Azmi0205/Bachelorarbeit/06Documentation/KickOff_Bachelorarbeit.pptx

## Kick-Off Bachelorarbeit

- 08.07.2026

- Azmi Beyrouti

Development and Implementation of a Permanent Magnet Synchronous Motor Control Platform

## Slide 2

Presentation title | Confidentiality rating © Diehl Aerospace – a Joint Diehl Thales Company

- Kick-Off Bachelorarbeit

- 01

- Vorstellung des Themas

05

Fragen zum Vorgehen

- 02

- Arbeitspunkte

- 03

- Projektabsicherung & Zielsetzung

- 04

- Ist-Stand

## Thema

- Kick-Off Bachelorarbeit

Development and Implementation of a Permanent Magnet Synchronous Motor Control Platform
Design einer Kontroll-Test-Plattform
- Soll erlauben PMSM-Motoren anzuschließen und Regelungsstrategien zu testen
  - Hierfür Integration verschiedener Sensoren
  - Anbindung an verschiedene Schnittstellen (weitere Sensoren, Kommunikation)
- Kompatibilität mit Wittenstein TPM Flight-Actuator
- Kompatibilität mit MatLab / Simulink Programmen
- Kommunikation mit Diehl Aerospace Flight Control Computer (FCC)
- Vorbild (Kommunikation & Performance): Volz DA 30-HT Aktuator

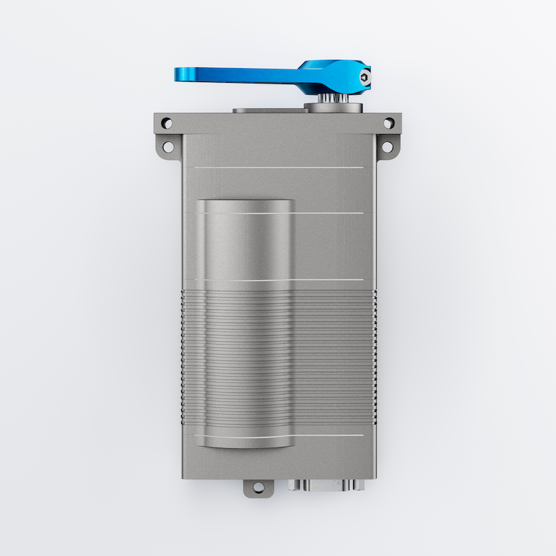
[picture p28: figure]

Volz DA 30-HT

## Arbeitspunkte

- Kick-Off Bachelorarbeit

Arbeitspunkte
  - (Definition von Requirements)
  - Design eines elektrischen Schaltplans
  - Layout & Bestellen einer Platine
  - Design und Implementierung des Codes
  - Testen und Analyse von Regelungen [Wenn die Zeit Reicht]
Aus T3000
  - Bauteilauswahl der elektrischen Schaltung
Bereits geschehen
  - Design des Schaltplans
  - Überprüfung der Kompatibilität durch Pinzuweisung
  - Erstes Layout

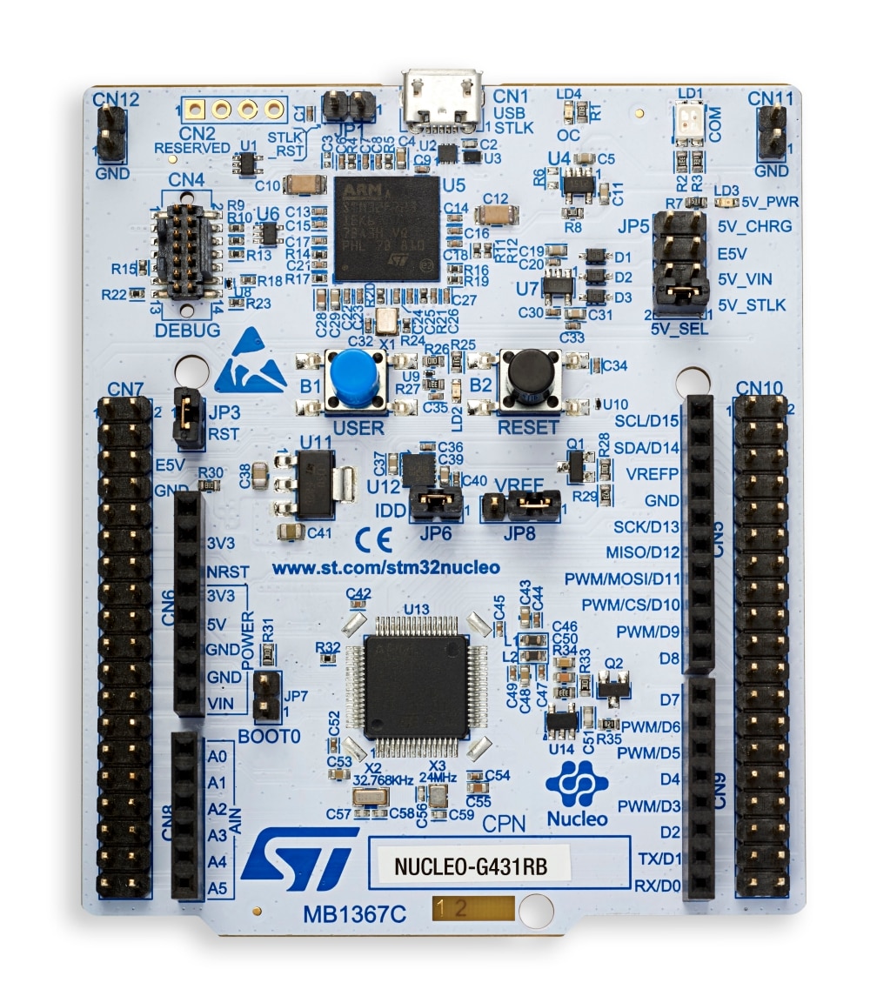
[picture p29: figure]
NUCLEO-G431RB | Product - STMicroelectronics

STM32 Nucleo G431RB

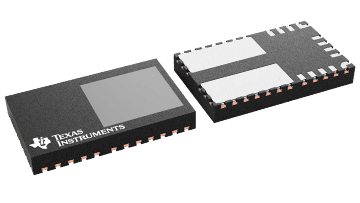
[picture p30: figure]
LMG2100R044 data sheet, product information and support | TI.com

TI LMG2100

## Absicherung & Zielsetzung

- Kick-Off Bachelorarbeit

Erstes elektronisches Design
  - Wenig Erfahrung
  - Erhöhtes Fehlerpotential
  - Nächste Iteration dauert Lange (Design & Bestellvorgang)
    - Risiko
Lösung -> Fallback
  - Inverter-Shield zur Regelung
  - Deckt Hauptfunktionen bereits ab
  - Möglich schon ohne Platine Code zu schreiben & zu Testen

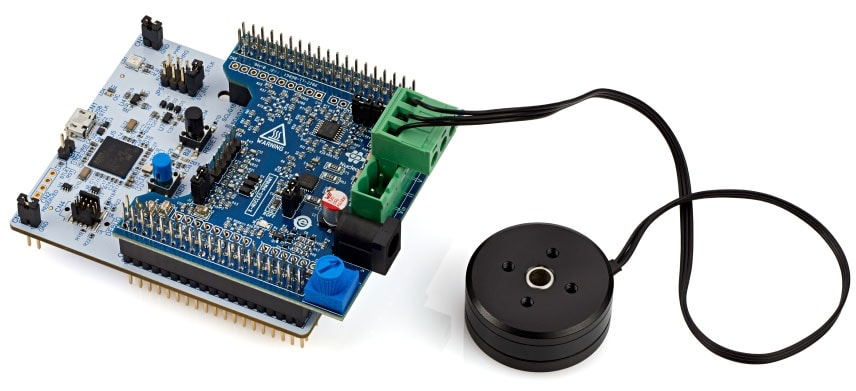
[picture p31: figure]

X-NUCLEO-IHM16M1

Zielsetzung
Ziel der Bachelorarbeit ist die Konzeption, Entwicklung und Inbetriebnahme einer modularen Kontroll-Test-Plattform für Permanentmagnet-Synchronmotoren. Dabei sollen die elektrische Hardware, die notwendigen Schnittstellen sowie die grundlegende Software umgesetzt werden, um PMSM-Motoren anzusteuern und verschiedene Regelungskonzepte testen und analysieren zu können.

## Ist-Stand

- Kick-Off Bachelorarbeit

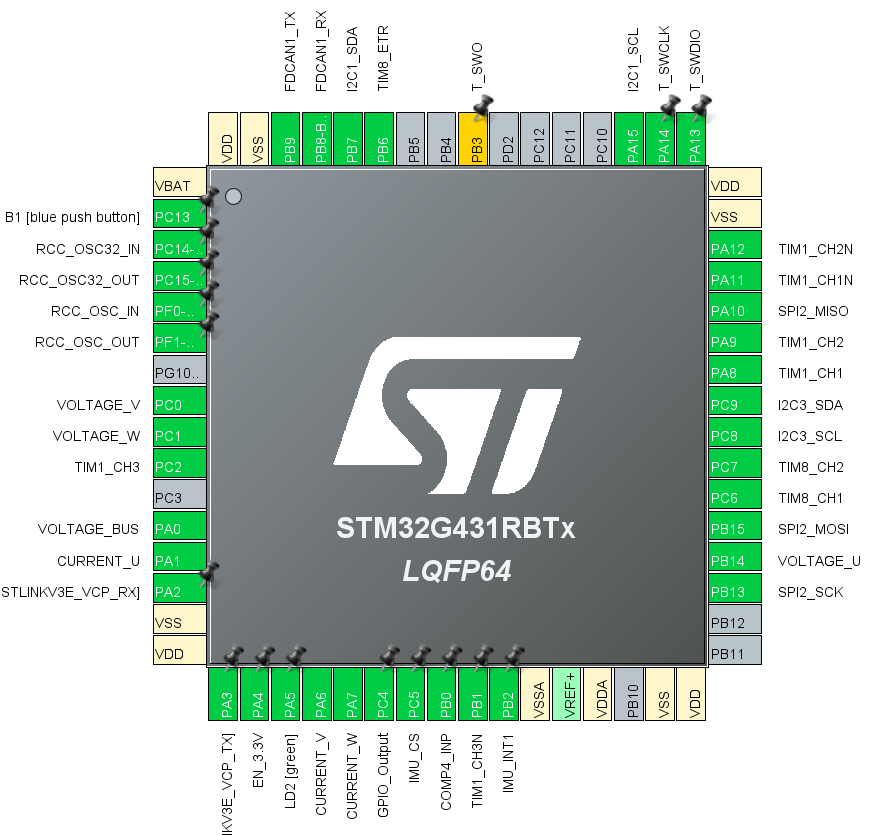
[picture p32: figure]

STM32 Pinzuweisung

Schaltplan einer Halbbrücke

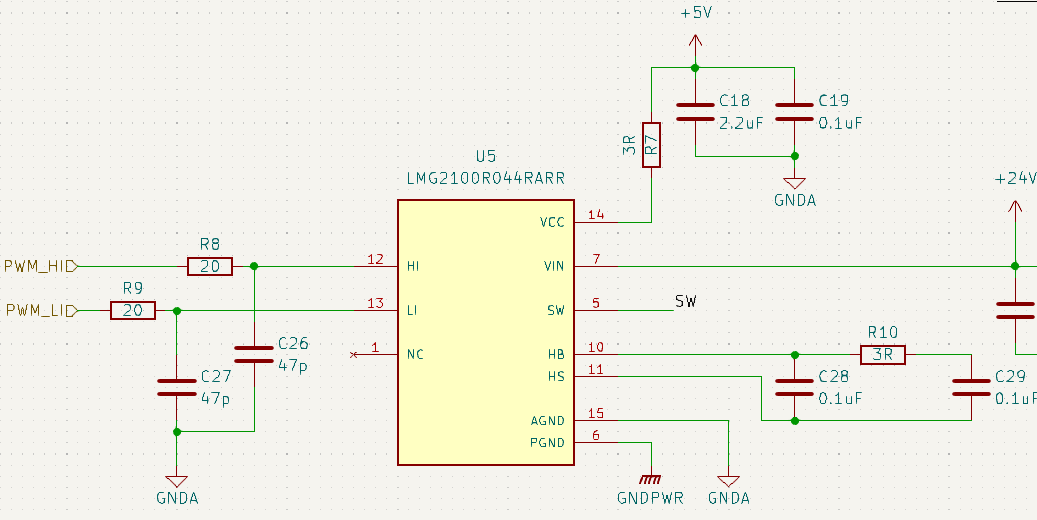
[picture p33: figure]
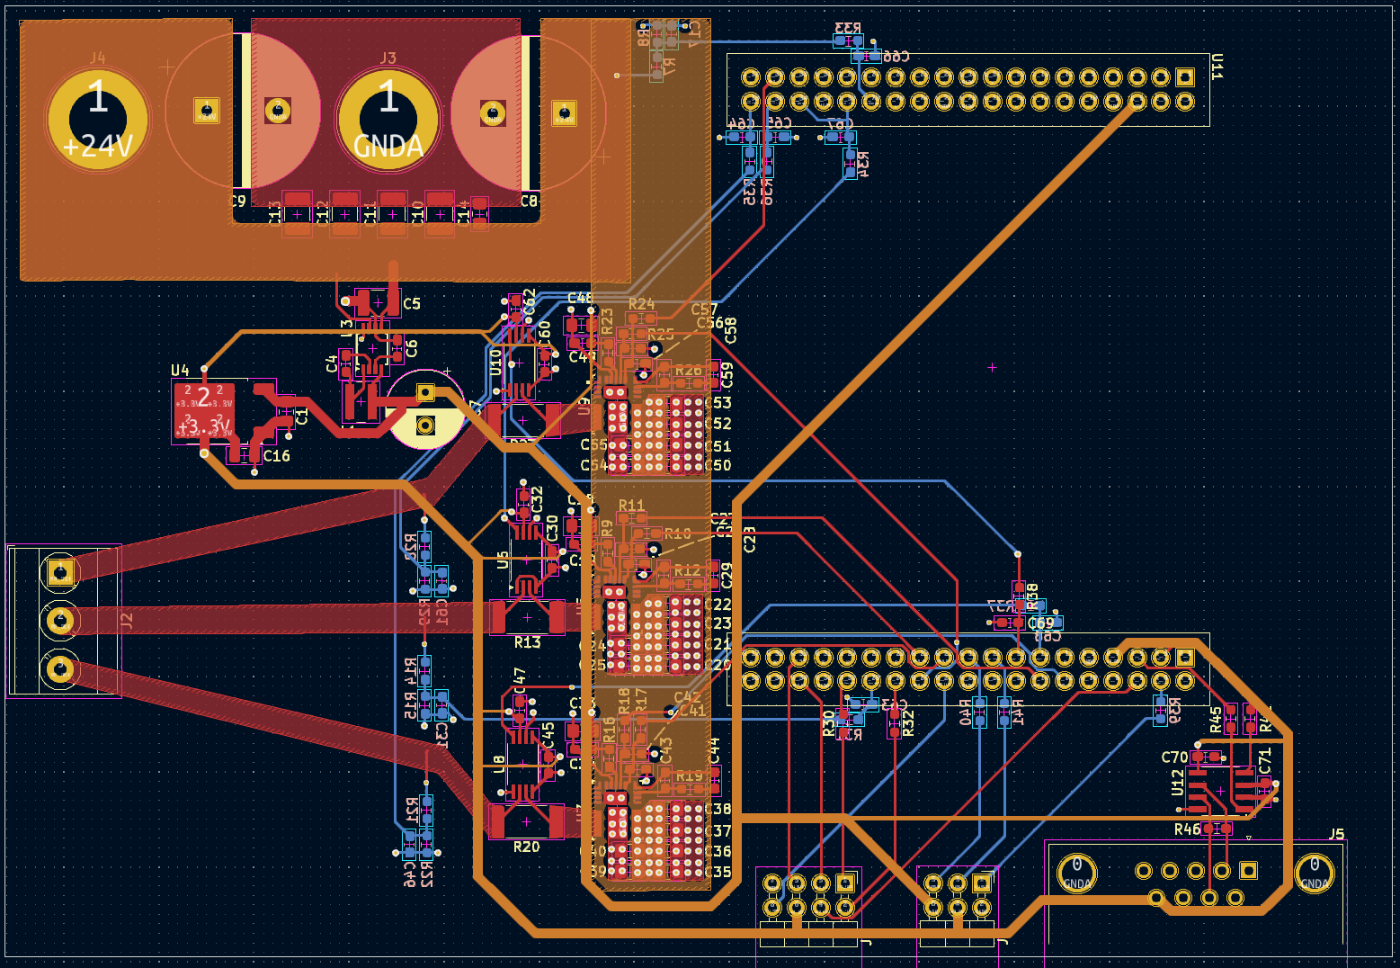
[picture p34: figure]

Layout der Testplattform

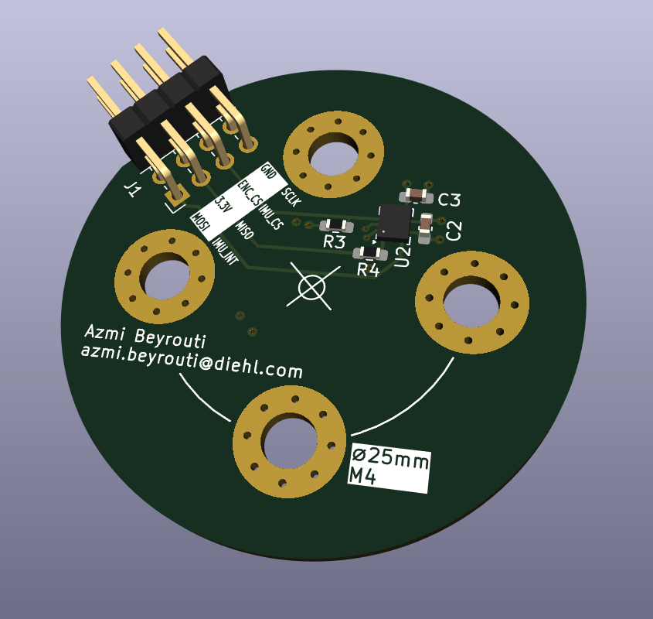
[picture p35: figure]

3D-Modell des Sensor-Moduls
