Azmi0205/Bachelorarbeit/09Bilder/SimulinkModels/Mechanical Dynamics.pdf

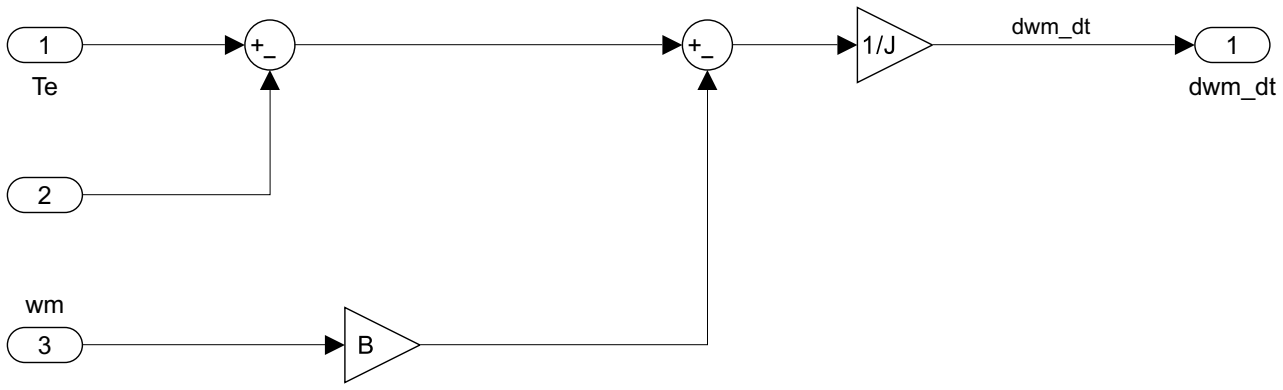
[picture p100: figure]
