Azmi0205/Bachelorarbeit/02PCB_Design/03BoMs/Bestückungsplan.jpg

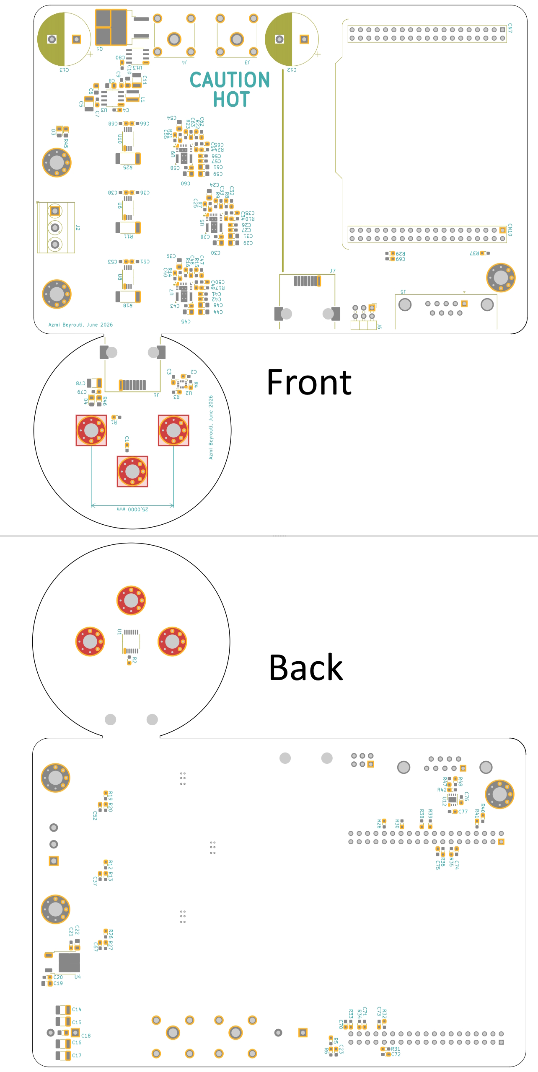
02PCB_Design/03BoMs/Bestückungsplan.jpg
