Azmi0205/Bachelorarbeit/04Experiments/6SC_High_Spectrum.png

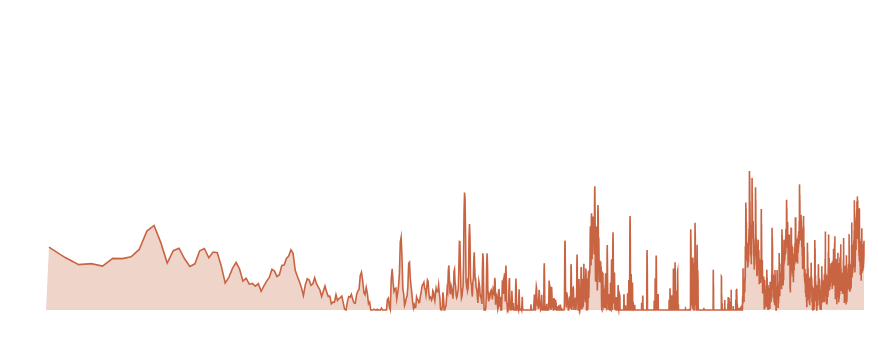
04Experiments/6SC_High_Spectrum.png
