Azmi0205/Bachelorarbeit/04Experiments/AudibleNoiseSpectrum/FOC_High_Spectrum.png

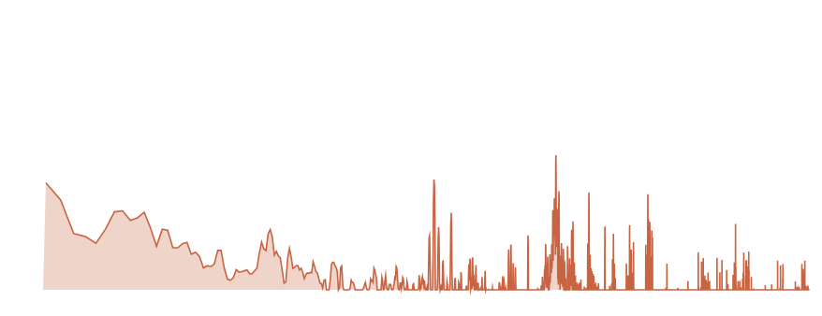
04Experiments/AudibleNoiseSpectrum/FOC_High_Spectrum.png
