Azmi0205/Bachelorarbeit/09Bilder/FOC_Block.png

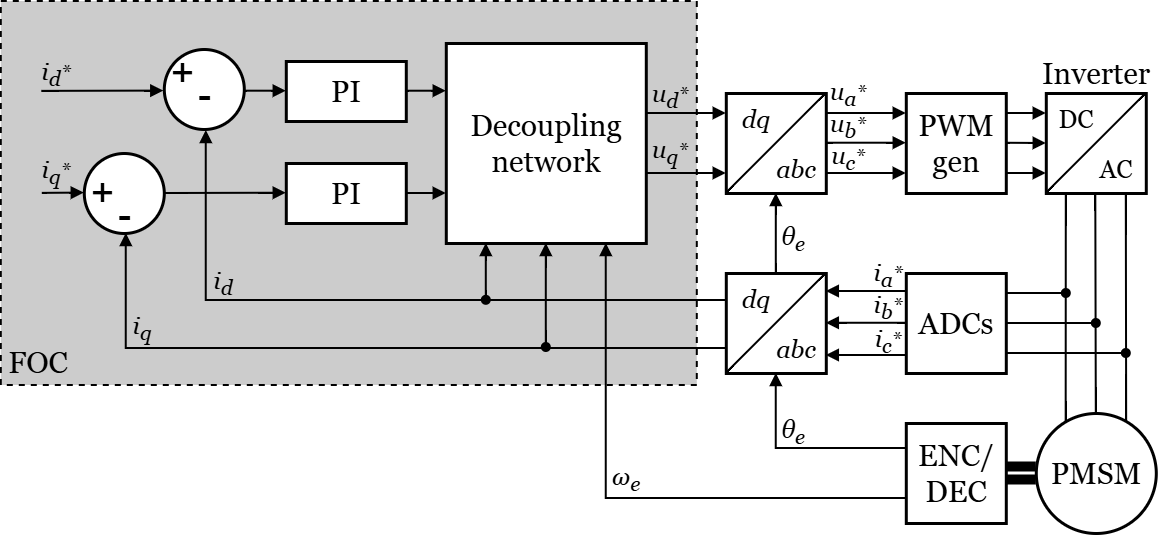
09Bilder/FOC_Block.png
