Azmi0205/Bachelorarbeit/09Bilder/HardwareOverview.png

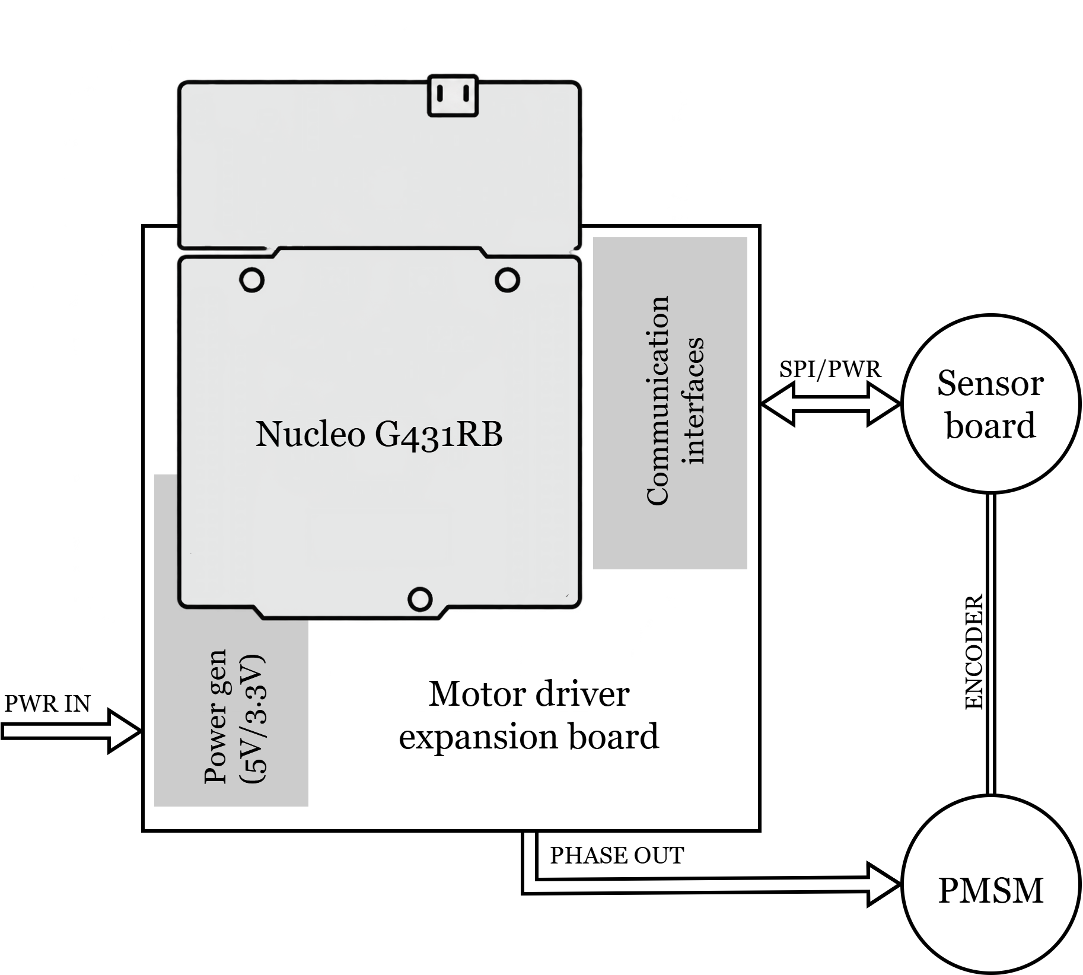
09Bilder/HardwareOverview.png
