Azmi0205/Bachelorarbeit/09Bilder/InputOutputConfiguration.png

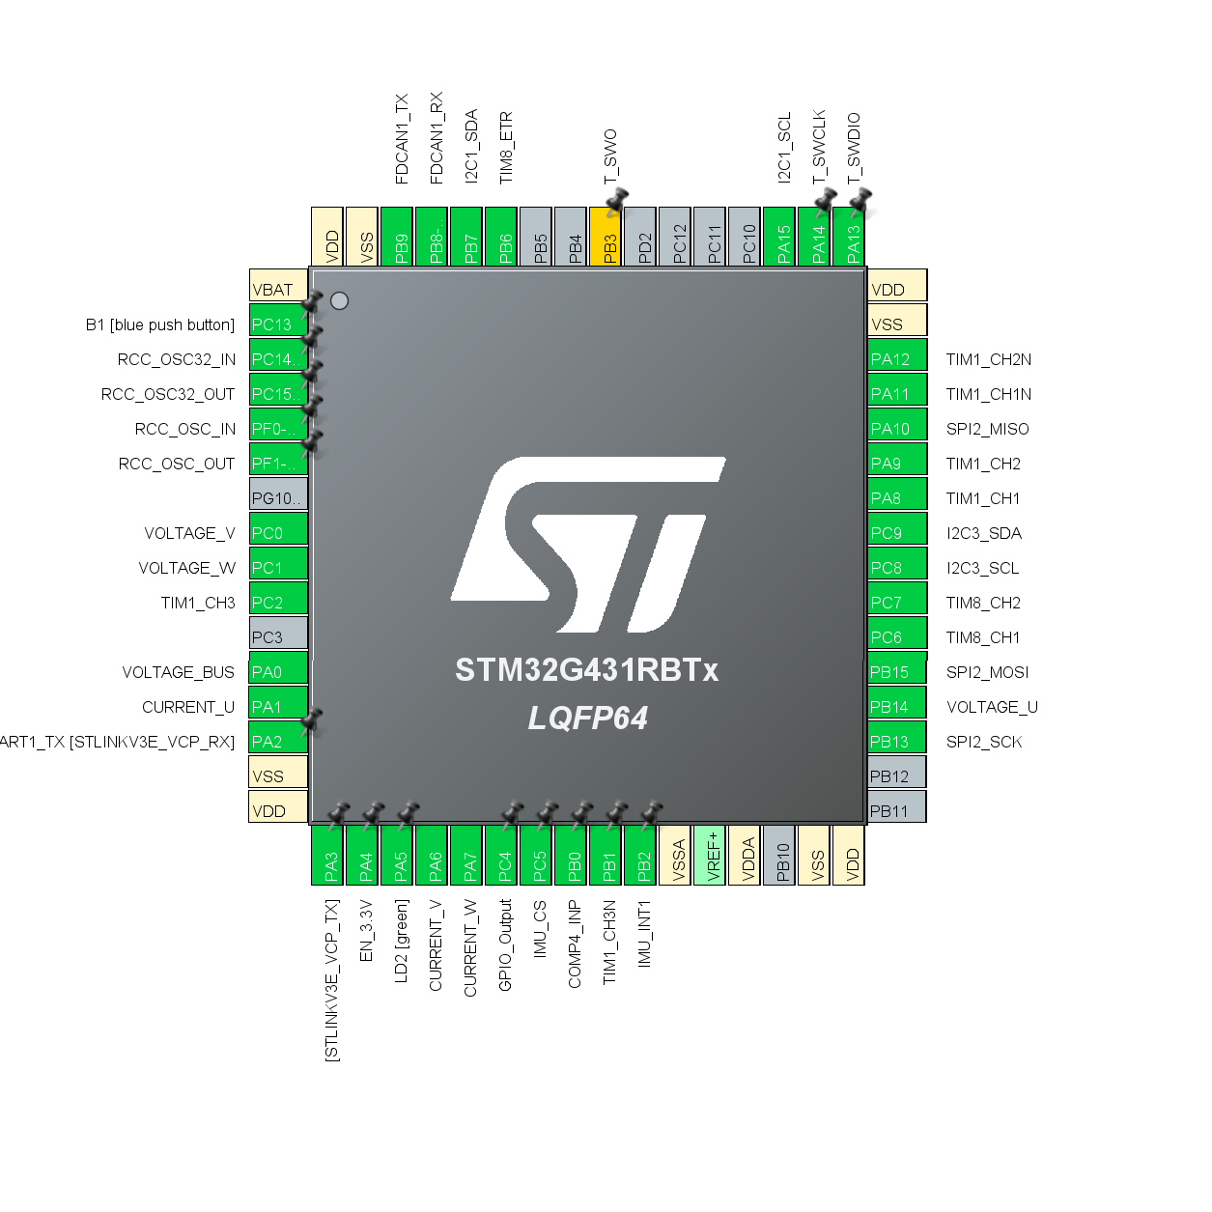
09Bilder/InputOutputConfiguration.png
