Azmi0205/Bachelorarbeit/09Bilder/Nucleo_Symbole.png

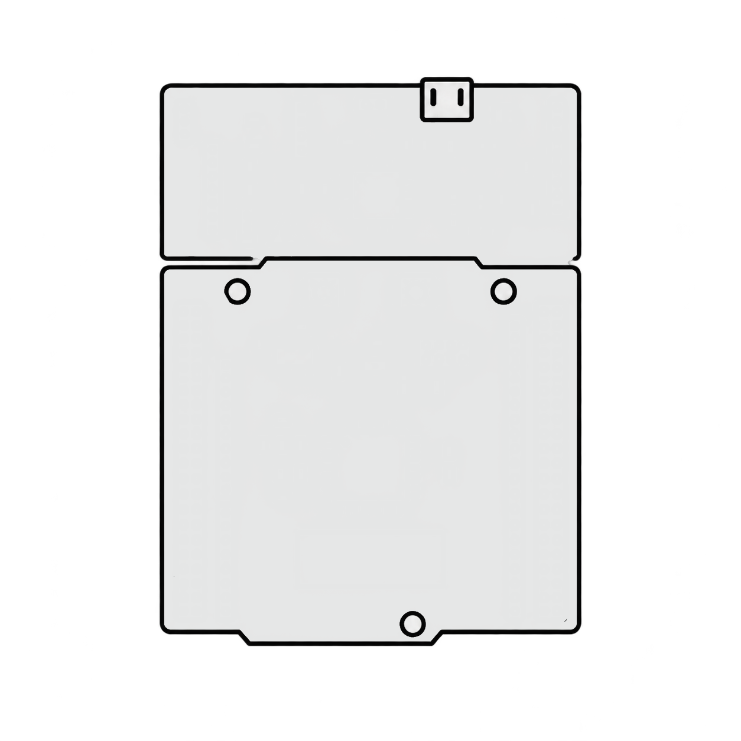
09Bilder/Nucleo_Symbole.png
