Azmi0205/Bachelorarbeit/09Bilder/polePairs.png

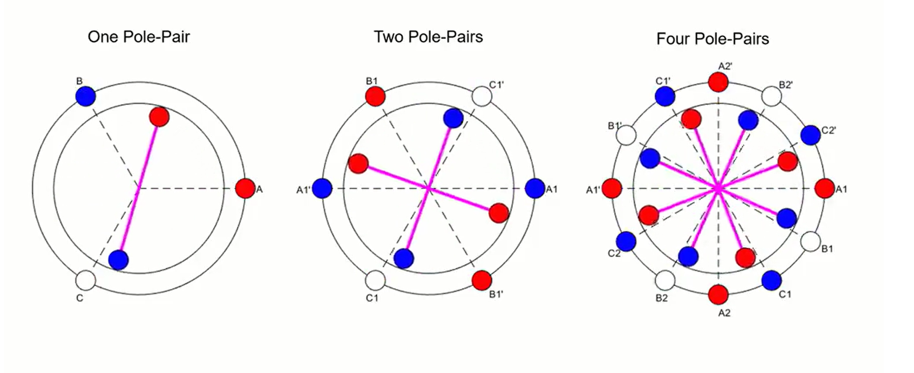
09Bilder/polePairs.png
