Azmi0205/Bachelorarbeit/09Bilder/PWM_Sinusoidal_Averaging.png

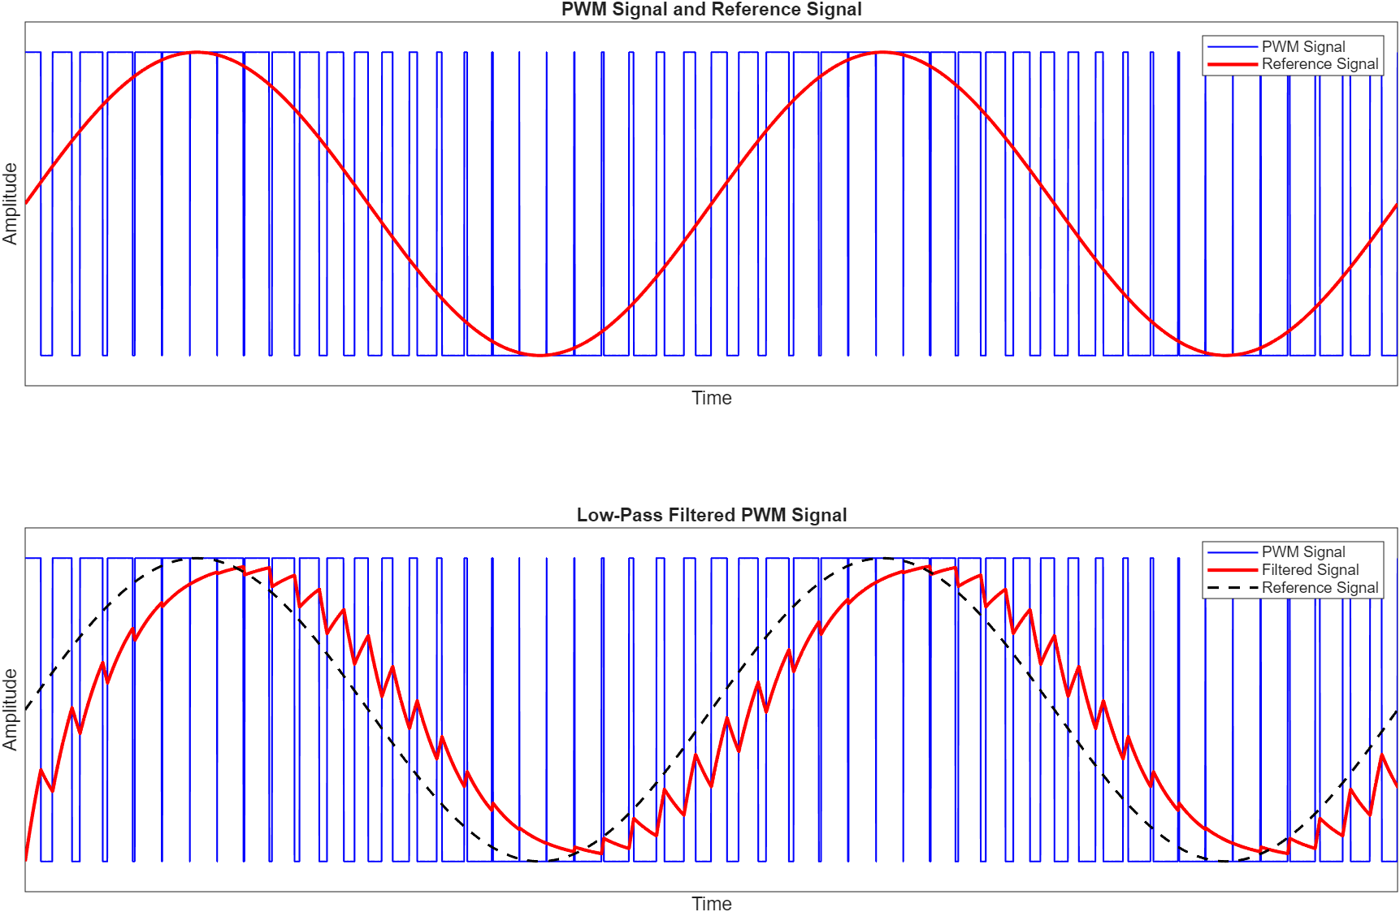
09Bilder/PWM_Sinusoidal_Averaging.png
