Azmi0205/Bachelorarbeit/09Bilder/Simulink_Scopes.png

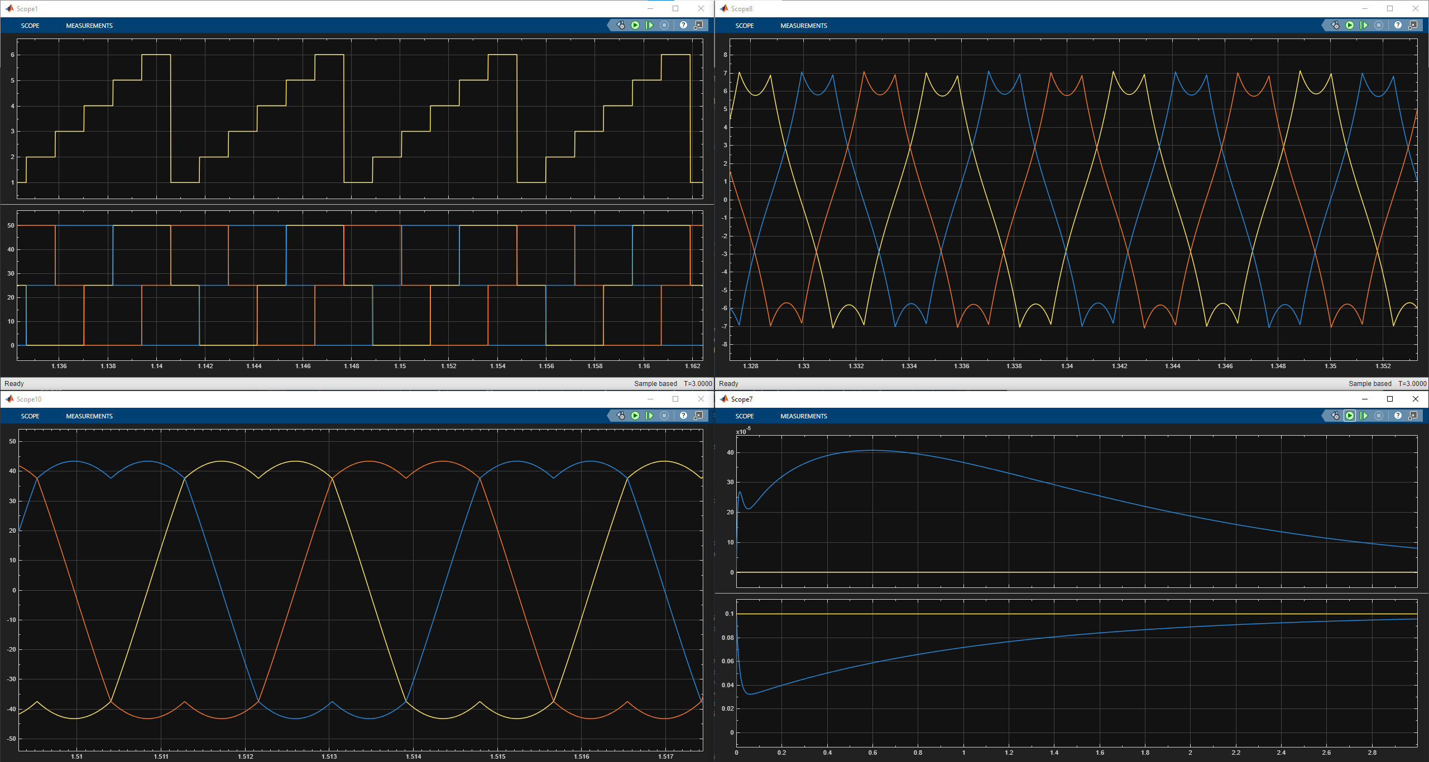
09Bilder/Simulink_Scopes.png
