Azmi0205/Bachelorarbeit/09Bilder/SinusoidalCommutation_Block.png

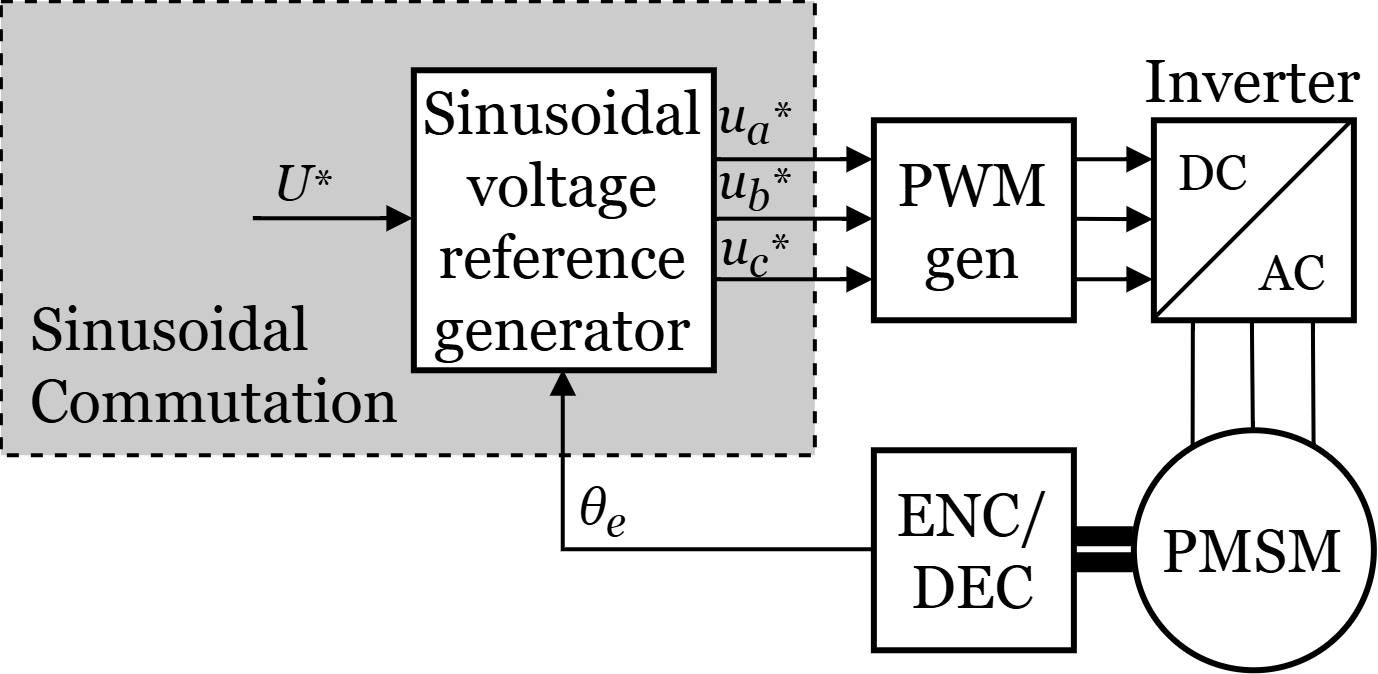
09Bilder/SinusoidalCommutation_Block.png
