Azmi0205/Bachelorarbeit/09Bilder/svpwm_pwm_switching_pattern.png

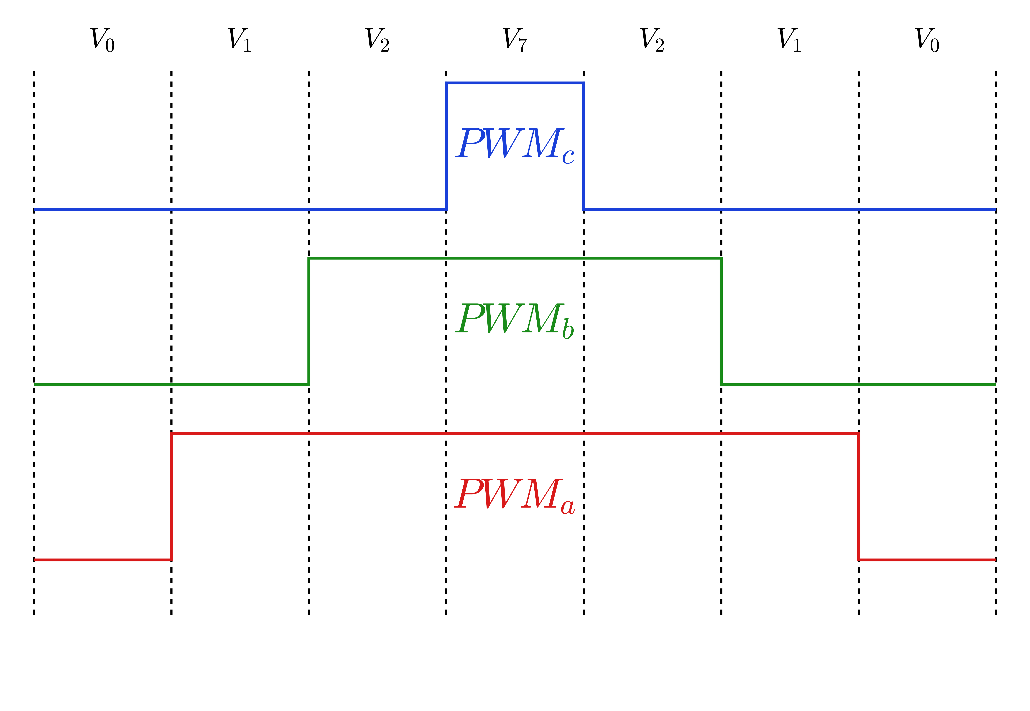
09Bilder/svpwm_pwm_switching_pattern.png
