Azmi0205/Bachelorarbeit/02PCB_Design/03BoMs/BetaLayout_BOM_Rückfrage.pdf

Part | Value | Device | Package | Description | Description2 | Qty | Place_YES
| /NO | Provided_b y_customer _YES/NO | Distributor | Ordernumber | Remarks_Customer
R1,R3,R19,R12,R5,R26 | 100k | RT0603BRD07100KL | R_0603 | Yageo RT Dünnschicht SMD-Widerstand 100 kΩ ±0.1 % / 0.1 W 25 ppm/°C | | 6 | YES | NO | Mouser | 603-RT0603BRD07 100KL | Changed Distributor
C12,C13 | 470uF | UPM2A471MHD | CP_Radial_D16.0mm | Aluminium Electrolytic Capacitors - Radial Leaded 100volts 470uF AEC-Q200 | | 2 | YES | NO | Mouser | 647-UPM2A471MH D | Changed Device + Distributor
U1 | AS5047P-ATSM | AS5047D-ATSM | TSSOP-14_4.4x5mm_P0.65mm | ams OSRAM 14-Bit-Magnetischer Drehpositionssensor auf der Achse 1-Achsen Oberfläche 3 V 7V SPI | Alternative: ams OSRAM Hall-Effekt-Sensor 1-Achsen Oberfläche 3 V 5.5V Pulsbreitenmodulation , UVW, SPI Achse CMOS TSSOP 14-Pin | 1 | YES | NO | Mouser | 985-AS5047D-ATSM | Changed Device (Use the older D-Variant of the Chip) + Distributor
R41,R48,R40,R47 | 0R | CRCW06030000Z0TAH P | R_0603 | Thick Film Resistors - SMD CRCW0603-HP 0R0 RT1 | | 4 | YES | NO | Mouser | 71-CRCW0603000 0Z0TAH | Changed Device + Distributor
