Azmi0205/Bachelorarbeit/02PCB_Design/03BoMs/BoM_Großteile.xlsx

BILL OF MATERIALS
Item to be created: |  | Motorcontrol Testing Rig
COMPONENT | DESCRIPTION | QTY | COST PER UNIT | SELLER | Note | Link
STM NUCLEO-G431RB | STM G431RB Mikrocontroller Development Board | 2 | 13.92 € | RS Components | - | https://de.rs-online.com/web/p/entwicklungstools-microcontroller/1962536
P-Nucleo-IHM03 | Entwicklungsbausatz inklusive NUCLEO G431RB | 1 | 72.56 € | RS Components | Nicht unbedingt nötig (bereits selbst bestellt) Wenn nicht: lieber noch einen STM NUCLEO-G431RB mehr | https://de.rs-online.com/web/p/entwicklungstools-fur-energie-motor-und-robotik/1962538
Texas Instruments LMG2100R044 | GaN-Halbbrücken Integrated-Power-Module inklusive Gate-Driver | 8 | 7.38 € | Mouser | - | https://www.mouser.de/ProductDetail/Texas-Instruments/LMG2100R044RARR?qs=ZcfC38r4PovtUeqDI2WsKQ%3D%3D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
Pilotix 6210 210KV | BLDC Motor mit offen gelegter Welle und hoher Polpaarzahl und übersetzung 1:1 | 2 | 128.30 € | Hobbydrone | Eigenschaften wichtig für die Testplatform | https://www.hobbydrone.cz/de/motor-pilotix-6210-210kv/
D8x4mm - N48 Diametral | Neodym Scheiben Magnet diametral | 5 | 0.87 € | neomagnete | - | https://www.neomagnete.de/de/detail/index/sArticle/212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
 |  | TOTAL COST: | 420.39 €
Bei RS Components erhältlich | Nicht bei RS Components erhältlich
Nicht bei Farnell/Mouser/Reichelt/Conrad erhältlich
