Azmi0205/Bachelorarbeit/02PCB_Design/03BoMs/T300_BoM_Erweitert.xlsx

BILL OF MATERIALS
Item to be created: |  | Motorcontrol Testing Rig
Qty to create: |  | 1
COMPONENT | DESCRIPTION | BASE QTY | COST PER UNIT | SELLER | Link
Pilotix 6210 210KV | BLDC Motor | 1 | 128.30 € | Hobbydrone | https://www.hobbydrone.cz/de/motor-pilotix-6210-210kv/
AMS AS5047P | Magnetencoder | 1 | 6.47 € | Mouser | https://www.mouser.de/ProductDetail/ams-OSRAM/AS5047P-ATSM?qs=cGEy3R83DS8fzNOVLHtOgg%3D%3D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
Texas Instruments LMG2100R044 | Halbbrücken + Gate-Driver IPM | 3 | 7.38 € | Mouser | https://www.mouser.de/ProductDetail/Texas-Instruments/LMG2100R044RARR?qs=ZcfC38r4PovtUeqDI2WsKQ%3D%3D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
STM P-NUCLEO-IHM03 | Mikrocontroller, Motorcontroller Set | 1 | 62.61 € | Mouser | https://www.mouser.de/ProductDetail/STMicroelectronics/P-NUCLEO-IHM03?qs=T3oQrply3y8PZpuhOvj%2FjQ%3D%3D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
Mean Well GST280A24-C6P | Desktopnetzteil | 1 | 87.76 € | Reichelt | https://www.reichelt.com/ch/de/shop/produkt/tischnetzteil_280_w_24_v_11_67_a-171084
Analog Devices ADAD2S1210CSTZ | Resolver-Digital Converter | 1 | 29.87 € | Mouser | https://www.mouser.de/ProductDetail/Analog-Devices/AD2S1210CSTZ?qs=NmRFExCfTkHtgjtWgbRPyA%3D%3D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
TDK ICM-45605 | Inertial Measurement Unit | 1 | 4.35 € | Mouser | https://www.mouser.de/ProductDetail/TDK-InvenSense/ICM-45605?qs=HoCaDK9Nz5cq5D4Jf8QQQg%3D%3D
STM NUCLEO-G431RB | Development Board (MCU) Ersatz | 1 | 13.66 € | Mouser | https://www.mouser.de/ProductDetail/STMicroelectronics/NUCLEO-G431RB?qs=T3oQrply3y%252BHSoH%2FYfQbYw%3D%3D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
D8x4mm - N48 | Neodym Scheiben Magnet diametral | 5 | 0.87 € | neomagnete | https://www.neomagnete.de/de/detail/index/sArticle/212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
Component 11
Component 12
Component 13
Component 14
Component 15
Component 16
Component 17
Component 18
Component 19
Component 20
 |  | TOTAL COST: | 359.51 €
