Azmi0205/Bachelorarbeit/02PCB_Design/02KiCad_Lib/AS5047P-ATSM/AS5047P-ATSM.step

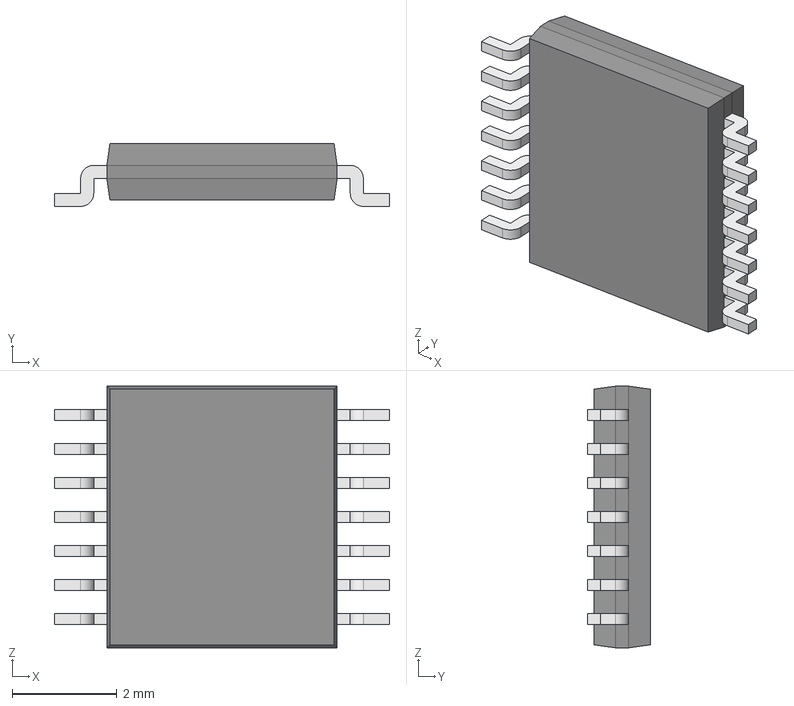
[picture p113: CAD file, 2026-01-22]
02PCB_Design/02KiCad_Lib/AS5047P-ATSM/AS5047P-ATSM.step
6.40 x 1.20 x 5.00 mm
Body001 (Mirror #1) x 7
XY-plane x 12
X-axis x 12
