Azmi0205/Bachelorarbeit/02PCB_Design/02KiCad_Lib/BM06B-GHS-TBT/BM06B-GHS-TBT.step

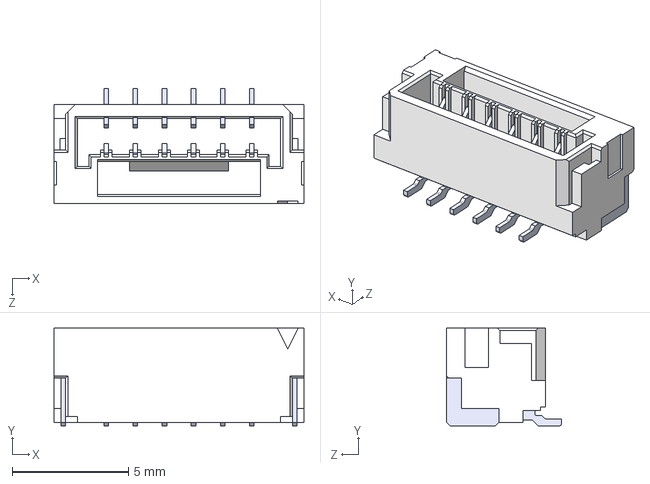
[picture p114: CAD file, 2026-01-22]
02PCB_Design/02KiCad_Lib/BM06B-GHS-TBT/BM06B-GHS-TBT.step
10.8 x 4.20 x 4.95 mm
