Azmi0205/Bachelorarbeit/02PCB_Design/02KiCad_Lib/ICM-40609-D/ICM-40609-D--3DModel-STEP-269445.STEP

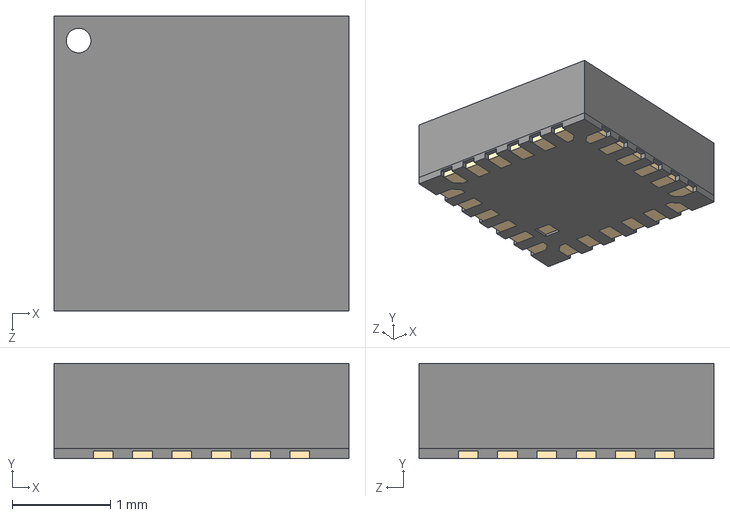
[picture p115: CAD file, 2026-01-22]
02PCB_Design/02KiCad_Lib/ICM-40609-D/ICM-40609-D--3DModel-STEP-269445.STEP
3.00 x 0.97 x 3.00 mm
