Azmi0205/Bachelorarbeit/02PCB_Design/02KiCad_Lib/ISM330BXTR/ISM330BXTR.step

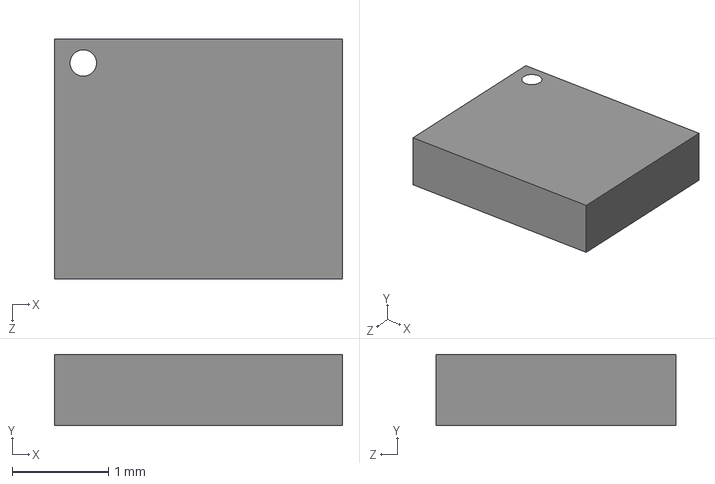
[picture p116: CAD file, 2026-01-22]
02PCB_Design/02KiCad_Lib/ISM330BXTR/ISM330BXTR.step
3.00 x 0.74 x 2.50 mm
