Azmi0205/Bachelorarbeit/02PCB_Design/02KiCad_Lib/MTSW-104-22-L-D-265-RA/MTSW-104-22-L-D-265-RA.stp

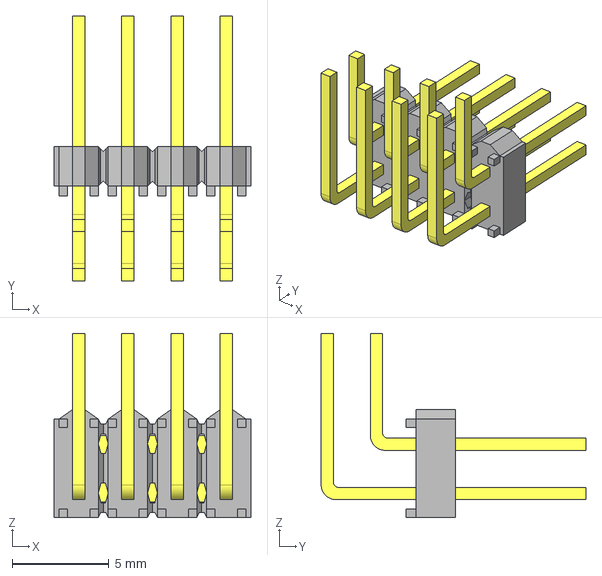
[picture p117: CAD file, 2026-01-22]
02PCB_Design/02KiCad_Lib/MTSW-104-22-L-D-265-RA/MTSW-104-22-L-D-265-RA.stp
10.2 x 13.7 x 9.50 mm
MTSW-104-22-L-D-265-RA_body
MTSW-104-22-D-265-RA
