Azmi0205/Bachelorarbeit/02PCB_Design/02KiCad_Lib/RJ45-8N-B/RJ45-8N-B.step

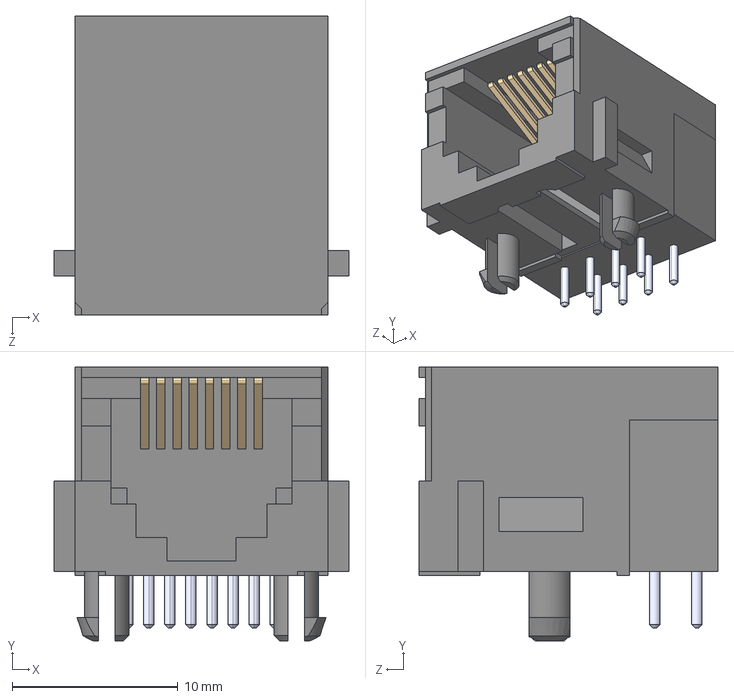
[picture p118: CAD file, 2026-07-15]
02PCB_Design/02KiCad_Lib/RJ45-8N-B/RJ45-8N-B.step
17.8 x 16.5 x 18.0 mm
