Azmi0205/Bachelorarbeit/02PCB_Design/02KiCad_Lib/Ti_LMG2100R044RARR/LMG2100R044RARR.stp

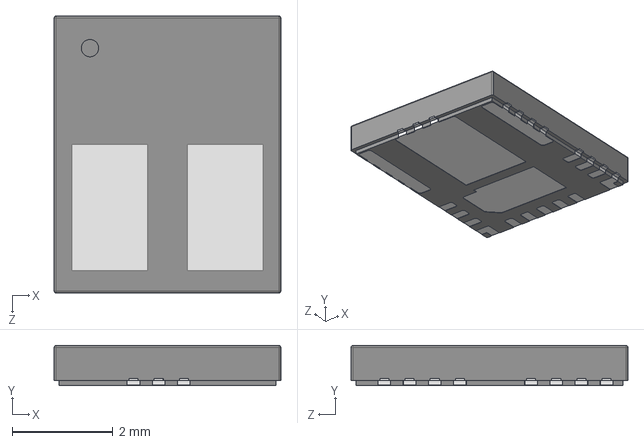
[picture p119: CAD file, 2026-07-20]
02PCB_Design/02KiCad_Lib/Ti_LMG2100R044RARR/LMG2100R044RARR.stp
4.50 x 0.8 x 5.50 mm
