Azmi0205/Bachelorarbeit/02PCB_Design/02KiCad_Lib/FCR7350R/FCR7350R.step

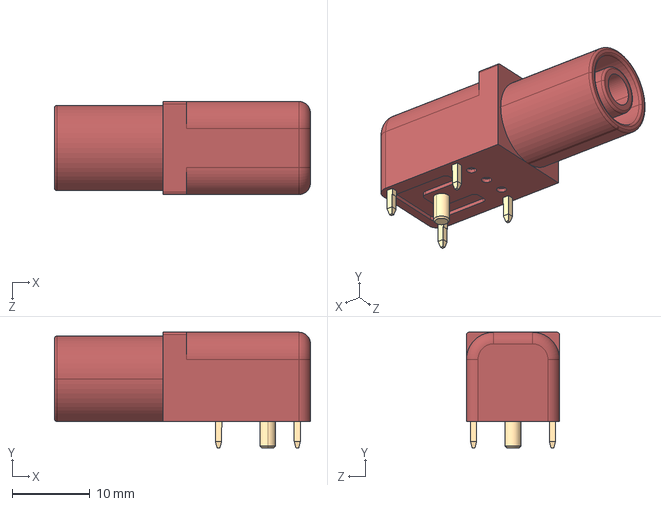
[picture p120: CAD file, 2026-01-22]
02PCB_Design/02KiCad_Lib/FCR7350R/FCR7350R.step
33.0 x 14.9 x 12.0 mm
