Azmi0205/Bachelorarbeit/02PCB_Design/02KiCad_Lib/1622309.stp

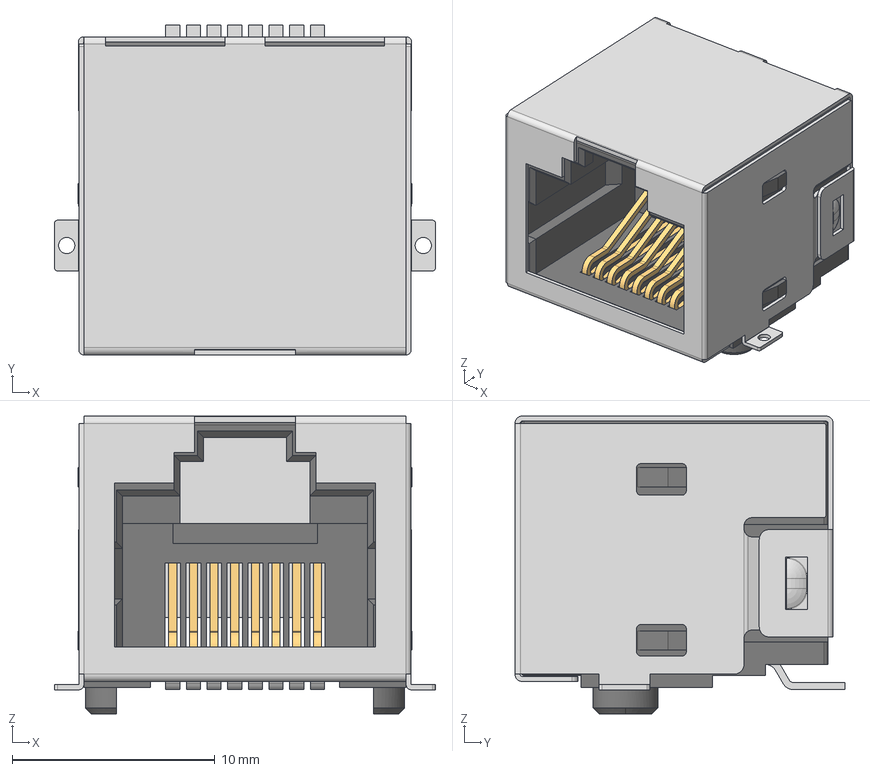
[picture p121: CAD file, 2026-07-20]
02PCB_Design/02KiCad_Lib/1622309.stp
18.8 x 16.3 x 14.7 mm
