Azmi0205/Bachelorarbeit/02PCB_Design/02KiCad_Lib/FCR7350R/1873802.stp

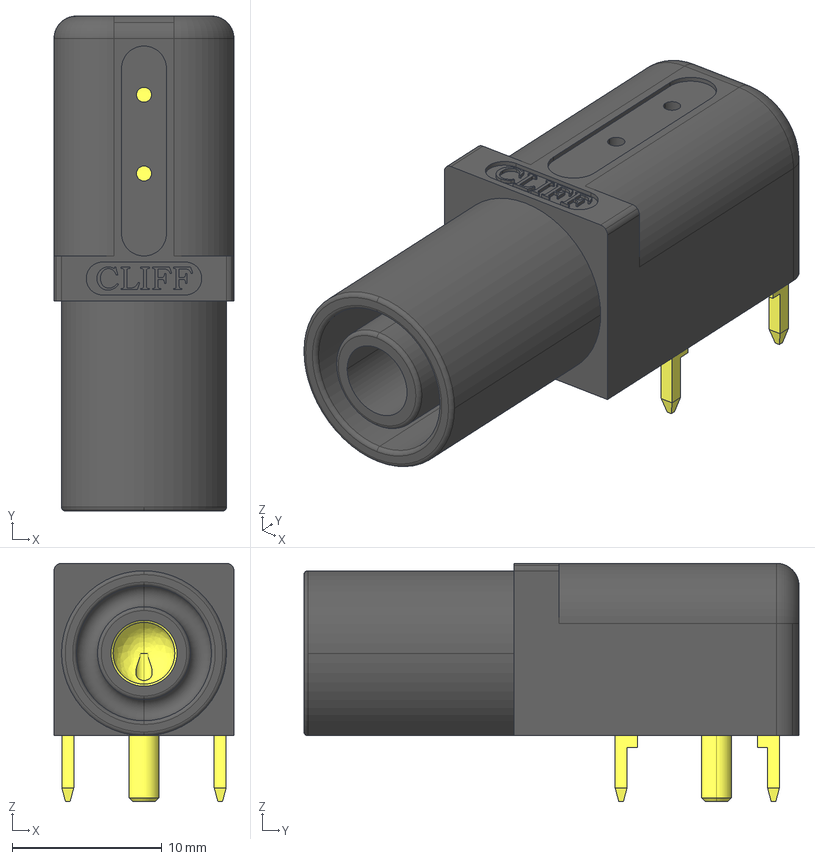
[picture p122: CAD file, 2026-07-21]
02PCB_Design/02KiCad_Lib/FCR7350R/1873802.stp
12.0 x 33.0 x 15.9 mm
