Azmi0205/Bachelorarbeit/09Bilder/ExperimentalSetup.png

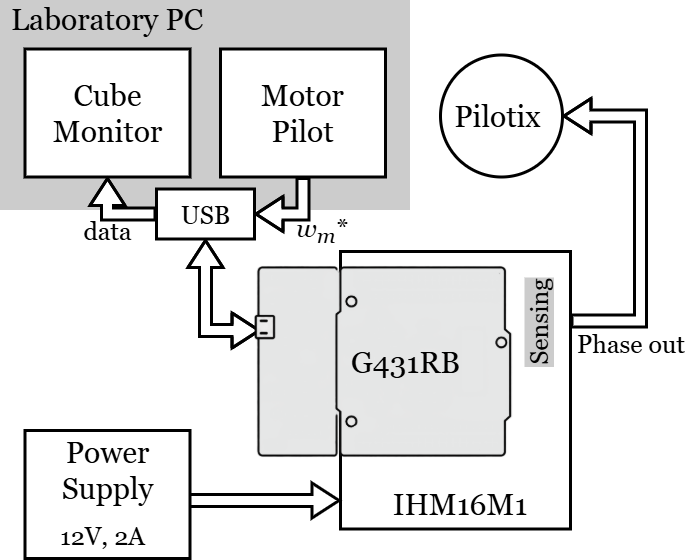
09Bilder/ExperimentalSetup.png
