Azmi0205/Bachelorarbeit/09Bilder/MCB_SixStep.png

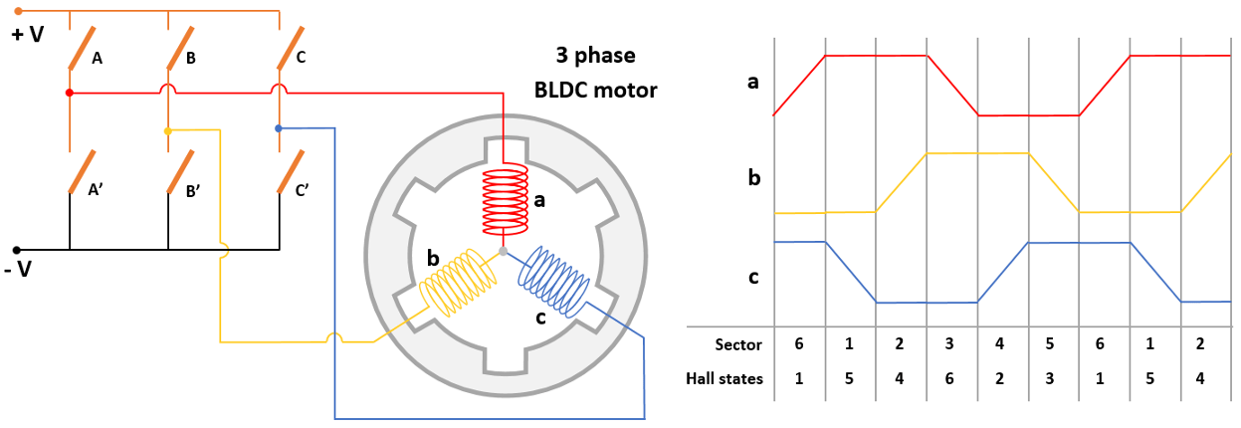
09Bilder/MCB_SixStep.png
