Azmi0205/Bachelorarbeit/04Experiments/ParameterIndentification/ParameterIdentification.docx

PMSM Parameter Identification Experiment Plan

# Base Parameters

Motor speed constant | K_V | 210(rpm)/V
Pole pairs | p | 14
Line-to-line resistance | R_(LL) | 42.5 mΩ
Stator radius | r_1 | 31mm
Motor radius | r_2 | 34,4mm
Motor mass | m_(motor) | 331g

# A: Identification Phase Resistance

R_s =(R_(LL))/2=42.5/2 mΩ=21.25 mΩ

# B: Identification Flux Linkage

1. Calculate torque constant.

K_t =60/(2∙π∙K_V)=60/(2⋅π⋅210(rpm)/V)= 0,04547(Nm)/A

2. Calculate flux linkage.

ψ_(PM) =(K_t)/(1.5⋅p)=(0,04547(Nm)/A)/(1.5⋅14)=2.165 mWb

# C: Identification Stator Inductance

1. Measure line to line inductance.

L_(LL,ab) = 40,27uH

L_(LL,ac) =31,78uH

L_(LL,ac) =32,80uH

L_(LL) =34,95uH

2. Calculate stator inductance.

L_s =(L_(LL))/2=17,475uH

# D: Identification Rotor Inertia

1. Obtain rotor geometry.

r_1 =31mm, r_2 =34,4mm,

m=120g (≈36%⋅m_(motor) , assumption)

2. Calculate rotor inertia.

J=1/2m(r_1^2 +r_2^2 )=1,29×10^(-4) kg⋅m^2

# E: Identification Viscous Friction Coefficient

1. Leave all phases open and connect oscilloscope.
2. Externally spin motor.
3. Measure back-EMF line-to-line voltage during deceleration.
4. Convert back-EMF to rotor speed.

ω(t)=(2π)/60⋅K_v ⋅V_(LL) (t)

5. Find maxima and minima.
6. Decide which are better suited for fit.

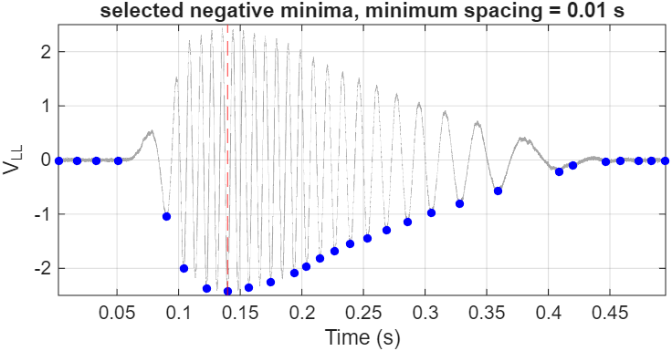
[picture p125: figure]

7. Take log and fit straight line.

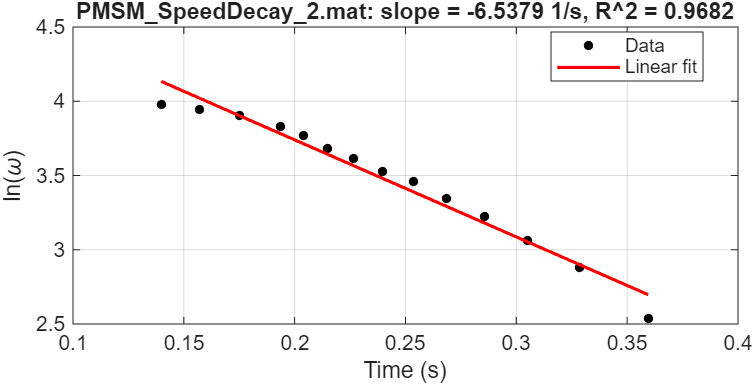
[picture p126: figure]

8. Determine slope.

B/J= -slope= 6.677861/s

9. Calculate viscous friction coefficient.

B=J⋅(B/J)= 0.000861444(Nms)/(rad)

# Final Parameter Set

Parameter | Value
Rs | 21.25 mOhm
Ls | 17.475 uH
psi_pm | 2.165 mWb
J | 1.29*10^-4 kg*m^2
B | 0.000861444 Nms/rad
