Azmi0205/Bachelorarbeit/04Experiments/6SC_High_Measurement.csv

time | USER_CPU_Load | USER_SPEED_AVR | USER_SPEED_MEAS | USER_SPEED_REF
116,423 | 2,114819288253784 | 1723,673095703125 | 1752,568603515625 | 1716
116,424 | 2,124504327774048 | 1702,31787109375 | 1567,486328125 | 1716
116,425 | 2,1092207431793213 | 1737,6866455078125 | 1838,3212890625 | 1716
116,426 | 2,835139036178589 | 1722,746826171875 | 1752,568603515625 | 1716
116,427 | 2,1929004192352295 | 1722,1300048828125 | 1618,1185302734375 | 1716
116,428 | 2,1176555156707764 | 1731,7421875 | 1646,934326171875 | 1716
116,429 | 2,185724973678589 | 1719,052001953125 | 1658,29248046875 | 1716
116,43 | 2,1103973388671875 | 1720,281982421875 | 1770,63623046875 | 1716
116,431 | 2,1638357639312744 | 1714,150146484375 | 1722,4384765625 | 1716
116,432 | 2,198023796081543 | 1706,2437744140625 | 1624,678466796875 | 1716
116,433 | 2,7970035076141357 | 1741,777587890625 | 1789,08056640625 | 1716
116,434 | 2,1233279705047607 | 1706,849365234375 | 1598,7528076171875 | 1716
116,435 | 2,178422451019287 | 1728,9404296875 | 1887,381591796875 | 1716
116,436 | 2,1650123596191406 | 1718,437744140625 | 1775,8671875 | 1716
116,437 | 2,1483747959136963 | 1722,746826171875 | 1667,4925537109375 | 1716
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
