Azmi0205/Bachelorarbeit/04Experiments/Measurements/6SC_Low_Measurement.csv

time | USER_CPU_Load | USER_SPEED_AVR | USER_SPEED_MEAS | USER_SPEED_REF
0 | 0,615220308303833 | 188,08119201660156 | 165,373046875 | 186
0,001 | 0,6155266165733337 | 190,25013732910156 | 226,11660766601562 | 186
0,002 | 0,6143501400947571 | 190,25013732910156 | 226,11660766601562 | 186
0,004 | 0,6918084621429443 | 190,25013732910156 | 226,11660766601562 | 186
0,005 | 0,6103675365447998 | 190,25013732910156 | 226,11660766601562 | 186
0,006 | 0,6100611686706543 | 190,2313232421875 | 167,58602905273438 | 186
0,007 | 0,6924211978912354 | 190,2313232421875 | 167,58602905273438 | 186
0,008 | 0,6140437722206116 | 190,2313232421875 | 167,58602905273438 | 186
0,009 | 0,6143501400947571 | 187,97091674804688 | 205,16416931152344 | 186
0,01 | 0,6155266165733337 | 187,97091674804688 | 205,16416931152344 | 186
0,011 | 0,6143501400947571 | 187,97091674804688 | 205,16416931152344 | 186
0,012 | 0,6103675365447998 | 187,97091674804688 | 205,16416931152344 | 186
0,013 | 0,611237645149231 | 189,00148010253906 | 174,24087524414062 | 186
0,014 | 0,6100611686706543 | 189,00148010253906 | 174,24087524414062 | 186
0,015 | 0,6903256773948669 | 189,00148010253906 | 174,24087524414062 | 186
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
