Azmi0205/Bachelorarbeit/04Experiments/Measurements/6SC_Ramp_Measurement.csv

time | USER_CPU_Load | USER_SPEED_AVR | USER_SPEED_MEAS | USER_SPEED_REF
356,357 | 0,6150670647621155 | 188,87899780273438 | 172,9873504638672 | 186
356,358 | 0,6141969561576843 | 189,9608154296875 | 210,77525329589844 | 186
356,36 | 0,615373432636261 | 189,9608154296875 | 210,77525329589844 | 186
356,361 | 0,610214352607727 | 189,9608154296875 | 210,77525329589844 | 186
356,363 | 0,6110844612121582 | 189,150146484375 | 172,7884521484375 | 186
356,364 | 0,6910915374755859 | 189,150146484375 | 172,7884521484375 | 186
356,365 | 0,6138906478881836 | 189,150146484375 | 172,7884521484375 | 186
356,366 | 0,615373432636261 | 190,1185302734375 | 223,5103302001953 | 186
356,367 | 0,6141969561576843 | 190,1185302734375 | 223,5103302001953 | 186
356,368 | 0,6904788017272949 | 190,1185302734375 | 223,5103302001953 | 186
356,369 | 0,6113908290863037 | 190,1185302734375 | 223,5103302001953 | 186
356,37 | 0,6099080443382263 | 189,50045776367188 | 162,22669982910156 | 186
356,372 | 0,6946209669113159 | 189,50045776367188 | 162,22669982910156 | 186
356,373 | 0,6138906478881836 | 189,50045776367188 | 162,22669982910156 | 186
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
