Azmi0205/Bachelorarbeit/04Experiments/Measurements/FOC_High_Measurement.csv

time | USER_CPU_Load | USER_SPEED_MEAS | USER_SPEED_REF
1117,978 | 37,971763610839844 | 1722,499267578125 | 1716
1117,979 | 38,148231506347656 | 1724,461181640625 | 1716
1117,98 | 38,07823181152344 | 1728,3848876953125 | 1716
1117,981 | 37,97235107421875 | 1724,461181640625 | 1716
1117,982 | 38,16646957397461 | 1710,728271484375 | 1716
1117,983 | 37,53058624267578 | 1710,728271484375 | 1716
1117,984 | 38,148231506347656 | 1724,461181640625 | 1716
1117,985 | 38,07823181152344 | 1730,3466796875 | 1716
1117,986 | 37,97235107421875 | 1728,3848876953125 | 1716
1117,987 | 38,16646957397461 | 1710,728271484375 | 1716
1117,988 | 37,53117752075195 | 1710,728271484375 | 1716
1117,989 | 38,14882278442383 | 1722,499267578125 | 1716
1117,99 | 38,07823181152344 | 1730,3466796875 | 1716
1117,991 | 38,41353225708008 | 1724,461181640625 | 1716
1117,992 | 38,16587829589844 | 1706,8046875 | 1716
1117,993 | 37,53058624267578 | 1710,728271484375 | 1716
1117,994 | 38,148231506347656 | 1724,461181640625 | 1716
1117,995 | 38,07823181152344 | 1730,3466796875 | 1716
1117,996 | 38,412353515625 | 1722,499267578125 | 1716
1117,997 | 38,16823196411133 | 1710,728271484375 | 1716
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
