Azmi0205/Bachelorarbeit/04Experiments/Measurements/FOC_Low_Measurement.csv

time | USER_CPU_Load | USER_SPEED_MEAS | USER_SPEED_REF
1184,705 | 37,92529296875 | 190,29888916015625 | 186
1184,706 | 38,36705780029297 | 190,29888916015625 | 186
1184,707 | 38,36882019042969 | 190,29888916015625 | 186
1184,708 | 38,369407653808594 | 190,29888916015625 | 186
1184,709 | 38,369998931884766 | 190,29888916015625 | 186
1184,71 | 38,10529327392578 | 192,2607421875 | 186
1184,711 | 38,10647201538086 | 192,2607421875 | 186
1184,712 | 38,10588073730469 | 190,29888916015625 | 186
1184,713 | 38,10293960571289 | 188,33705139160156 | 186
1184,714 | 38,12058639526367 | 188,33705139160156 | 186
1184,715 | 38,12234878540039 | 188,33705139160156 | 186
1184,717 | 38,034706115722656 | 190,29888916015625 | 186
1184,719 | 38,03823471069336 | 190,29888916015625 | 186
1184,72 | 38,03764724731445 | 190,29888916015625 | 186
1184,721 | 37,48646926879883 | 192,2607421875 | 186
1184,722 | 37,48588180541992 | 192,2607421875 | 186
1184,723 | 37,487648010253906 | 190,29888916015625 | 186
1184,724 | 37,48823547363281 | 190,29888916015625 | 186
1184,725 | 37,93058776855469 | 190,29888916015625 | 186
1184,726 | 37,932350158691406 | 188,33705139160156 | 186
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
