Azmi0205/Bachelorarbeit/04Experiments/Measurements/FOC_Ramp_Measurement.csv

time | USER_CPU_Load | USER_SPEED_MEAS | USER_SPEED_REF
1246,346 | 37,72117614746094 | 186,37521362304688 | 186
1246,347 | 37,77411651611328 | 186,37521362304688 | 186
1246,35 | 38,21529006958008 | 188,33705139160156 | 186
1246,351 | 38,21529006958008 | 190,29888916015625 | 186
1246,352 | 38,21529006958008 | 188,33705139160156 | 186
1246,354 | 37,95058822631836 | 188,33705139160156 | 186
1246,356 | 37,95058822631836 | 186,37521362304688 | 186
1246,357 | 37,95058822631836 | 188,33705139160156 | 186
1246,358 | 37,96823501586914 | 188,33705139160156 | 186
1246,359 | 38,07411575317383 | 188,33705139160156 | 186
1246,36 | 37,96823501586914 | 188,33705139160156 | 186
1246,361 | 37,87999725341797 | 190,29888916015625 | 186
1246,362 | 37,87999725341797 | 192,2607421875 | 186
1246,364 | 37,87999725341797 | 190,29888916015625 | 186
1246,365 | 37,33293914794922 | 190,29888916015625 | 186
1246,367 | 37,438819885253906 | 188,33705139160156 | 186
1246,369 | 37,77411651611328 | 188,33705139160156 | 186
1246,371 | 37,77411651611328 | 186,37521362304688 | 186
1246,372 | 37,77411651611328 | 188,33705139160156 | 186
1246,373 | 38,21529006958008 | 188,33705139160156 | 186
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
