Azmi0205/Bachelorarbeit/02PCB_Design/Testplatine.pdf

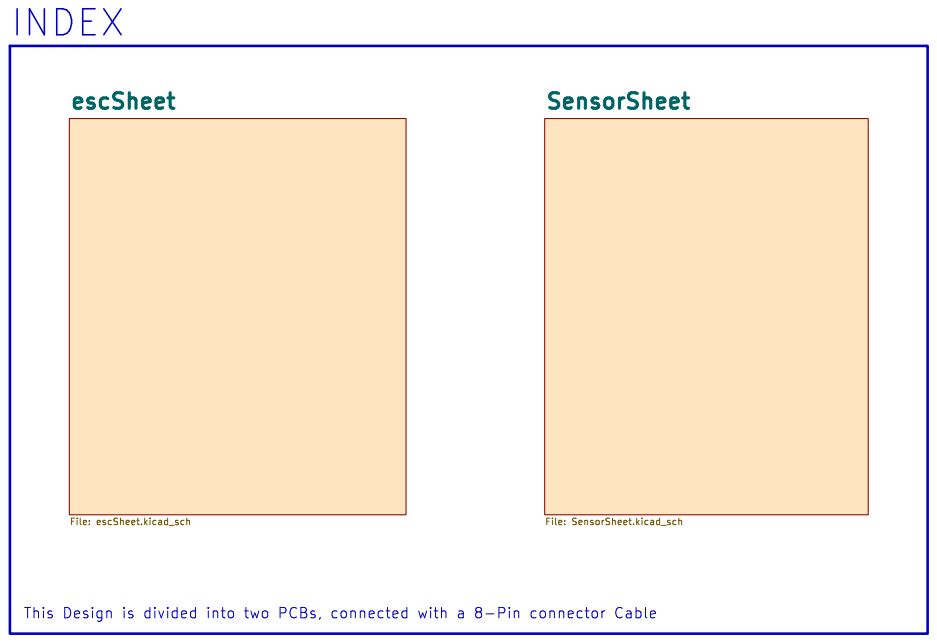
[picture p127: page 1]

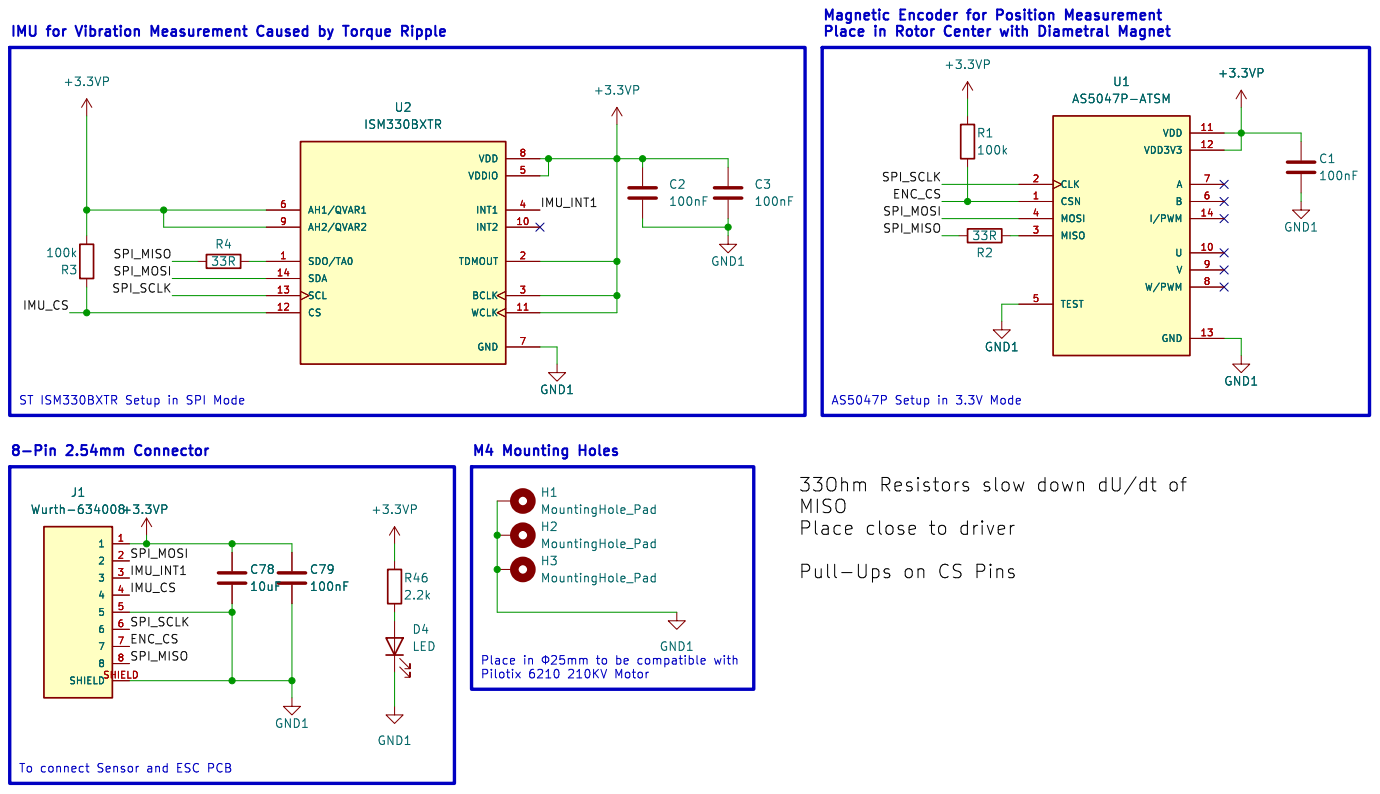
[picture p128: page 2]

IMU for Vibration Measurement Caused by Torque Ripple

MISO
Place close to driver

To connect Sensor and ESC PCB

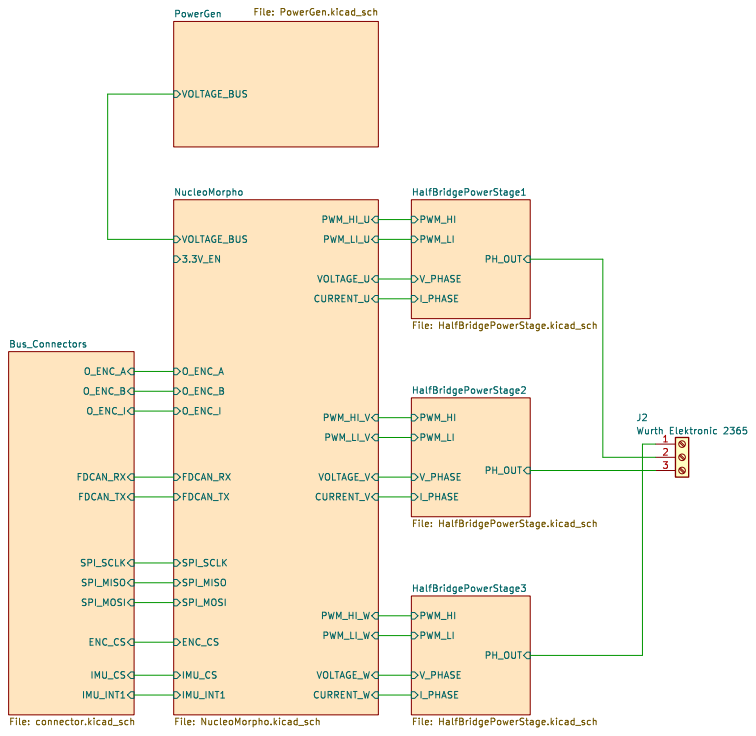
[picture p129: page 3]

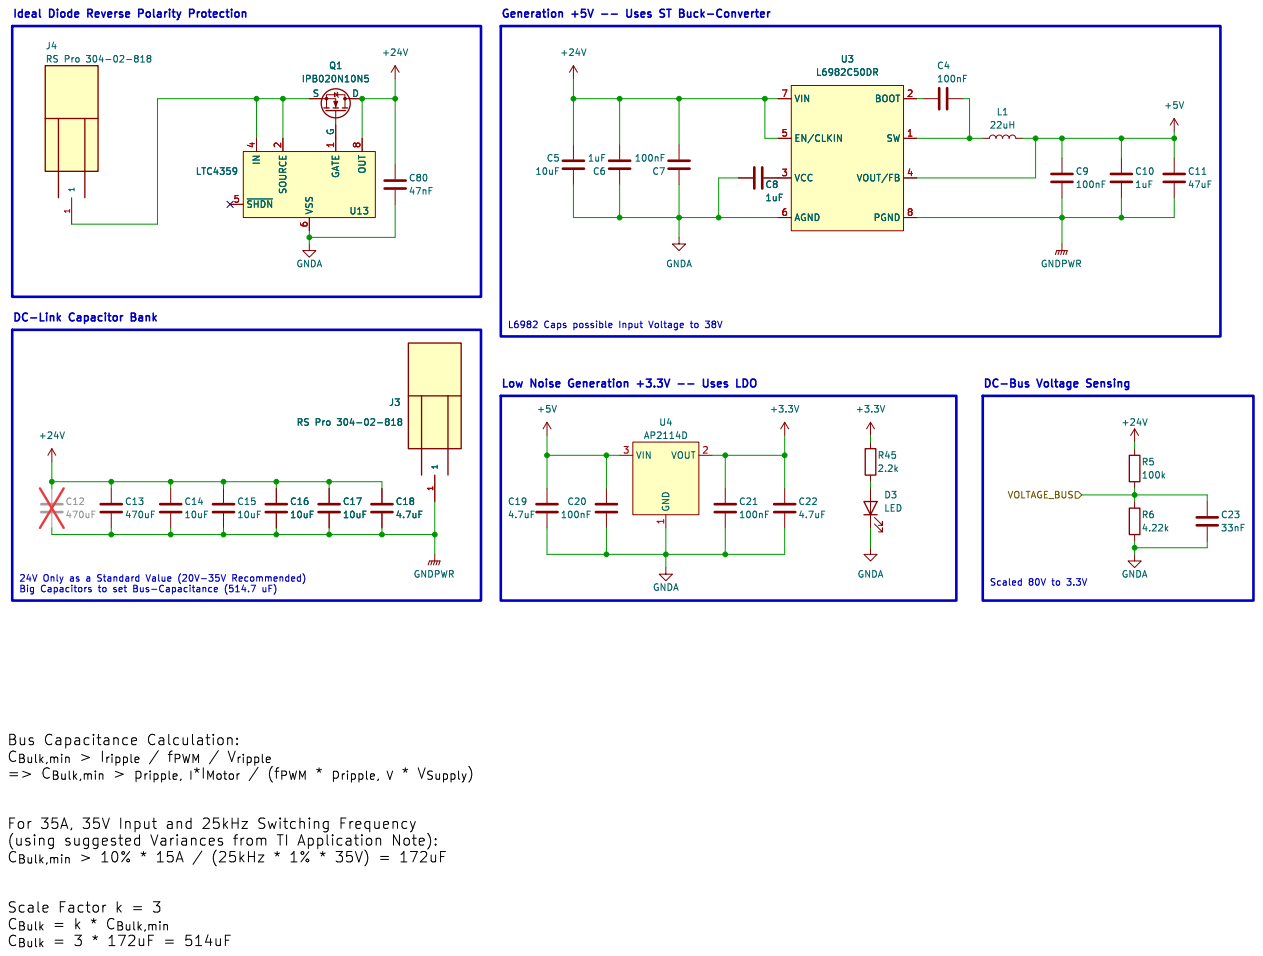
[picture p130: page 4]

For 35A, 35V Input and 25kHz Switching Frequency
C_{Bulk,min}> 10% * 15A / (25kHz * 1% * 35V) = 172uF

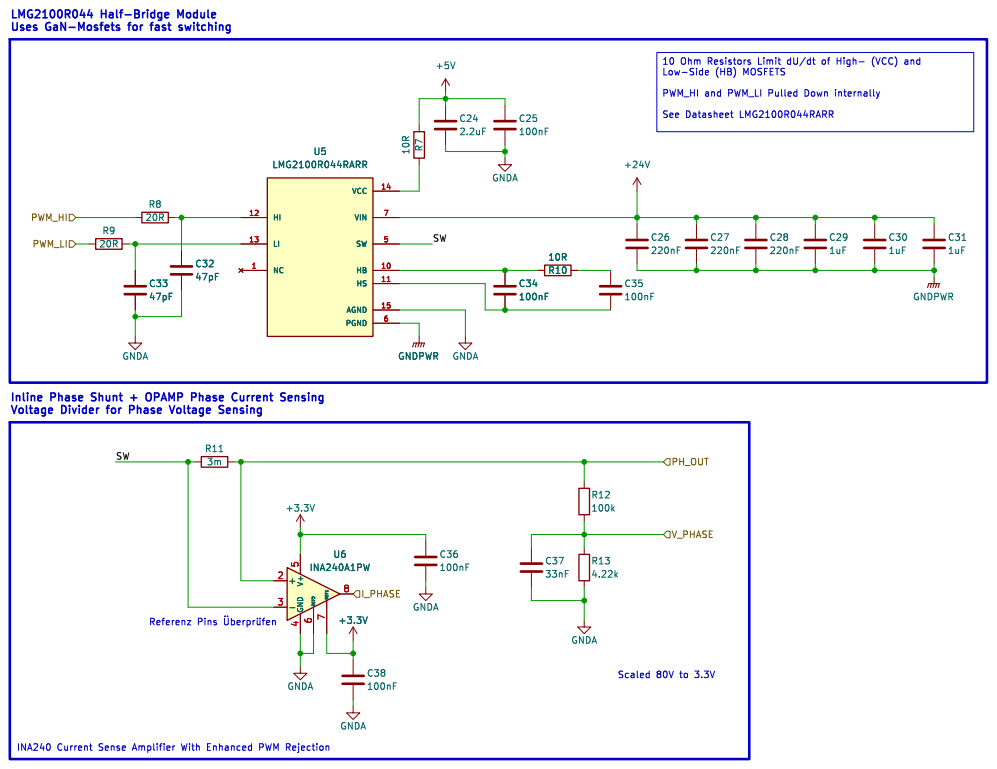
[picture p131: page 5]

Scaled 80V to 3.3V Referenz Pins þÿÜberprüfen

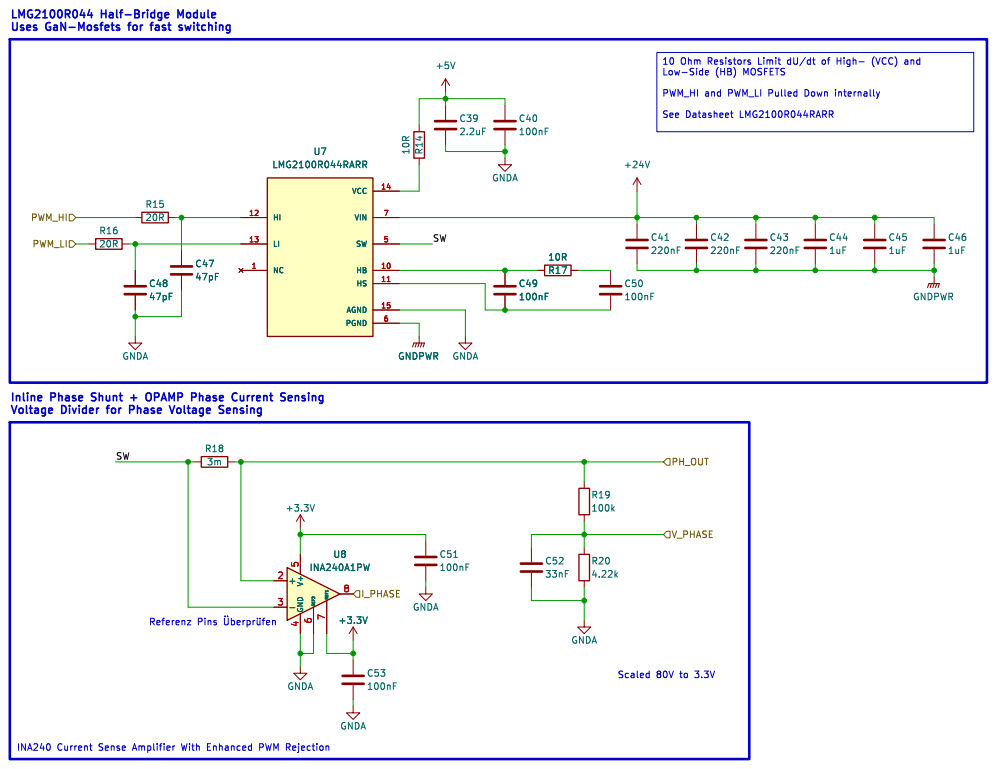
[picture p132: page 6]

Scaled 80V to 3.3V Referenz Pins þÿÜberprüfen

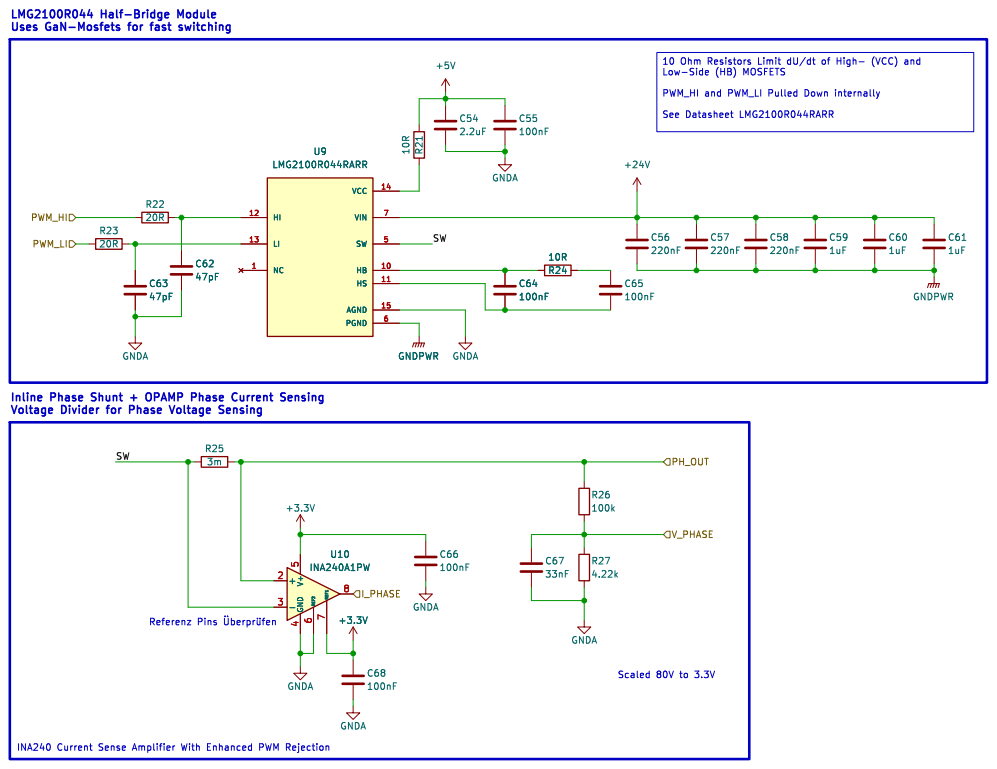
[picture p133: page 7]

Scaled 80V to 3.3V Referenz Pins þÿÜberprüfen

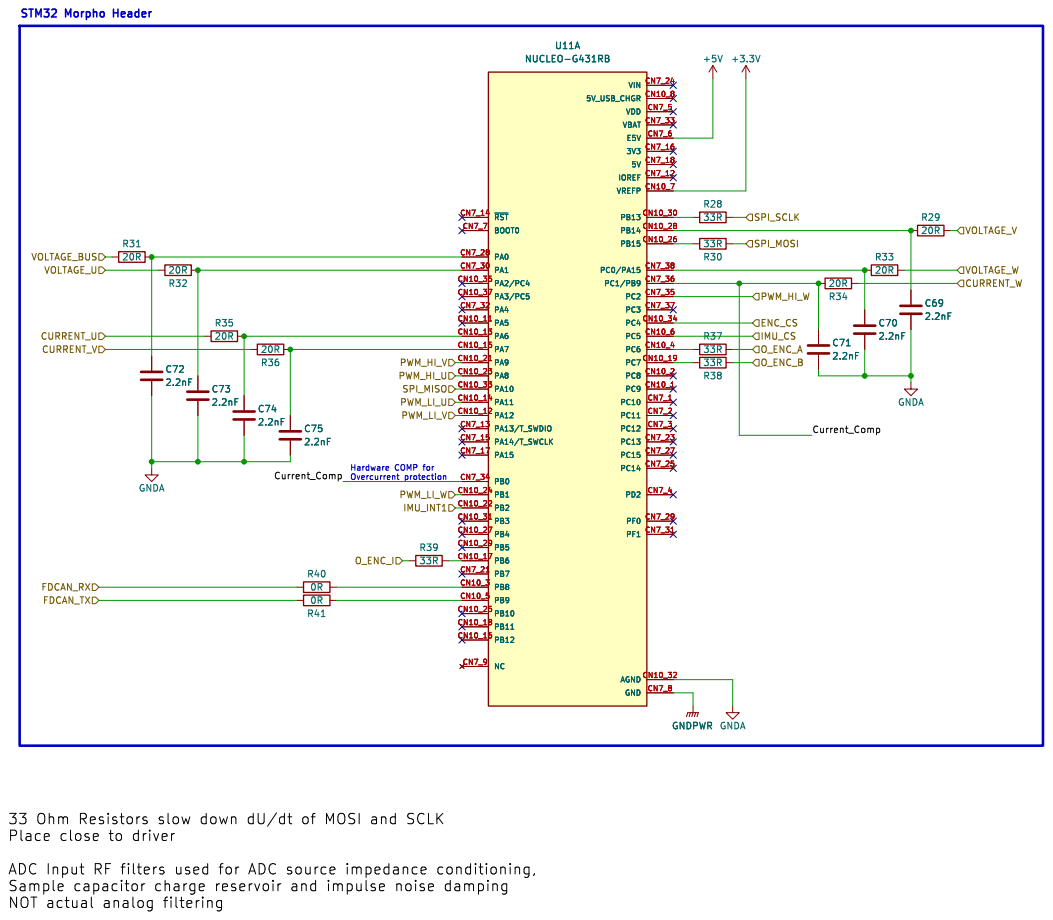
[picture p134: page 8]

Place close to driver

NOT actual analog filtering

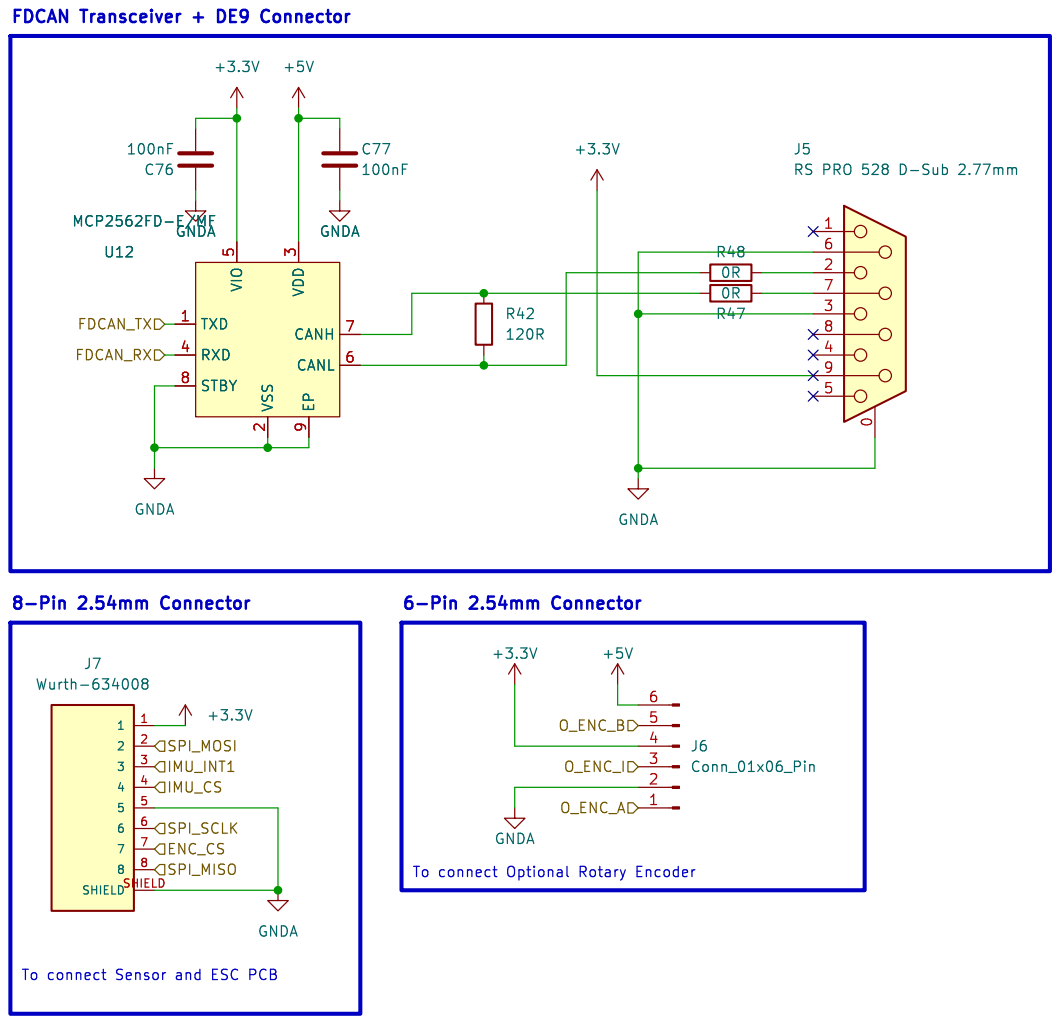
[picture p135: page 9]

5 CANL 6 CANH 7 STBY 8 EP
