Azmi0205/Bachelorarbeit/02PCB_Design/BetaLayout_CheckUrPCB.pdf

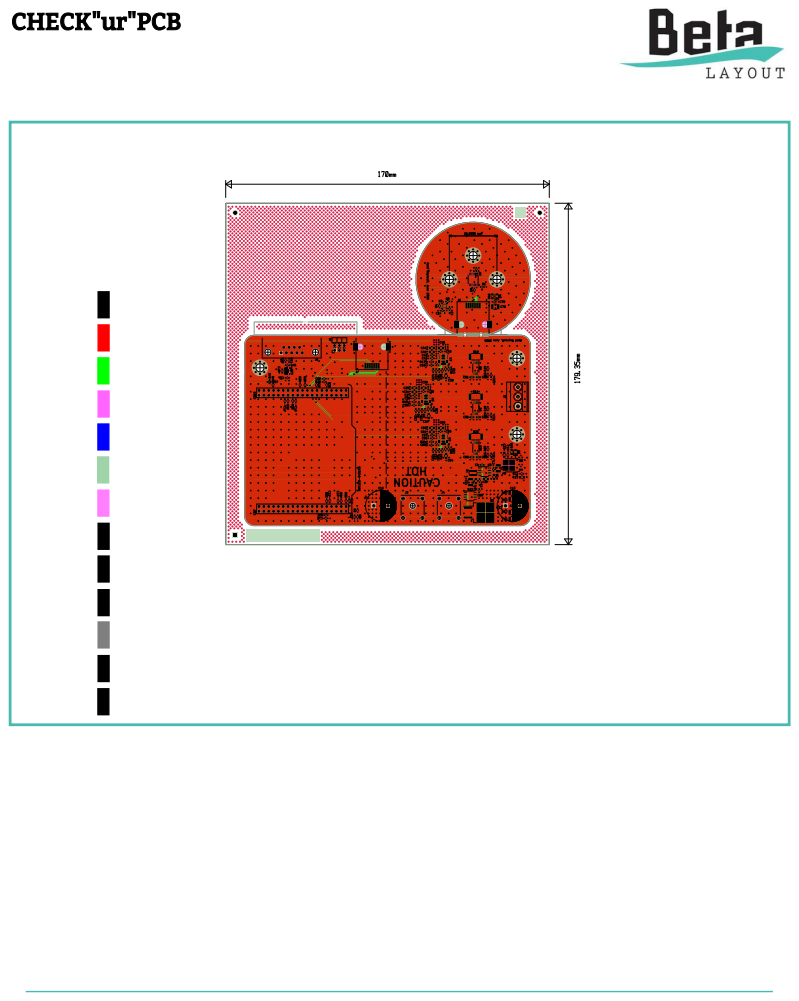
[picture p136: page 1]

CHECK"ur"PCB Die interaktive Vorschau fÃ¼r Ihre Fertigungsdaten
