Azmi0205/Bachelorarbeit/03Simulationen/LowToHighRampSim_1x1.pdf

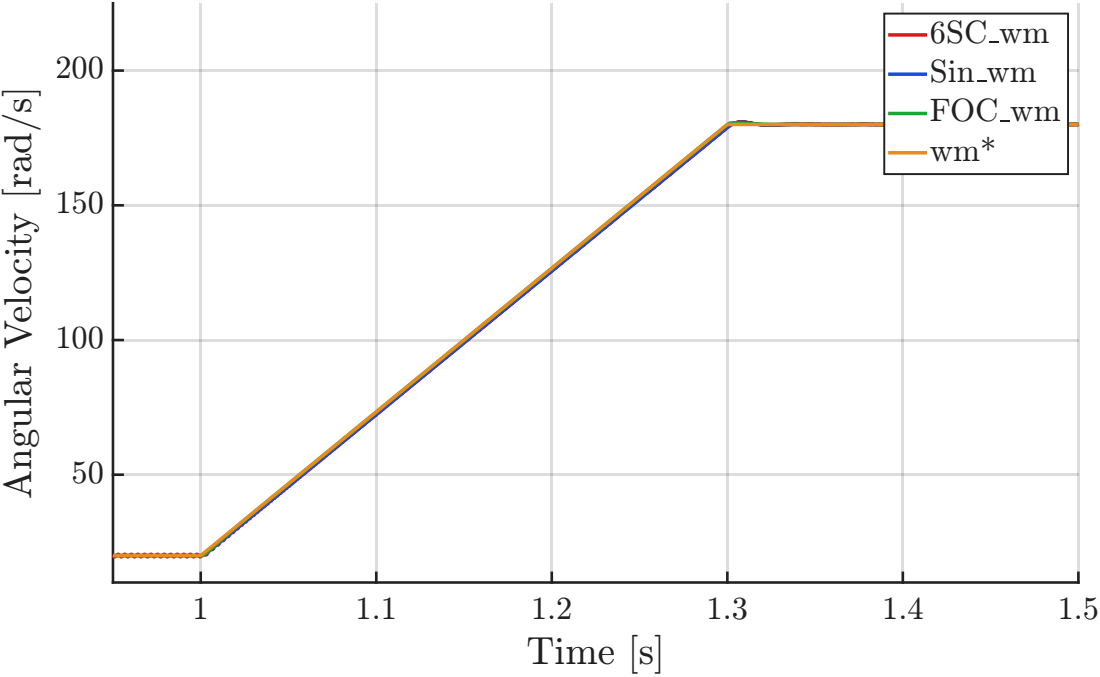
[picture p137: page 1]

Angular Velocity [rad/s]
