Azmi0205/Bachelorarbeit/03Simulationen/CL2_Speed_1x1.pdf

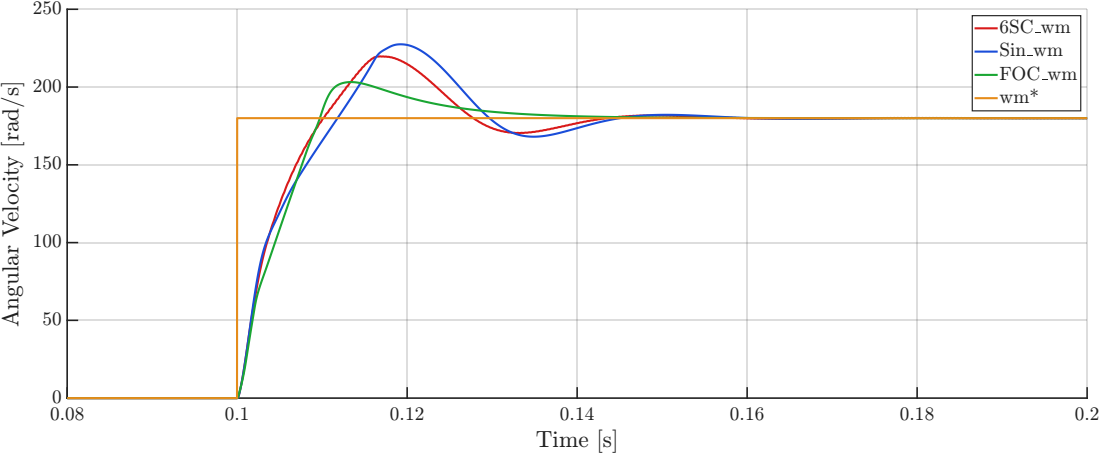
[picture p138: page 1]

Angular Velocity [rad/s]
