Azmi0205/Bachelorarbeit/03Simulationen/CL2_VelocityCurrent_FOCLimit_1x2.pdf

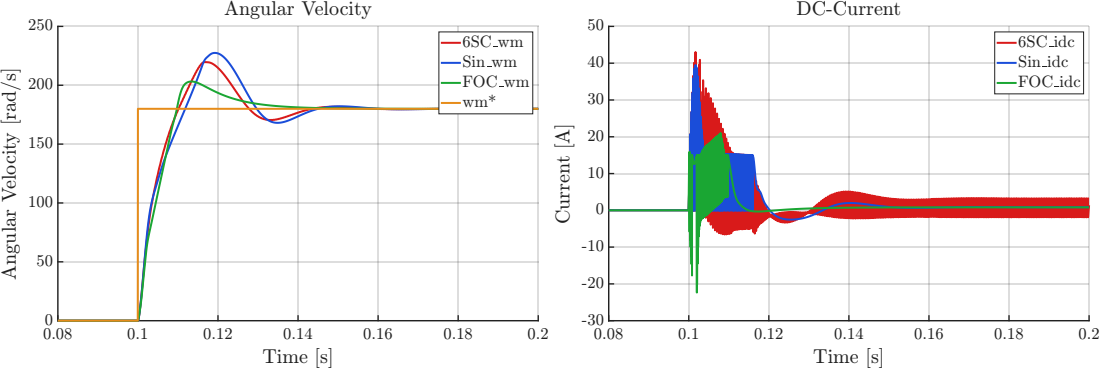
[picture p139: page 1]
Current [A]

Angular Velocity [rad/s]
