Azmi0205/Bachelorarbeit/03Simulationen/OL4_FOC_idiq_1x1.pdf

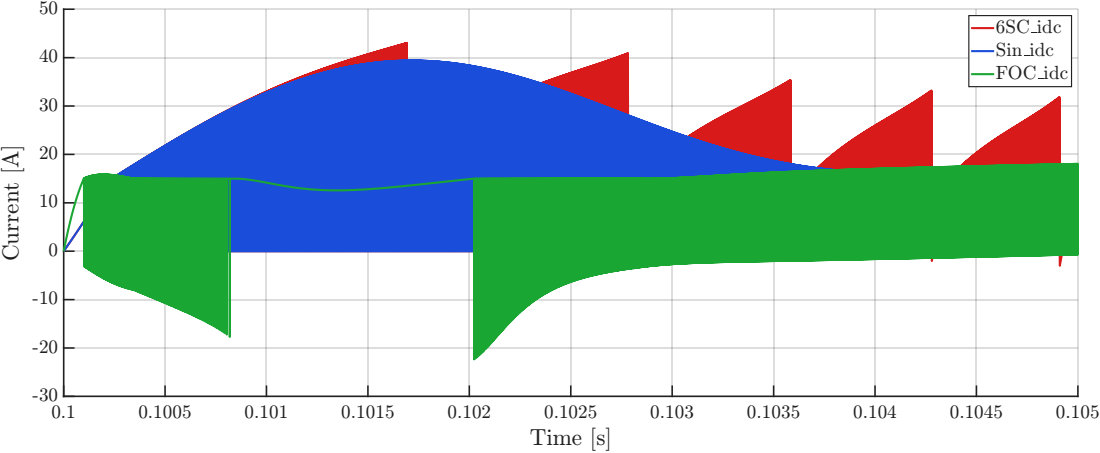
[picture p140: page 1]
Current [A]
