Azmi0205/Bachelorarbeit/03Simulationen/CL1_SpeedPower_1x2.pdf

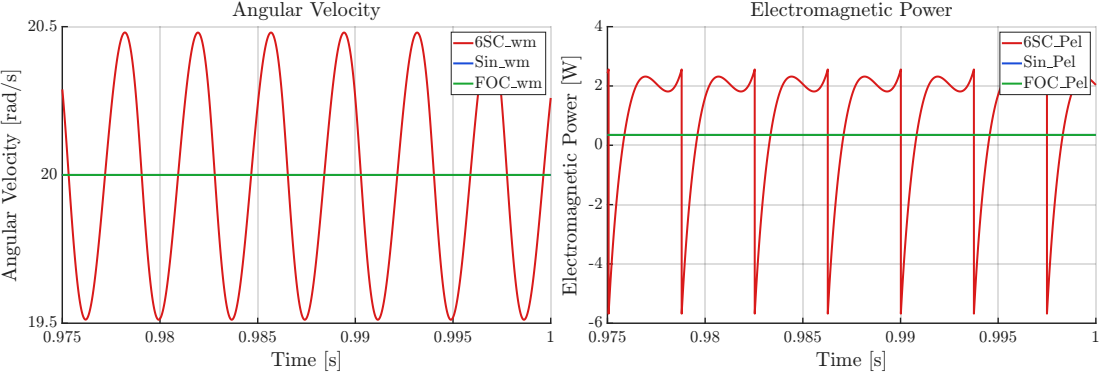
[picture p141: page 1]
Electromagnetic Power [W]

Angular Velocity [rad/s]
