Azmi0205/Bachelorarbeit/03Simulationen/CL1_VelocityCurrent_1x2.pdf

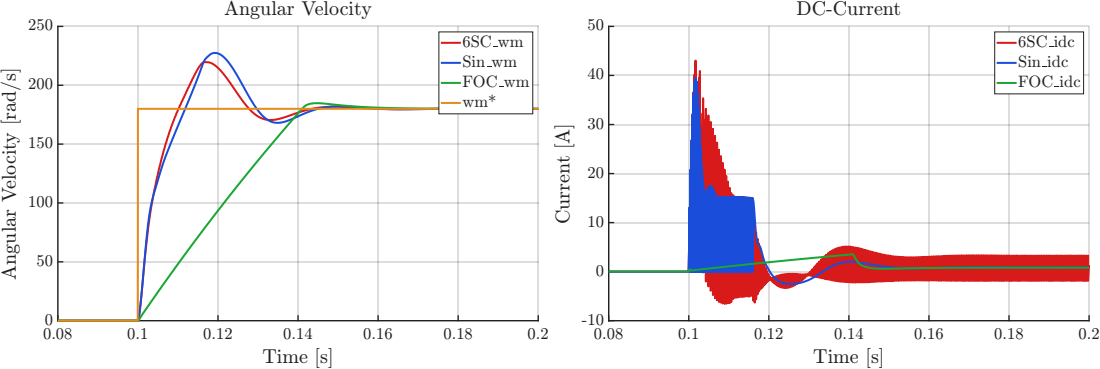
[picture p143: page 1]
Current [A]

Angular Velocity [rad/s]
