Azmi0205/Bachelorarbeit/03Simulationen/CL2_SpeedPower_1x2.pdf

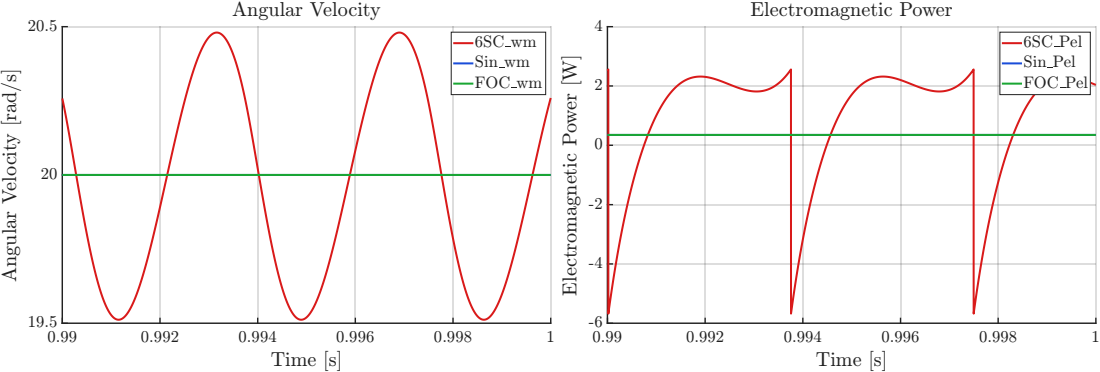
[picture p144: page 1]
Electromagnetic Power [W]

Angular Velocity [rad/s]
