Azmi0205/Bachelorarbeit/03Simulationen/OL1_Velocity_1x2.pdf

0.50 0.51 1.52 2.53

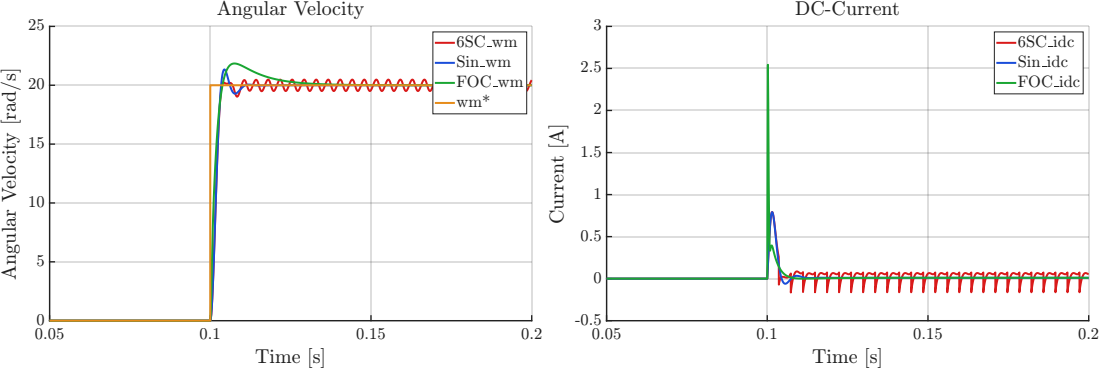
[picture p145: page 1]
Current [A]

Angular Velocity [rad/s]
