Azmi0205/Bachelorarbeit/03Simulationen/OL2_Velocity_NoFOCLimit_1x2.pdf

0.50 0.51 1.52 2.53

Current [A]

Angular Velocity [rad/s]
