Azmi0205/Bachelorarbeit/09Bilder/SimulinkModels/01_6SC_CommutationLogic.pdf

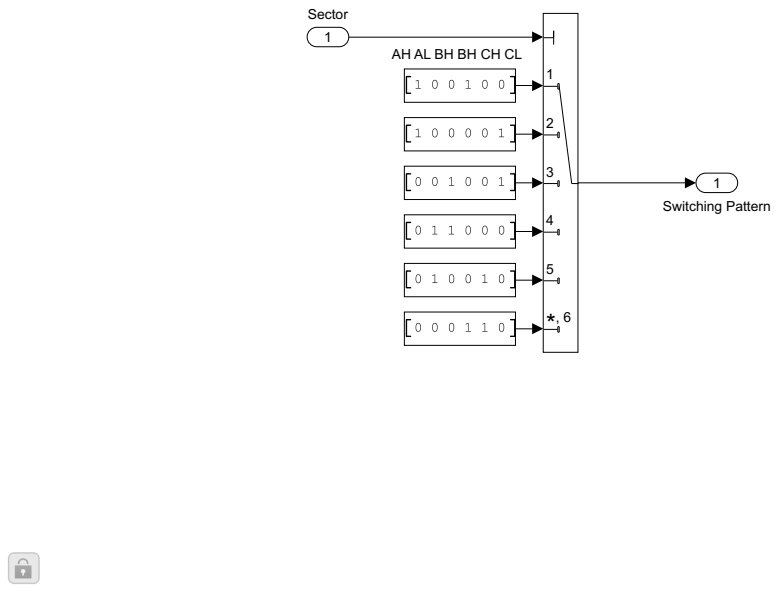
[picture p146: page 1]
Switching Pattern; Sector
