Azmi0205/Bachelorarbeit/09Bilder/SimulinkModels/02_6SC_TrapezoidalGen.pdf

x
+++

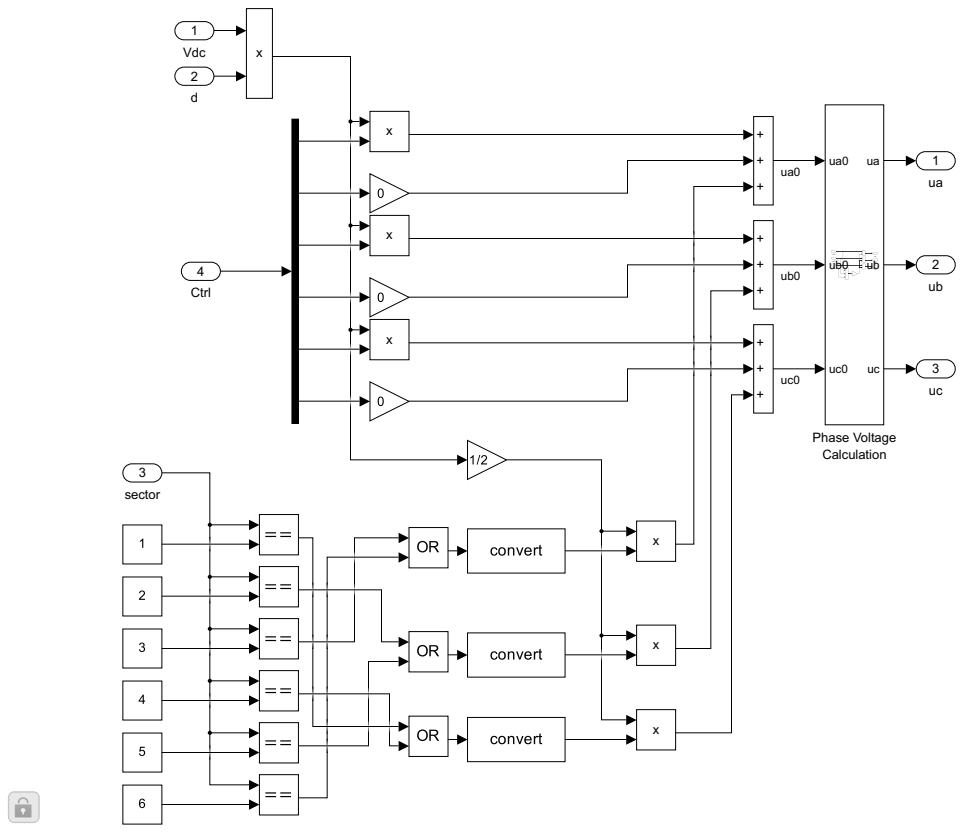
[picture p147: page 1]
uaubuc Phase Volta; alc; ula; tio
