Azmi0205/Bachelorarbeit/09Bilder/SimulinkModels/03_6SC_PhaseVoltageCal.pdf

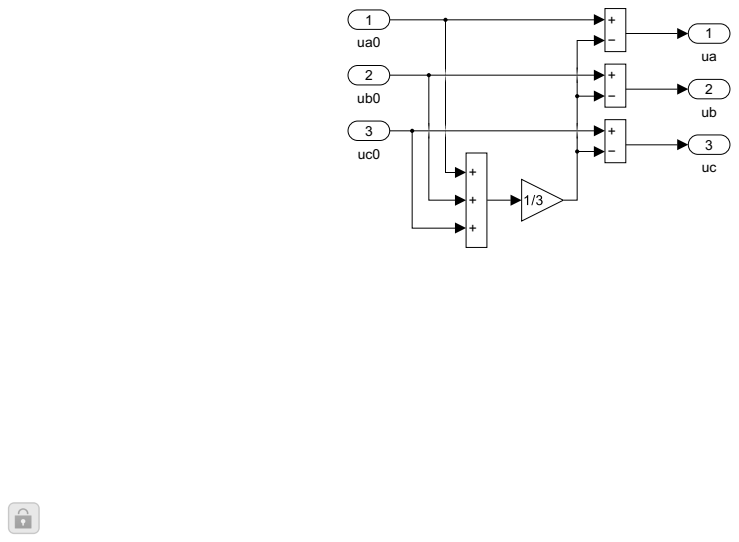
[picture p148: page 1]
