Azmi0205/Bachelorarbeit/09Bilder/SimulinkModels/04_6SC_Sensor.pdf

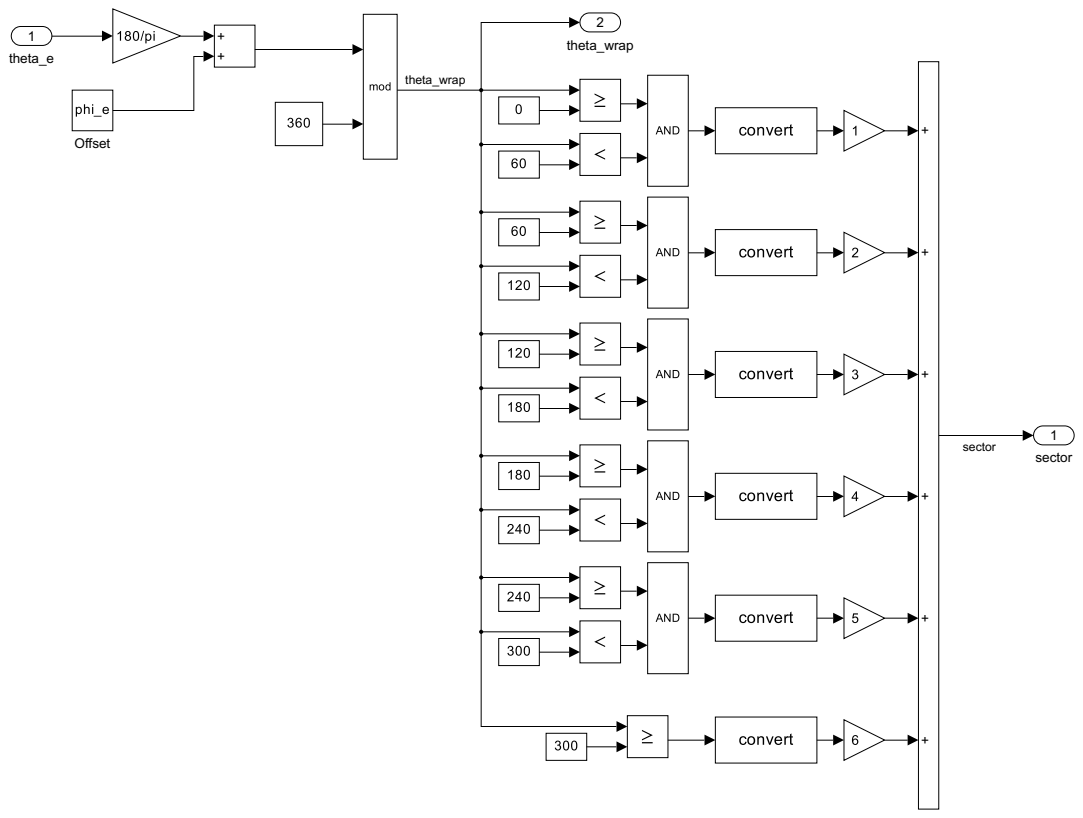
[picture p149: page 1]
1 sector; 2 theta_wrap; Offset; 1 theta_e; theta_wrap; sector
