Azmi0205/Bachelorarbeit/09Bilder/SimulinkModels/05_VectorMagnitudeCalculator.pdf

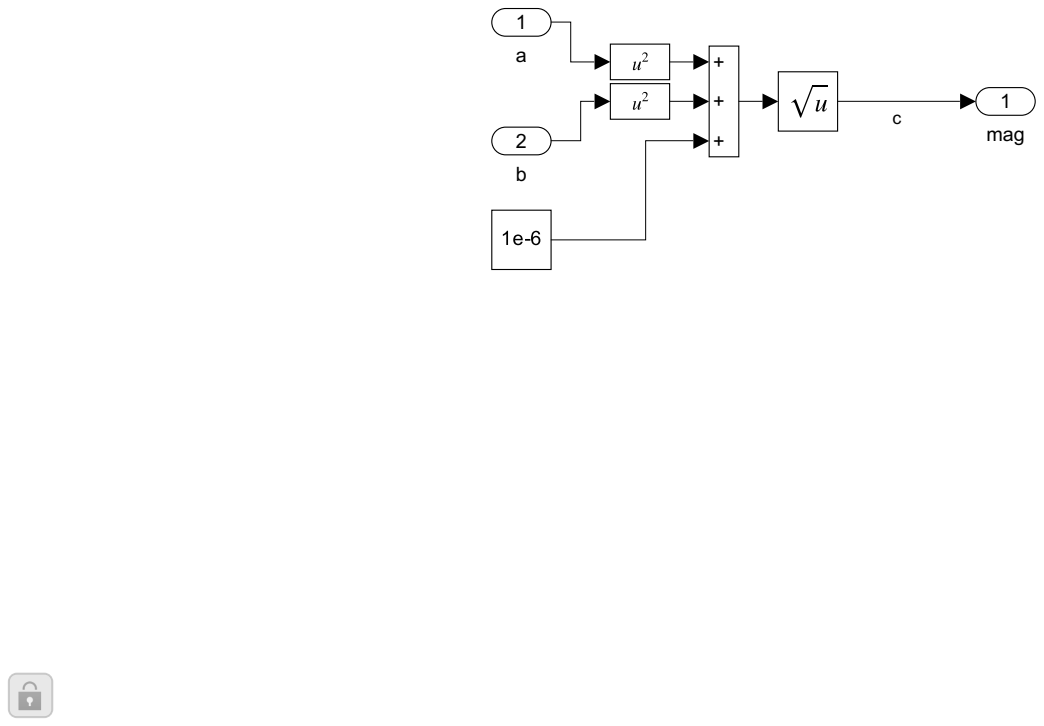
[picture p150: page 1]
