Azmi0205/Bachelorarbeit/09Bilder/SimulinkModels/06_Sin_VoltageReferenceGenerator.pdf

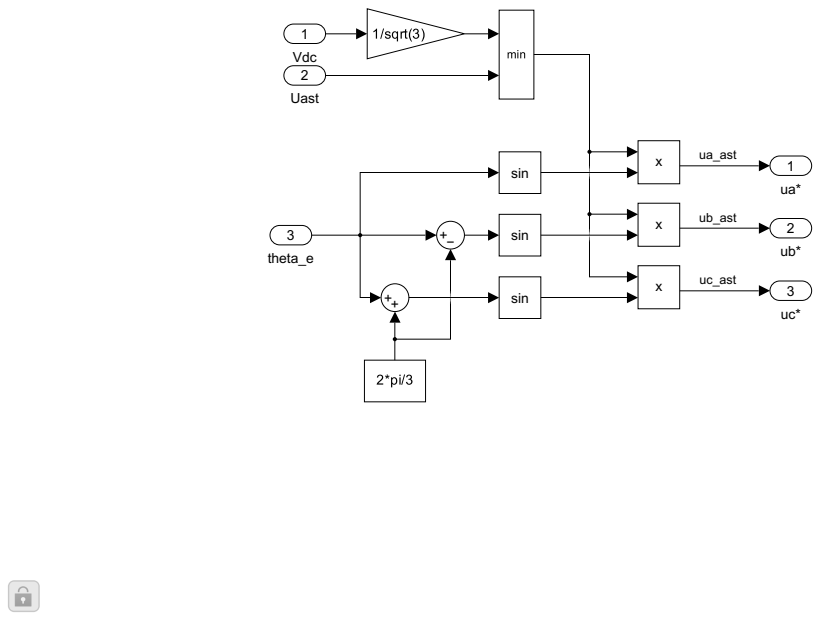
[picture p151: page 1]
sinsin; sin
