Azmi0205/Bachelorarbeit/09Bilder/SimulinkModels/07_CommonModeInjection.pdf

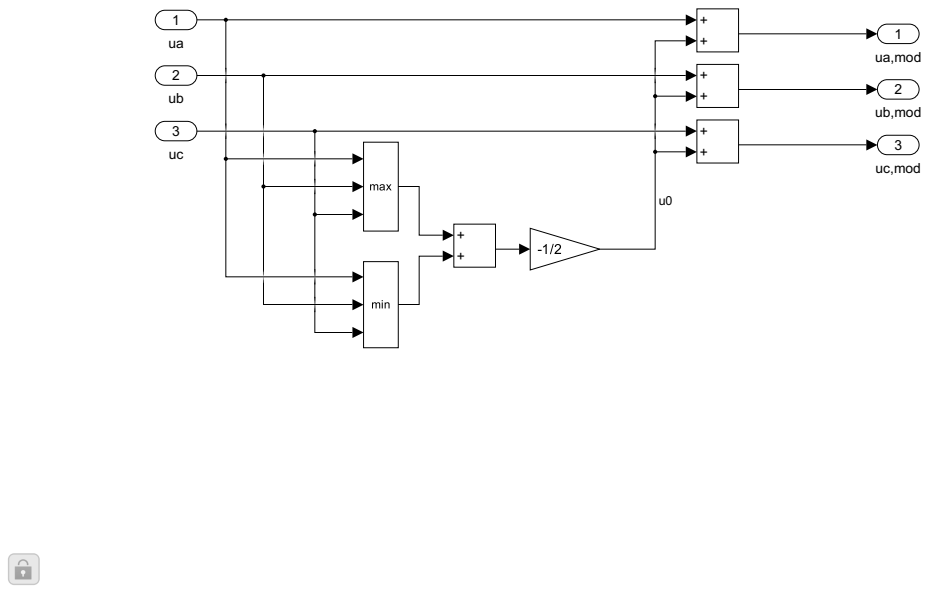
[picture p152: page 1]
