Azmi0205/Bachelorarbeit/09Bilder/SimulinkModels/Angle Wrapper.pdf

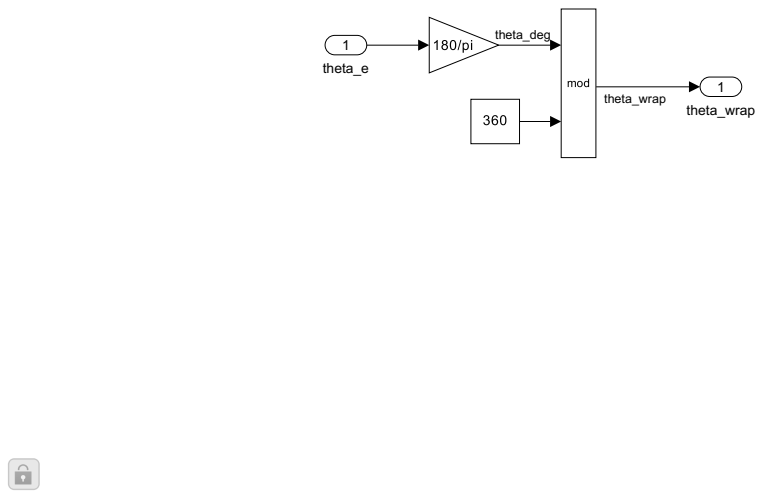
[picture p153: page 1]
