Azmi0205/Bachelorarbeit/09Bilder/SimulinkModels/Clarke Transform.pdf

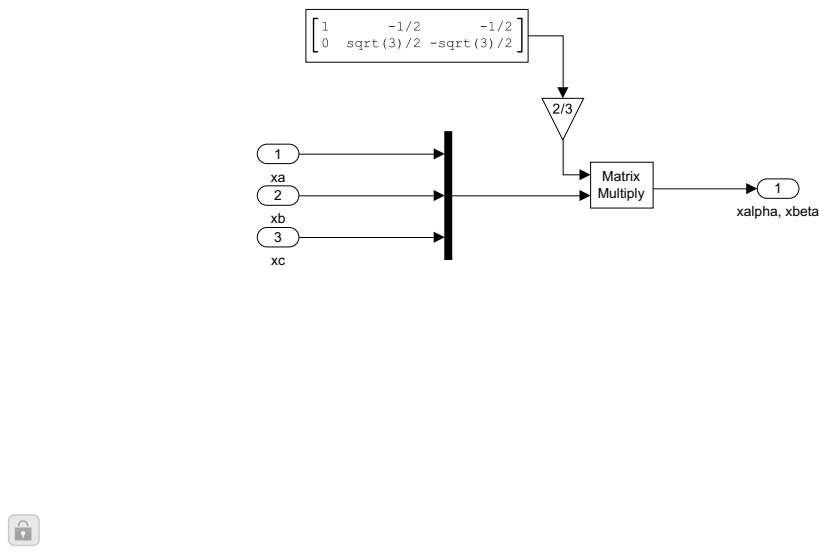
[picture p154: page 1]
alp; rix; ultiply
