Azmi0205/Bachelorarbeit/09Bilder/SimulinkModels/Decoupling Network.pdf

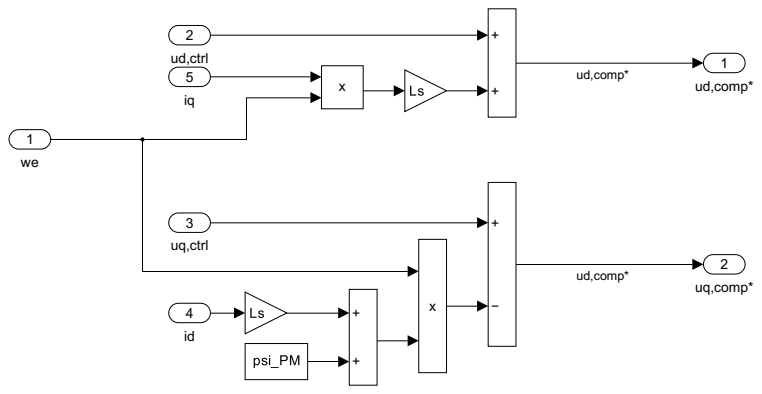
[picture p155: page 1]
