Azmi0205/Bachelorarbeit/09Bilder/SimulinkModels/Electrical Dynamics.pdf

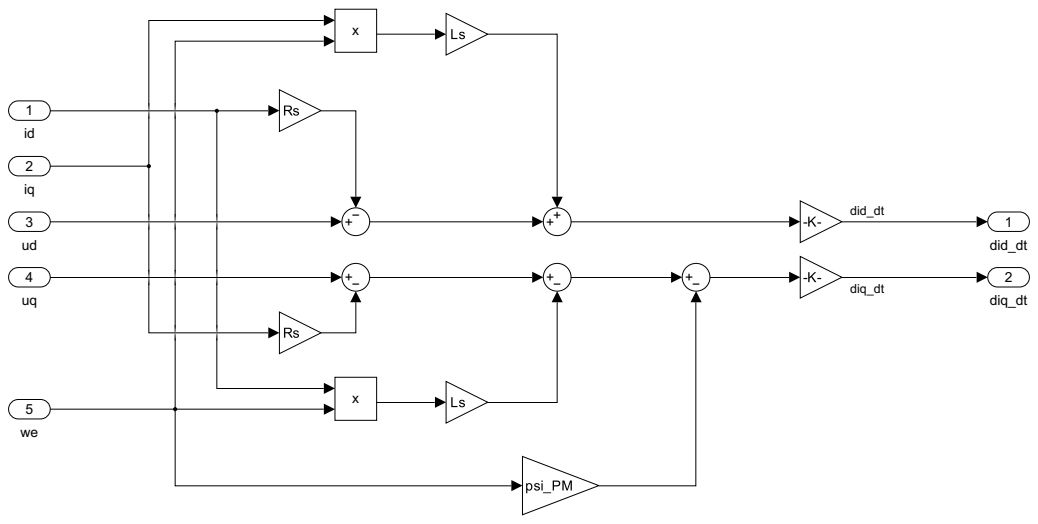
[picture p156: page 1]
diq; did
