Azmi0205/Bachelorarbeit/09Bilder/SimulinkModels/Inverse Clarke.pdf

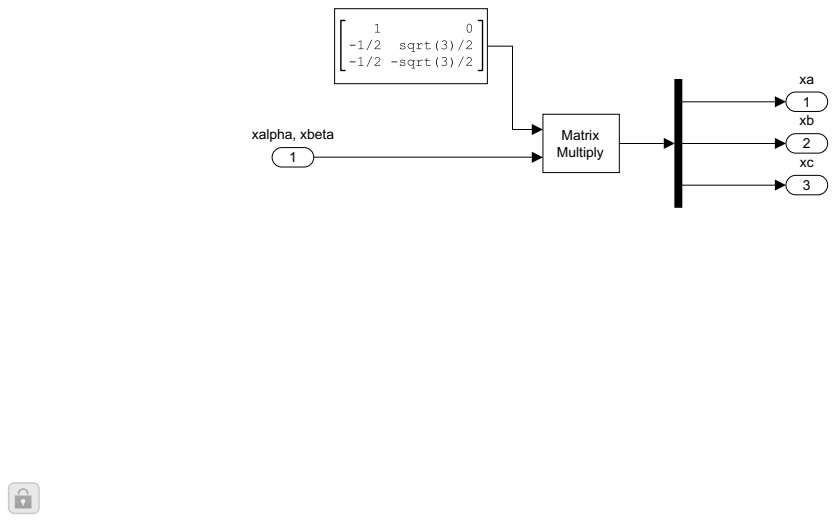
[picture p157: page 1]
alp; rix; ultiply
