Azmi0205/Bachelorarbeit/09Bilder/SimulinkModels/Inverse Park.pdf

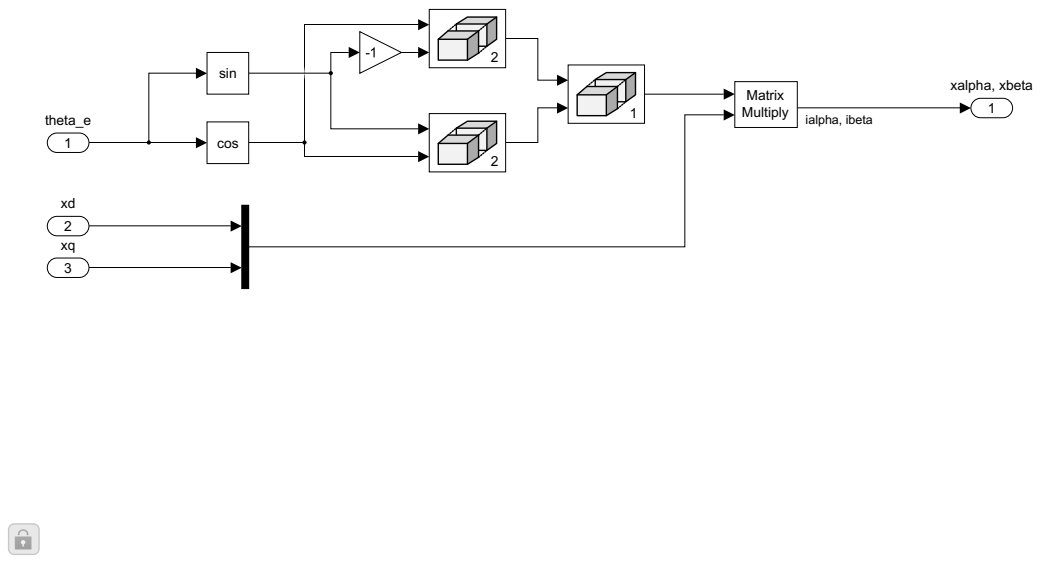
[picture p158: page 1]
rix; ultiply; sin; alp; ialp
