Azmi0205/Bachelorarbeit/09Bilder/SimulinkModels/Park Transform.pdf

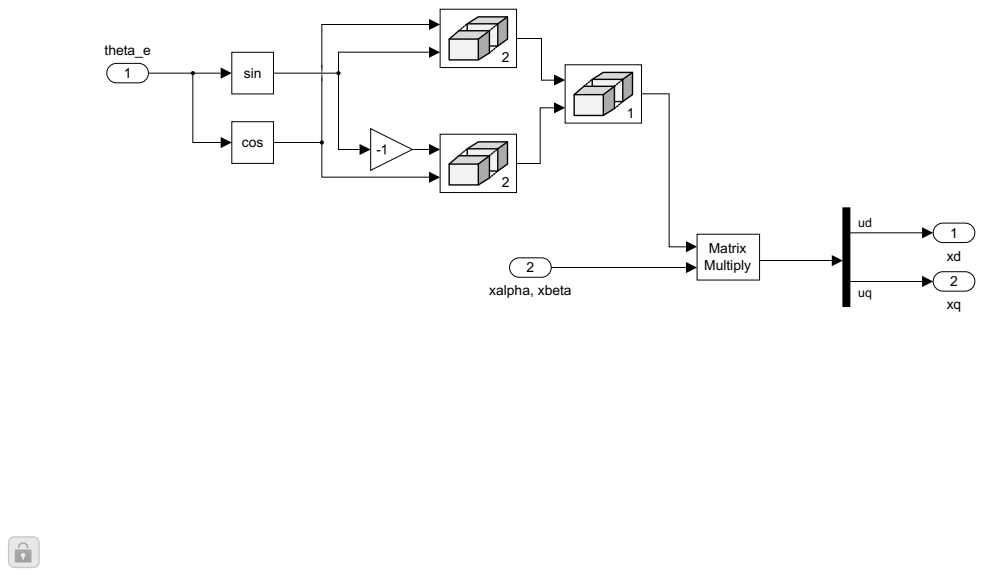
[picture p159: page 1]
sin; alp; rix; ultiply
