Azmi0205/Bachelorarbeit/09Bilder/SimulinkModels/PMSM.pdf

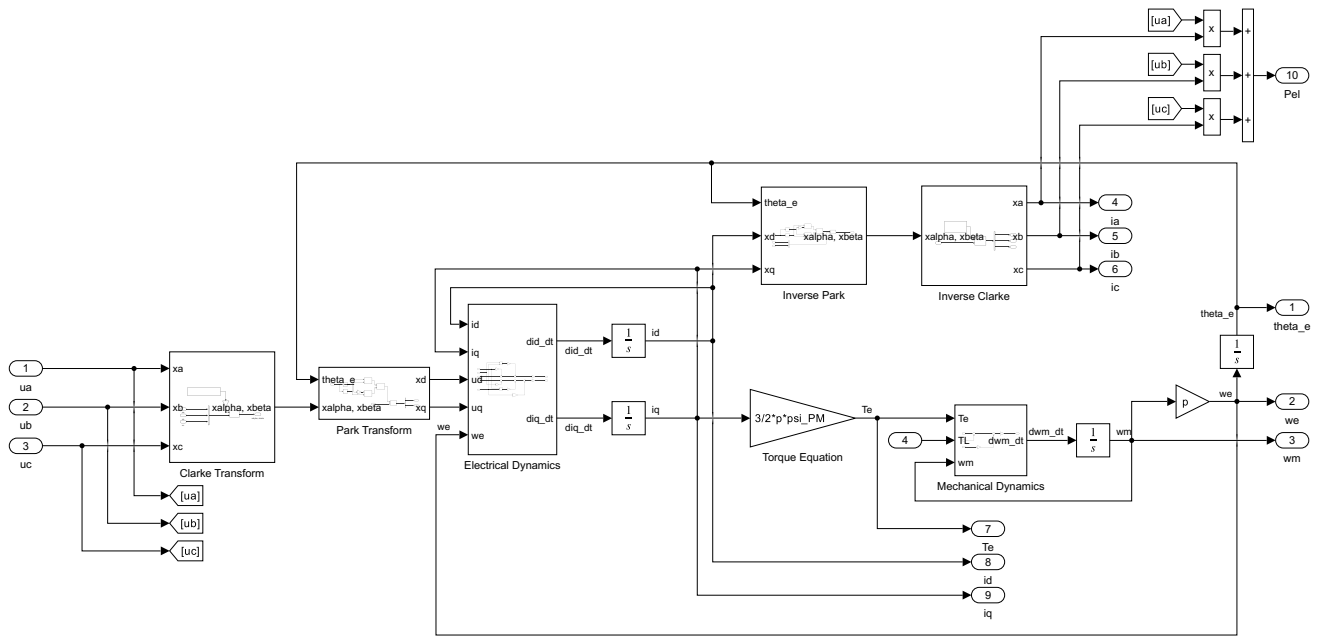
[picture p160: page 1]
tio; alp; c Inverse Clarke; x idiquduqwe; did_dt diq_dt; Ele; ric; mic; s xbxaxc; xalpha, xbeta xaxbxc; xalpha, xbeta Clarke Transform; a Inverse Park; TeTLwm; nic; did; diq
