Azmi0205/Bachelorarbeit/09Bilder/SimulinkModels/Vector Output Limitter.pdf

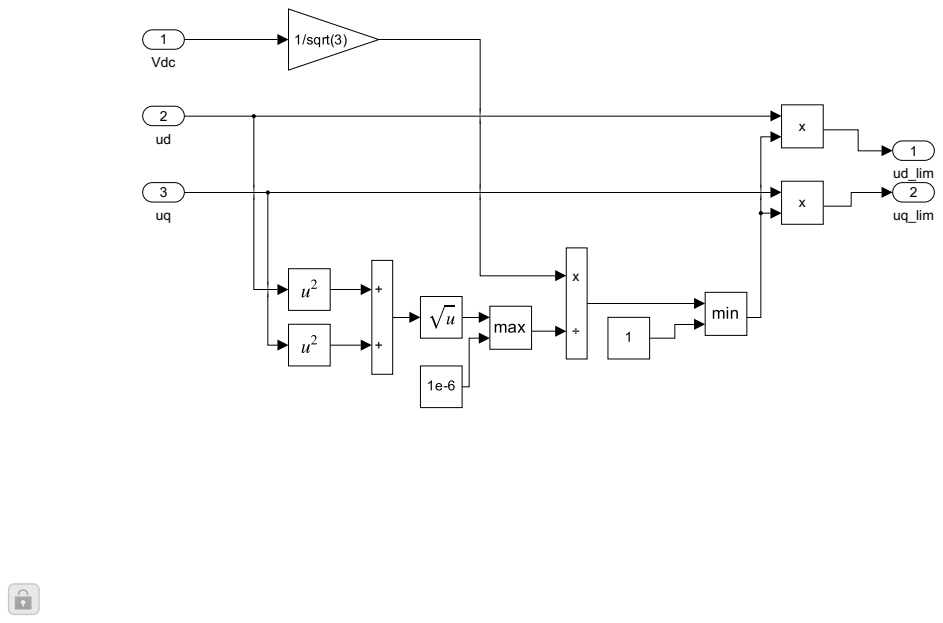
[picture p161: page 1]
_lim; 2ud1Vdc
