Azmi0205/Bachelorarbeit/02PCB_Design/01KiCad_Project/Testplatine.kicad_pcb

## KiCad design 02PCB_Design/01KiCad_Project/Testplatine.kicad_pcb (2026-11-10)

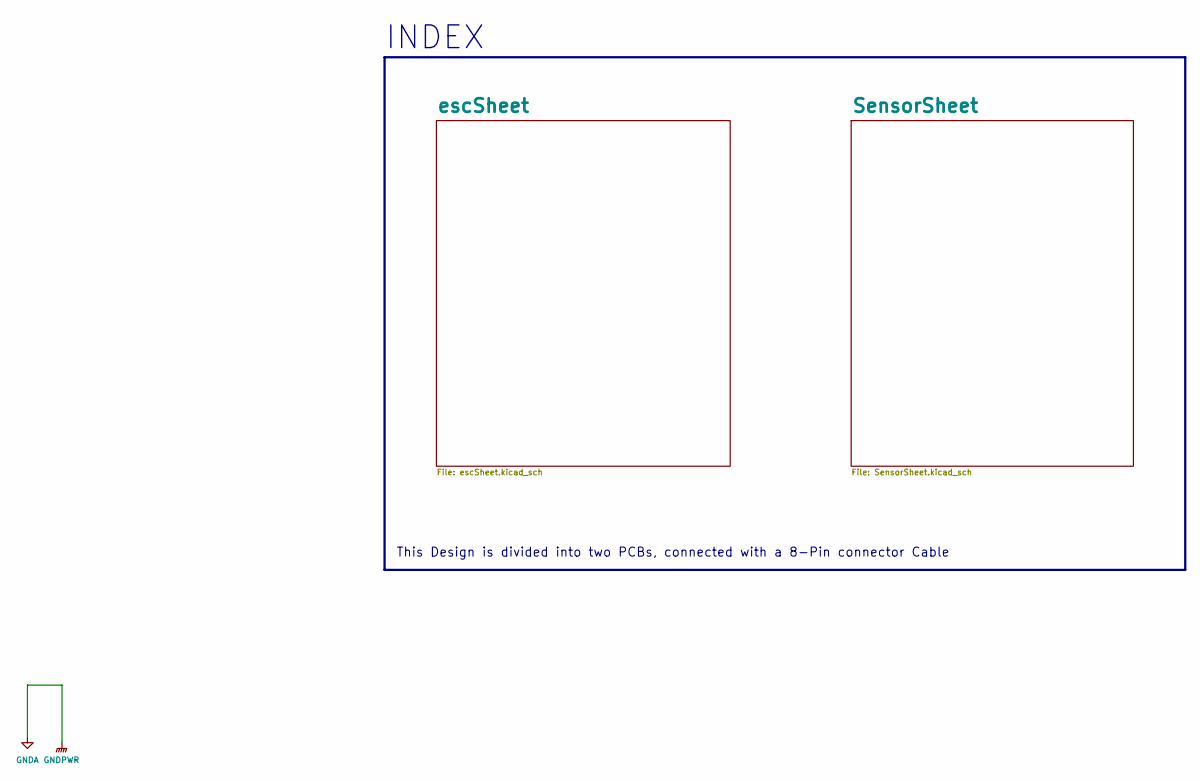
[picture p162: schematic Testplatine.kicad_sch, Motor Control Test Extension Board]

Notes on the sheet:
This Design is divided into two PCBs, connected with a 8-Pin connector Cable
INDEX

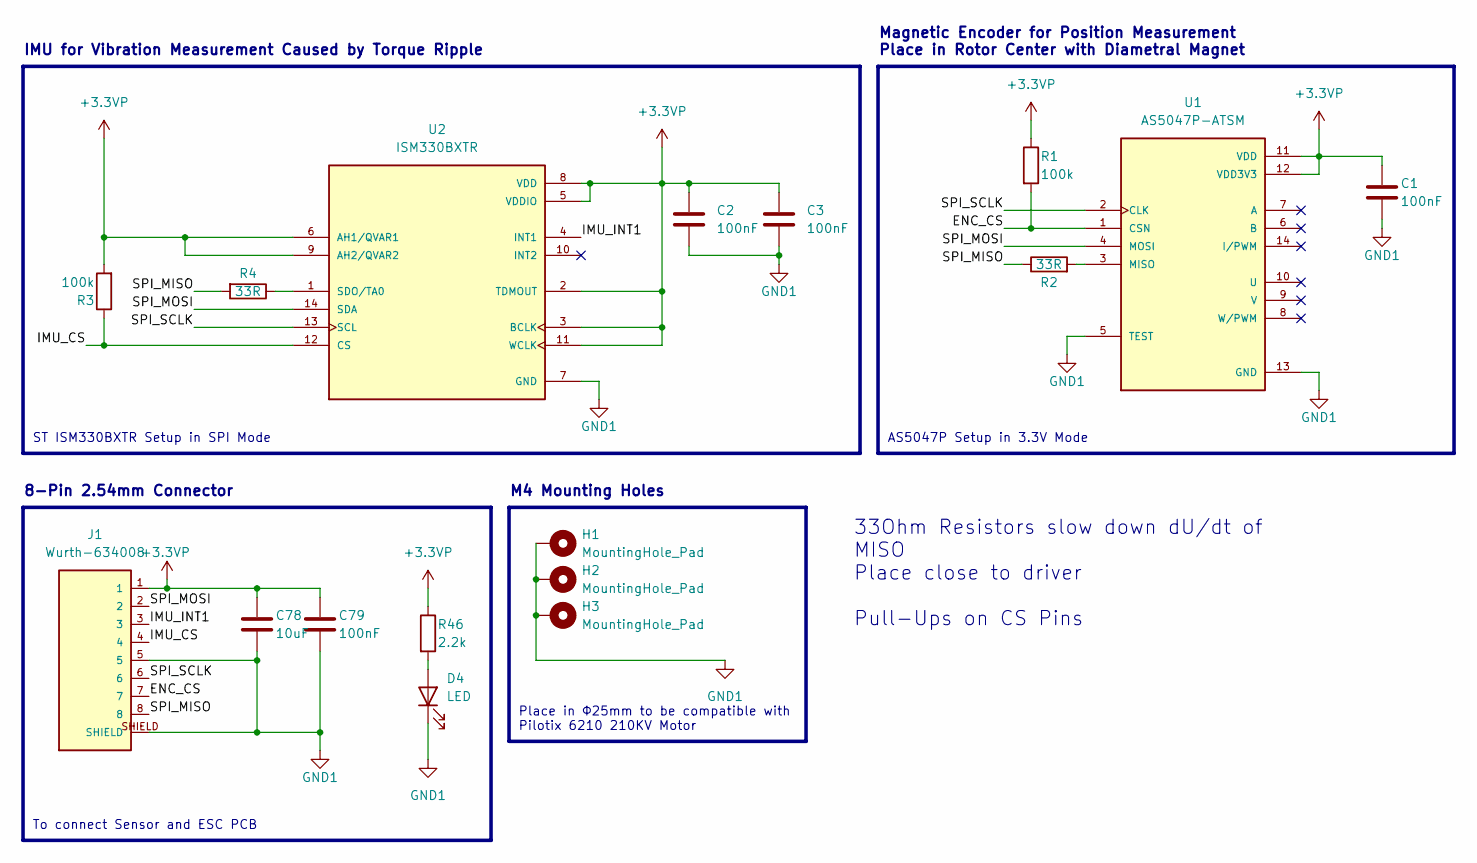
[picture p163: schematic SensorSheet.kicad_sch, Motor Control Test Extension Board]

Parts:
C1, C2, C3, C79: 100nF; C_0603_1608Metric_Pad1.08x0.95mm_HandSolder
C78: 10uF; C_1210_3225Metric_Pad1.33x2.70mm_HandSolder
D4: LED; LED_0805_2012Metric_Pad1.15x1.40mm_HandSolder
H1, H2, H3: MountingHole_Pad; MountingHole_4.3mm_M4_Pad_Via
J1: Wurth-634008; Wurth_634008_RJ45; PARTREV G
R1, R3: 100k; R_0603_1608Metric_Pad0.98x0.95mm_HandSolder
R2, R4: 33R; R_0603_1608Metric_Pad0.98x0.95mm_HandSolder
R46: 2.2k; R_0805_2012Metric_Pad1.20x1.40mm_HandSolder
U1: AS5047P-ATSM; TSSOP-14_4.4x5mm_P0.65mm; PARTREV 1-01
U2: ISM330BXTR; LGA-14_3x2.5mm_P0.5mm_LayoutBorder3x4y; PARTREV 2

Connections:
+3.3VP: C1.1, C2.1, C3.1, C78.1, C79.1, J1.1, R1.1, R3.2, R46.1, U1.11 (VDD), U1.12 (VDD3V3), U2.2 (TDMOUT), U2.3 (BCLK), U2.5 (VDDIO), U2.6 (AH1/QVAR1), U2.8 (VDD), U2.9 (AH2/QVAR2), U2.11 (WCLK)
/SensorSheet/ENC_CS: J1.7, R1.2, U1.1 (CSN)
/SensorSheet/IMU_CS: J1.4, R3.1, U2.12 (CS)
/SensorSheet/IMU_INT1: J1.3, U2.4 (INT1)
/SensorSheet/SPI_MISO: J1.8, R2.1, R4.2
/SensorSheet/SPI_MOSI: J1.2, U1.4 (MOSI), U2.14 (SDA)
/SensorSheet/SPI_SCLK: J1.6, U1.2 (CLK), U2.13 (SCL)
GND1: C1.2, C2.2, C3.2, C78.2, C79.2, D4.1 (K), H1.1, H2.1, H3.1, J1.5, J1.SHIELD, U1.5 (TEST), U1.13 (GND), U2.7 (GND)
unnamed: D4.2 (A), R46.2
unnamed: R2.2, U1.3 (MISO)
unnamed: R4.1, U2.1 (SDO/TA0)

Notes on the sheet:
33Ohm Resistors slow down dU/dt of MISO Place close to driver Pull-Ups on CS Pins
AS5047P Setup in 3.3V Mode
Place in Φ25mm to be compatible with Pilotix 6210 210KV Motor
8-Pin 2.54mm Connector
IMU for Vibration Measurement Caused by Torque Ripple
Magnetic Encoder for Position Measurement Place in Rotor Center with Diametral Magnet
To connect Sensor and ESC PCB
ST ISM330BXTR Setup in SPI Mode
M4 Mounting Holes

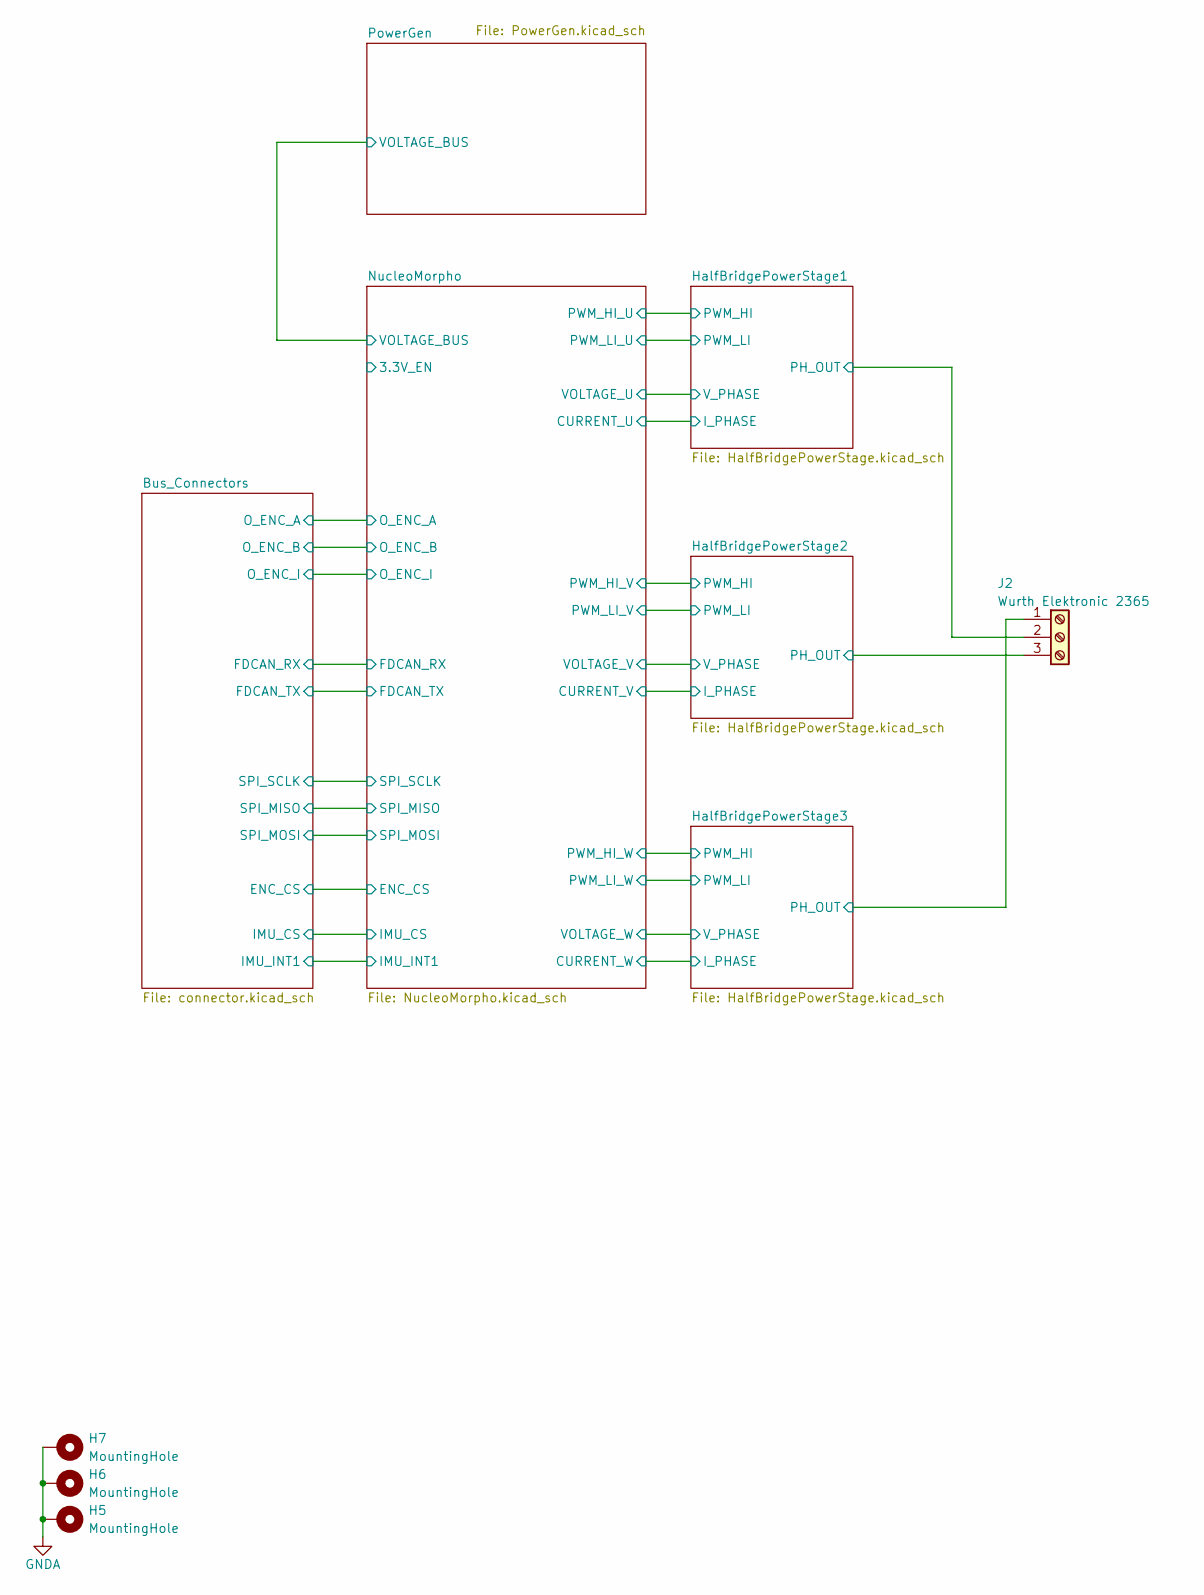
[picture p164: schematic escSheet.kicad_sch]

Parts:
H5, H6, H7: MountingHole; MountingHole_4.3mm_M4_Pad_Via
J2: Wurth Elektronic 2365; Wurth Elektronik 2365 Printklemme

Connections:
/escSheet/HalfBridgePowerStage1/PH_OUT: J2.2; also elsewhere on the board
/escSheet/HalfBridgePowerStage2/PH_OUT: J2.3; also elsewhere on the board
/escSheet/HalfBridgePowerStage3/PH_OUT: J2.1; also elsewhere on the board

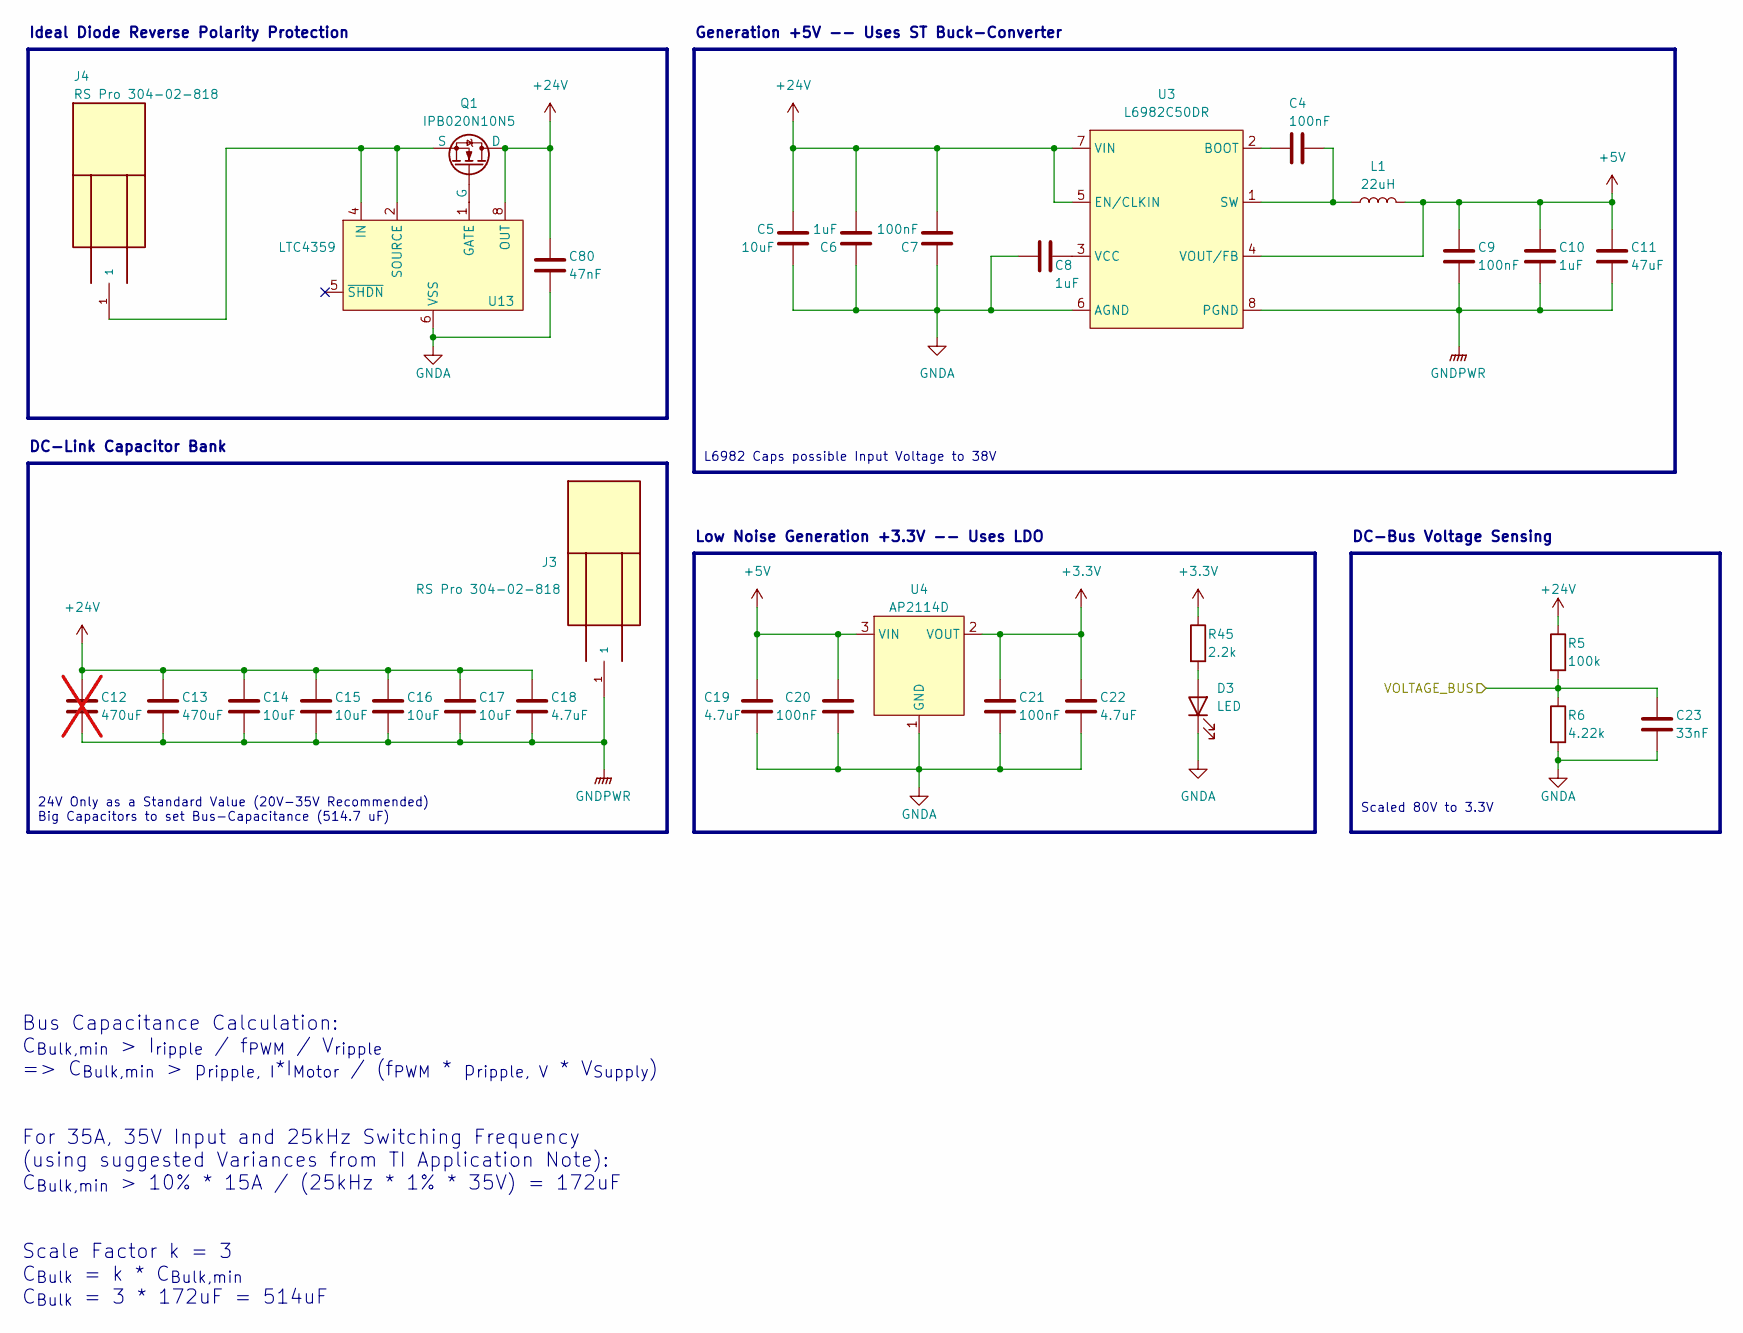
[picture p165: schematic PowerGen.kicad_sch, Motor Control Test Extension Board]

Parts:
C4, C7, C9, C20, C21: 100nF; C_0603_1608Metric_Pad1.08x0.95mm_HandSolder
C5, C14, C15, C16, C17: 10uF; C_1210_3225Metric_Pad1.33x2.70mm_HandSolder
C6, C8, C10: 1uF; C_0805_2012Metric_Pad1.18x1.45mm_HandSolder
C11: 47uF; C_1210_3225Metric_Pad1.33x2.70mm_HandSolder
C12: 470uF; CP_Radial_D16.0mm_P7.50mm; not fitted
C13: 470uF; CP_Radial_D16.0mm_P7.50mm
C18, C19, C22: 4.7uF; C_0805_2012Metric_Pad1.18x1.45mm_HandSolder
C23: 33nF; C_0603_1608Metric_Pad1.08x0.95mm_HandSolder
C80: 47nF; C_0603_1608Metric_Pad1.08x0.95mm_HandSolder
D3: LED; LED_0805_2012Metric_Pad1.15x1.40mm_HandSolder
J3, J4: RS Pro 304-02-818; FCR7350
L1: 22uH; L_Wuerth_MAPI-4020
Q1: IPB020N10N5; TO-263-2
R5: 100k; R_0603_1608Metric_Pad0.98x0.95mm_HandSolder
R6: 4.22k; R_0603_1608Metric_Pad0.98x0.95mm_HandSolder
R45: 2.2k; R_0805_2012Metric_Pad1.20x1.40mm_HandSolder
U3: L6982C50DR; SO-8_3.9x4.9mm_P1.27mm
U4: AP2114D; TO-252-2
U13: LTC4359; SO-8_3.9x4.9mm_P1.27mm

Connections:
+3.3V: C21.1, C22.1, R45.1, U4.2 (VOUT); also elsewhere on the board
+5V: C9.1, C10.1, C11.1, C19.1, C20.1, L1.2, U3.4 (VOUT/FB), U4.3 (VIN); also elsewhere on the board
+24V: C5.1, C6.2, C7.2, C12.1, C13.1, C14.1, C15.1, C16.1, C17.1, C18.1, C80.1, Q1.D, R5.1, U3.5 (EN/CLKIN), U3.7 (VIN), U13.8 (OUT); also elsewhere on the board
/escSheet/NucleoMorpho/VOLTAGE_BUS: C23.1, R5.2, R6.1; also elsewhere on the board
unnamed: D3.2 (A), R45.2
unnamed: C4.2, U3.2 (BOOT)
unnamed: C4.1, L1.1, U3.1 (SW)
unnamed: C8.1, U3.3 (VCC)
unnamed: Q1.G, U13.1 (GATE)
unnamed: J4.1, Q1.S, U13.2 (SOURCE), U13.4 (IN)

Notes on the sheet:
Bus Capacitance Calculation: C_{Bulk,min} > I_{ripple} / f_{PWM} / V_{ripple} => C_{Bulk,min} > p_{ripple, I}*I_{Motor} / (f_{PWM} * p_{ripple, V} * V_{Supply}) For 35A, 35V Input and 25kHz Switching Frequency (using suggested Variances from TI Application Note): C_{Bulk,min} > 10% * 15A / (25kHz *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
Scaled 80V to 3.3V
DC-Bus Voltage Sensing
Ideal Diode Reverse Polarity Protection
Low Noise Generation +3.3V -- Uses LDO
DC-Link Capacitor Bank
24V Only as a Standard Value (20V-35V Recommended) Big Capacitors to set Bus-Capacitance (514.7 uF)
L6982 Caps possible Input Voltage to 38V
Generation +5V -- Uses ST Buck-Converter

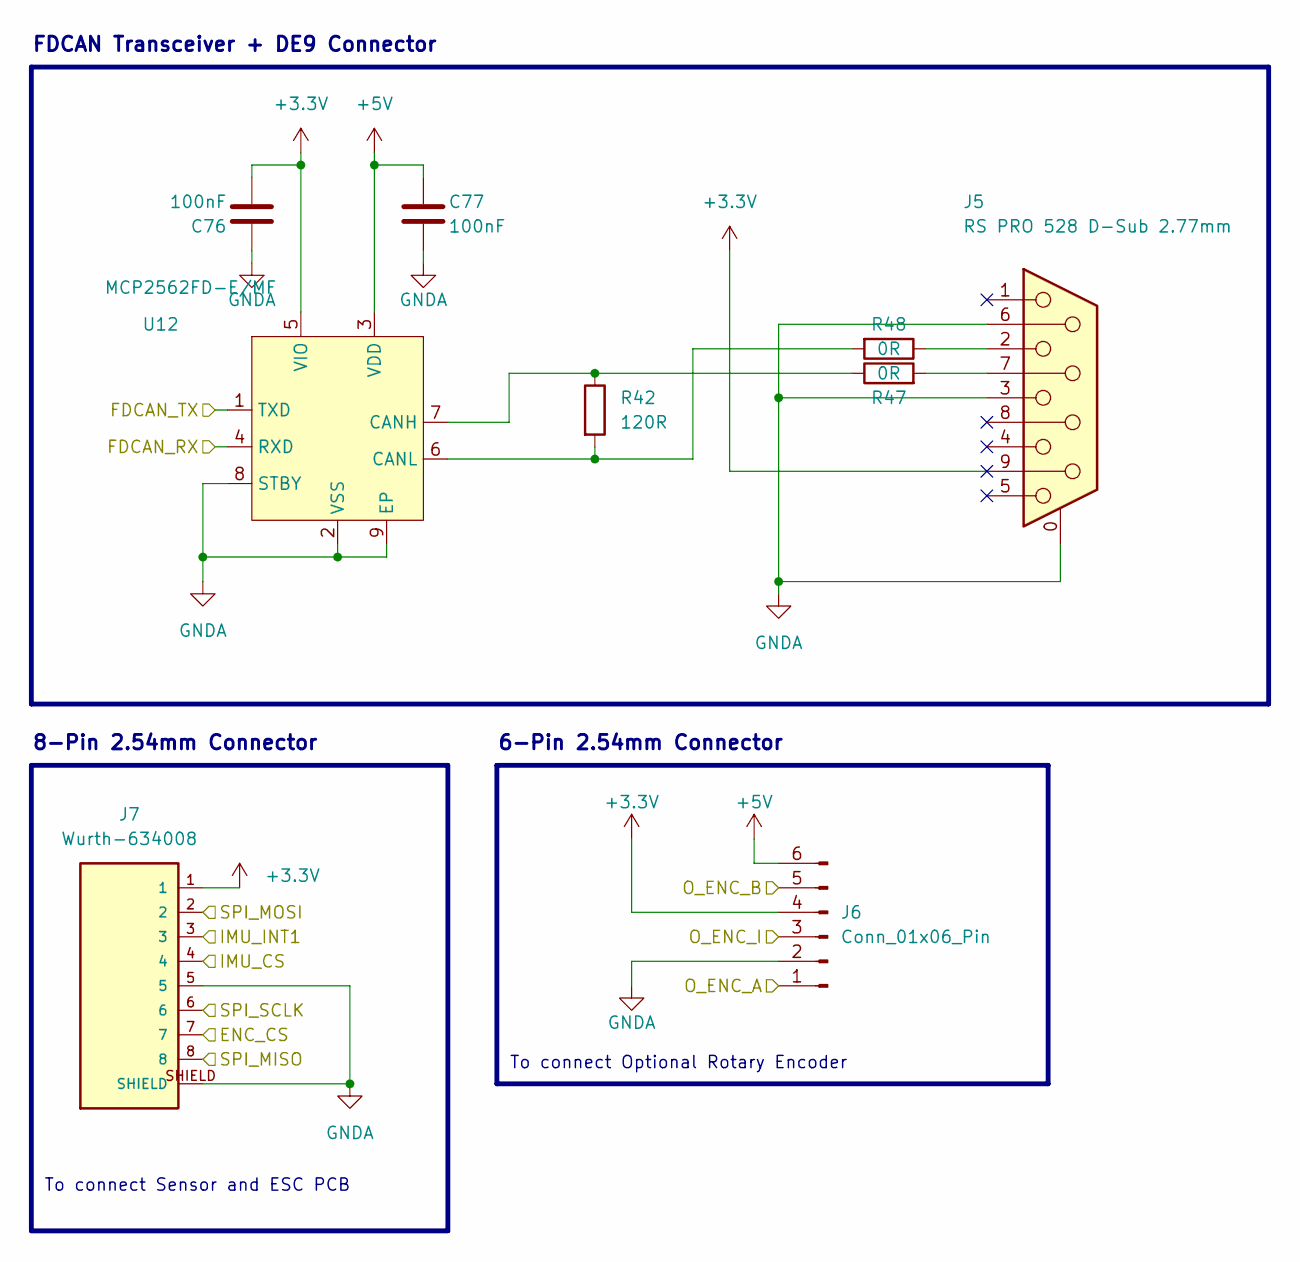
[picture p166: schematic connector.kicad_sch, Motor Control Test Extension Board]

Parts:
C76, C77: 100nF; C_0603_1608Metric_Pad1.08x0.95mm_HandSolder
J5: RS PRO 528 D-Sub 2.77mm; DSUB-9_Female_Horizontal_P2.77x2.84mm_EdgePinOffset4.94mm_H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
J6: Conn_01x06_Pin; PinHeader_2x03_P2.54mm_Horizontal
J7: Wurth-634008; Wurth_634008_RJ45; PARTREV G
R42: 120R; R_0603_1608Metric_Pad0.98x0.95mm_HandSolder
R47, R48: 0R; R_0603_1608Metric_Pad0.98x0.95mm_HandSolder
U12: MCP2562FD-E/MF; DFN-8-1EP_3x3mm_P0.65mm_EP1.55x2.4mm

Connections:
+3.3V: C76.2, J5.9, J6.4, J7.1, U12.5 (VIO); also elsewhere on the board
+5V: C77.1, J6.6, U12.3 (VDD); also elsewhere on the board
/escSheet/Bus_Connectors/ENC_CS: J7.7; also elsewhere on the board
/escSheet/Bus_Connectors/FDCAN_RX: U12.4 (RXD); also elsewhere on the board
/escSheet/Bus_Connectors/FDCAN_TX: U12.1 (TXD); also elsewhere on the board
/escSheet/Bus_Connectors/IMU_CS: J7.4; also elsewhere on the board
/escSheet/Bus_Connectors/IMU_INT1: J7.3; also elsewhere on the board
/escSheet/Bus_Connectors/O_ENC_A: J6.1; also elsewhere on the board
/escSheet/Bus_Connectors/O_ENC_B: J6.5; also elsewhere on the board
/escSheet/Bus_Connectors/O_ENC_I: J6.3; also elsewhere on the board
/escSheet/Bus_Connectors/SPI_MISO: J7.8; also elsewhere on the board
/escSheet/Bus_Connectors/SPI_MOSI: J7.2; also elsewhere on the board
/escSheet/Bus_Connectors/SPI_SCLK: J7.6; also elsewhere on the board
unnamed: J5.2, R48.1
unnamed: J5.7, R47.2
unnamed: R42.1, R47.1, U12.7 (CANH)
unnamed: R42.2, R48.2, U12.6 (CANL)

Notes on the sheet:
To connect Sensor and ESC PCB
FDCAN Transceiver + DE9 Connector
6-Pin 2.54mm Connector
To connect Optional Rotary Encoder
8-Pin 2.54mm Connector

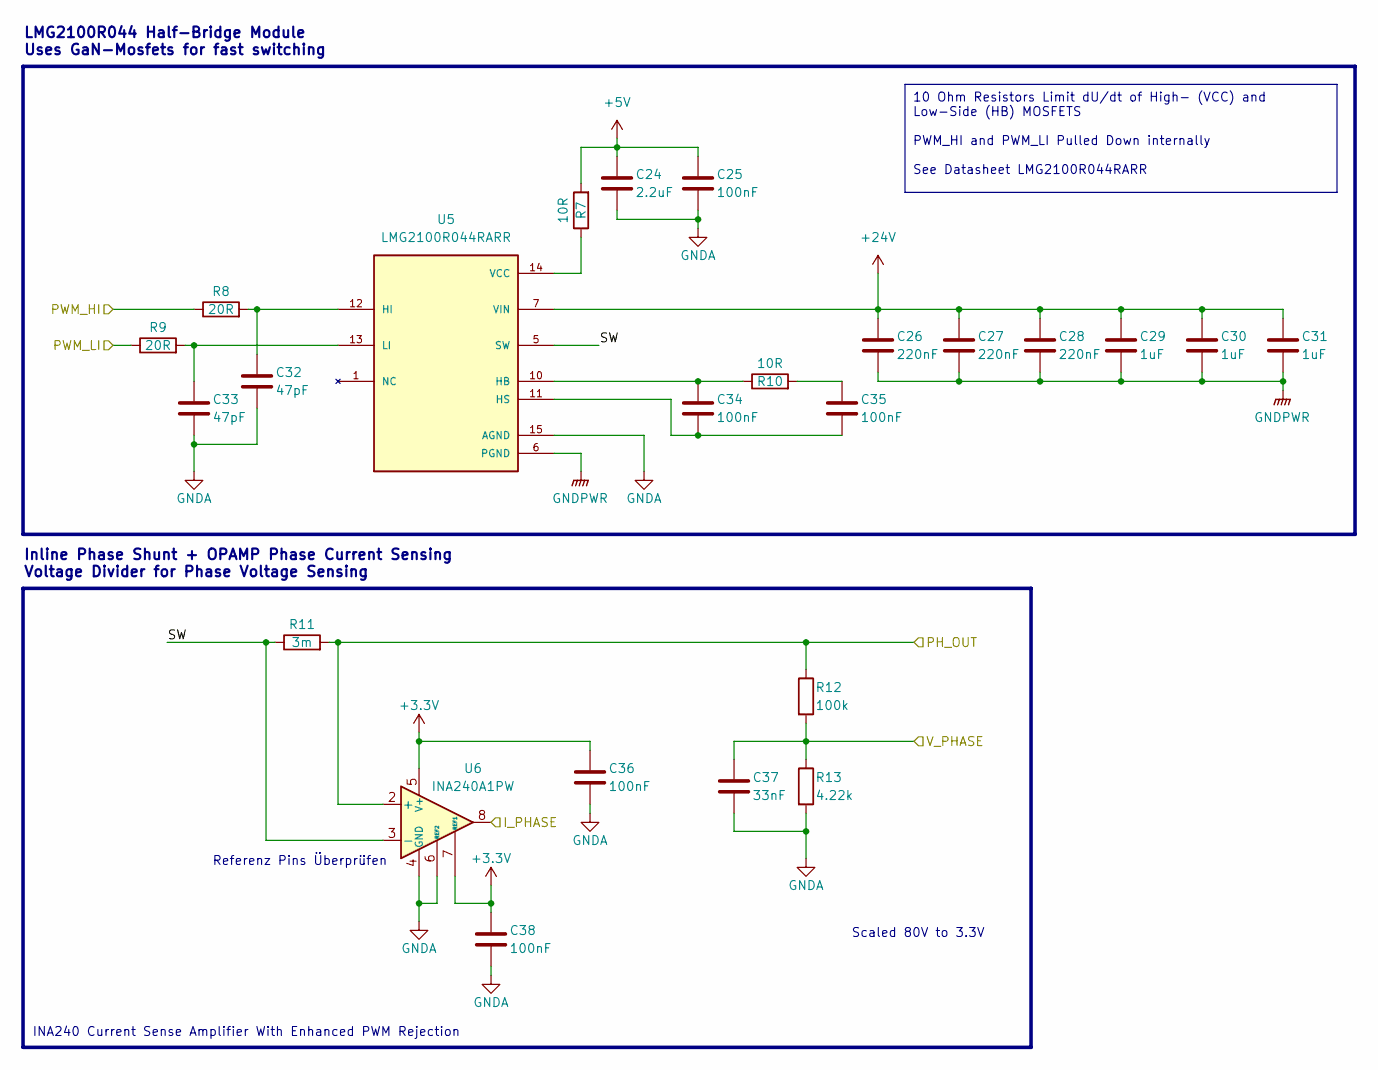
[picture p167: schematic HalfBridgePowerStage.kicad_sch, Motor Control Test Extension Board]

Parts:
C24: 2.2uF; C_0805_2012Metric_Pad1.18x1.45mm_HandSolder
C25, C34, C35, C36, C38: 100nF; C_0603_1608Metric_Pad1.08x0.95mm_HandSolder
C26, C27, C28: 220nF; C_0603_1608Metric_Pad1.08x0.95mm_HandSolder
C29, C30, C31: 1uF; C_0805_2012Metric_Pad1.18x1.45mm_HandSolder
C32, C33: 47pF; C_0603_1608Metric_Pad1.08x0.95mm_HandSolder
C37: 33nF; C_0603_1608Metric_Pad1.08x0.95mm_HandSolder
R7, R10: 10R; R_0603_1608Metric_Pad0.98x0.95mm_HandSolder
R8, R9: 20R; R_0603_1608Metric_Pad0.98x0.95mm_HandSolder
R11: 3m; R_2512_6332Metric_Pad1.40x3.35mm_HandSolder
R12: 100k; R_0603_1608Metric_Pad0.98x0.95mm_HandSolder
R13: 4.22k; R_0603_1608Metric_Pad0.98x0.95mm_HandSolder
U5: LMG2100R044RARR; RAR0016B-MFG; PARTREV B
U6: INA240A1PW; TSSOP-8_4.4x3mm_P0.65mm

Connections:
+3.3V: C36.1, C38.1, U6.5 (V+), U6.7 (REF1); also elsewhere on the board
+5V: C24.1, C25.1, R7.2; also elsewhere on the board
+24V: C26.1, C27.1, C28.1, C29.1, C30.1, C31.1, U5.7 (VIN); also elsewhere on the board
/escSheet/HalfBridgePowerStage1/I_PHASE: U6.8; also elsewhere on the board
/escSheet/HalfBridgePowerStage1/PH_OUT: R11.2, R12.1, U6.2 (+); also elsewhere on the board
/escSheet/HalfBridgePowerStage1/PWM_HI: R8.1; also elsewhere on the board
/escSheet/HalfBridgePowerStage1/PWM_LI: R9.1; also elsewhere on the board
/escSheet/HalfBridgePowerStage1/SW: R11.1, U5.5 (SW), U6.3 (-)
/escSheet/HalfBridgePowerStage1/V_PHASE: C37.1, R12.2, R13.1; also elsewhere on the board
unnamed: C35.1, R10.2
unnamed: C34.1, R10.1, U5.10 (HB)
unnamed: C32.1, R8.2, U5.12 (HI)
unnamed: C34.2, C35.2, U5.11 (HS)
unnamed: C33.1, R9.2, U5.13 (LI)
unnamed: R7.1, U5.14 (VCC)

Parts of its further copies:
C39, C54: 2.2uF; C_0805_2012Metric_Pad1.18x1.45mm_HandSolder
C40, C49, C50, C51, C53, C55, C64, C65, C66, C68: 100nF; C_0603_1608Metric_Pad1.08x0.95mm_HandSolder
C41, C42, C43, C56, C57, C58: 220nF; C_0603_1608Metric_Pad1.08x0.95mm_HandSolder
C44, C45, C46, C59, C60, C61: 1uF; C_0805_2012Metric_Pad1.18x1.45mm_HandSolder
C47, C48, C62, C63: 47pF; C_0603_1608Metric_Pad1.08x0.95mm_HandSolder
C52, C67: 33nF; C_0603_1608Metric_Pad1.08x0.95mm_HandSolder
R14, R17, R21, R24: 10R; R_0603_1608Metric_Pad0.98x0.95mm_HandSolder
R15, R16, R22, R23: 20R; R_0603_1608Metric_Pad0.98x0.95mm_HandSolder
R18, R25: 3m; R_2512_6332Metric_Pad1.40x3.35mm_HandSolder
R19, R26: 100k; R_0603_1608Metric_Pad0.98x0.95mm_HandSolder
R20, R27: 4.22k; R_0603_1608Metric_Pad0.98x0.95mm_HandSolder
U7, U9: LMG2100R044RARR; RAR0016B-MFG; PARTREV B
U8, U10: INA240A1PW; TSSOP-8_4.4x3mm_P0.65mm

Connections of its further copies:
+3.3V: C51.1, C53.1, C66.1, C68.1, U8.5 (V+), U8.7 (REF1), U10.5 (V+), U10.7 (REF1); also elsewhere on the board
+5V: C39.1, C40.1, C54.1, C55.1, R14.2, R21.2; also elsewhere on the board
+24V: C41.1, C42.1, C43.1, C44.1, C45.1, C46.1, C56.1, C57.1, C58.1, C59.1, C60.1, C61.1, U7.7 (VIN), U9.7 (VIN); also elsewhere on the board
/escSheet/HalfBridgePowerStage2/I_PHASE: U8.8; also elsewhere on the board
/escSheet/HalfBridgePowerStage2/PH_OUT: R18.2, R19.1, U8.2 (+); also elsewhere on the board
/escSheet/HalfBridgePowerStage2/PWM_HI: R15.1; also elsewhere on the board
/escSheet/HalfBridgePowerStage2/PWM_LI: R16.1; also elsewhere on the board
/escSheet/HalfBridgePowerStage2/SW: R18.1, U7.5 (SW), U8.3 (-)
/escSheet/HalfBridgePowerStage2/V_PHASE: C52.1, R19.2, R20.1; also elsewhere on the board
/escSheet/HalfBridgePowerStage3/I_PHASE: U10.8; also elsewhere on the board
/escSheet/HalfBridgePowerStage3/PH_OUT: R25.2, R26.1, U10.2 (+); also elsewhere on the board
/escSheet/HalfBridgePowerStage3/PWM_HI: R22.1; also elsewhere on the board
/escSheet/HalfBridgePowerStage3/PWM_LI: R23.1; also elsewhere on the board
/escSheet/HalfBridgePowerStage3/SW: R25.1, U9.5 (SW), U10.3 (-)
/escSheet/HalfBridgePowerStage3/V_PHASE: C67.1, R26.2, R27.1; also elsewhere on the board
unnamed: C50.1, R17.2
unnamed: C65.1, R24.2
unnamed: C49.1, R17.1, U7.10 (HB)
unnamed: C47.1, R15.2, U7.12 (HI)
unnamed: C49.2, C50.2, U7.11 (HS)
unnamed: C48.1, R16.2, U7.13 (LI)
unnamed: R14.1, U7.14 (VCC)
unnamed: C64.1, R24.1, U9.10 (HB)
unnamed: C62.1, R22.2, U9.12 (HI)
unnamed: C64.2, C65.2, U9.11 (HS)
unnamed: C63.1, R23.2, U9.13 (LI)
unnamed: R21.1, U9.14 (VCC)

Notes on the sheet:
10 Ohm Resistors Limit dU/dt of High- (VCC) and Low-Side (HB) MOSFETS PWM_HI and PWM_LI Pulled Down internally See Datasheet LMG2100R044RARR
LMG2100R044 Half-Bridge Module Uses GaN-Mosfets for fast switching
Scaled 80V to 3.3V
INA240 Current Sense Amplifier With Enhanced PWM Rejection
Referenz Pins Überprüfen
Inline Phase Shunt + OPAMP Phase Current Sensing Voltage Divider for Phase Voltage Sensing

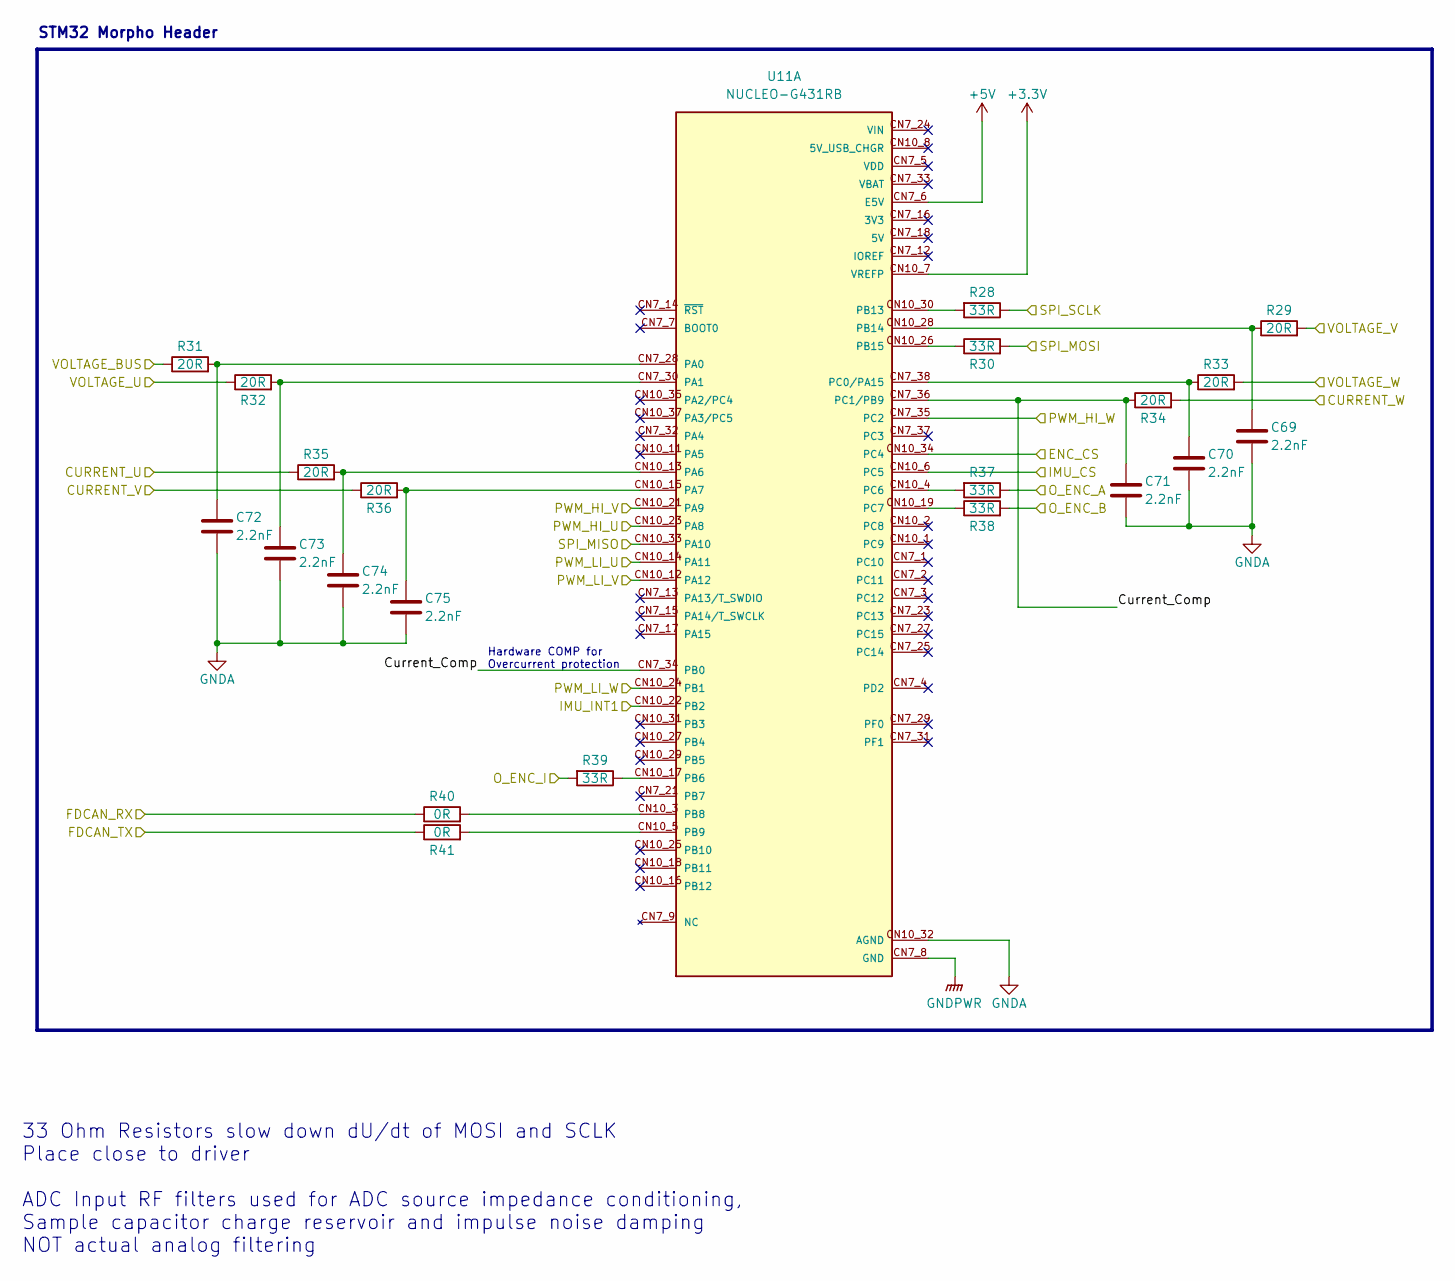
[picture p168: schematic NucleoMorpho.kicad_sch, Motor Control Test Extension Board]

Parts:
C69, C70, C71, C72, C73, C74, C75: 2.2nF; C_0603_1608Metric_Pad1.08x0.95mm_HandSolder
R28, R30, R37, R38, R39: 33R; R_0603_1608Metric_Pad0.98x0.95mm_HandSolder
R29, R31, R32, R33, R34, R35, R36: 20R; R_0603_1608Metric_Pad0.98x0.95mm_HandSolder
R40, R41: 0R; R_0603_1608Metric_Pad0.98x0.95mm_HandSolder
U11: NUCLEO-G431RB; NucleoCN7CN10; PARTREV 4

Connections:
+3.3V: U11.CN10_7 (VREFP); also elsewhere on the board
+5V: U11.CN7_6 (E5V); also elsewhere on the board
/escSheet/Bus_Connectors/ENC_CS: U11.CN10_34 (PC4); also elsewhere on the board
/escSheet/Bus_Connectors/FDCAN_RX: R40.1; also elsewhere on the board
/escSheet/Bus_Connectors/FDCAN_TX: R41.1; also elsewhere on the board
/escSheet/Bus_Connectors/IMU_CS: U11.CN10_6 (PC5); also elsewhere on the board
/escSheet/Bus_Connectors/IMU_INT1: U11.CN10_22 (PB2); also elsewhere on the board
/escSheet/Bus_Connectors/O_ENC_A: R37.1; also elsewhere on the board
/escSheet/Bus_Connectors/O_ENC_B: R38.2; also elsewhere on the board
/escSheet/Bus_Connectors/O_ENC_I: R39.2; also elsewhere on the board
/escSheet/Bus_Connectors/SPI_MISO: U11.CN10_33 (PA10); also elsewhere on the board
/escSheet/Bus_Connectors/SPI_MOSI: R30.2; also elsewhere on the board
/escSheet/Bus_Connectors/SPI_SCLK: R28.1; also elsewhere on the board
/escSheet/HalfBridgePowerStage1/I_PHASE: R35.1; also elsewhere on the board
/escSheet/HalfBridgePowerStage1/PWM_HI: U11.CN10_23 (PA8); also elsewhere on the board
/escSheet/HalfBridgePowerStage1/PWM_LI: U11.CN10_14 (PA11); also elsewhere on the board
/escSheet/HalfBridgePowerStage1/V_PHASE: R32.1; also elsewhere on the board
/escSheet/HalfBridgePowerStage2/I_PHASE: R36.1; also elsewhere on the board
/escSheet/HalfBridgePowerStage2/PWM_HI: U11.CN10_21 (PA9); also elsewhere on the board
/escSheet/HalfBridgePowerStage2/PWM_LI: U11.CN10_12 (PA12); also elsewhere on the board
/escSheet/HalfBridgePowerStage2/V_PHASE: R29.2; also elsewhere on the board
/escSheet/HalfBridgePowerStage3/I_PHASE: R34.2; also elsewhere on the board
/escSheet/HalfBridgePowerStage3/PWM_HI: U11.CN7_35 (PC2); also elsewhere on the board
/escSheet/HalfBridgePowerStage3/PWM_LI: U11.CN10_24 (PB1); also elsewhere on the board
/escSheet/HalfBridgePowerStage3/V_PHASE: R33.2; also elsewhere on the board
/escSheet/NucleoMorpho/3.3V_EN: U11.CN7_32 (PA4)
/escSheet/NucleoMorpho/Current_Comp: C71.1, R34.1, U11.CN7_34 (PB0), U11.CN7_36 (PC1/PB9)
/escSheet/NucleoMorpho/VOLTAGE_BUS: R31.1; also elsewhere on the board
unnamed: C72.1, R31.2, U11.CN7_28 (PA0)
unnamed: C73.1, R32.2, U11.CN7_30 (PA1)
unnamed: C74.1, R35.2, U11.CN10_13 (PA6)
unnamed: C75.1, R36.2, U11.CN10_15 (PA7)
unnamed: R39.1, U11.CN10_17 (PB6)
unnamed: R40.2, U11.CN10_3 (PB8)
unnamed: R41.2, U11.CN10_5 (PB9)
unnamed: R28.2, U11.CN10_30 (PB13)
unnamed: C69.1, R29.1, U11.CN10_28 (PB14)
unnamed: R30.1, U11.CN10_26 (PB15)
unnamed: C70.1, R33.1, U11.CN7_38 (PC0/PA15)
unnamed: R37.2, U11.CN10_4 (PC6)
unnamed: R38.1, U11.CN10_19 (PC7)

Notes on the sheet:
33 Ohm Resistors slow down dU/dt of MOSI and SCLK Place close to driver ADC Input RF filters used for ADC source impedance conditioning, Sample capacitor charge reservoir and impulse noise damping NOT actual analog filtering
STM32 Morpho Header
Hardware COMP for Overcurrent protection

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
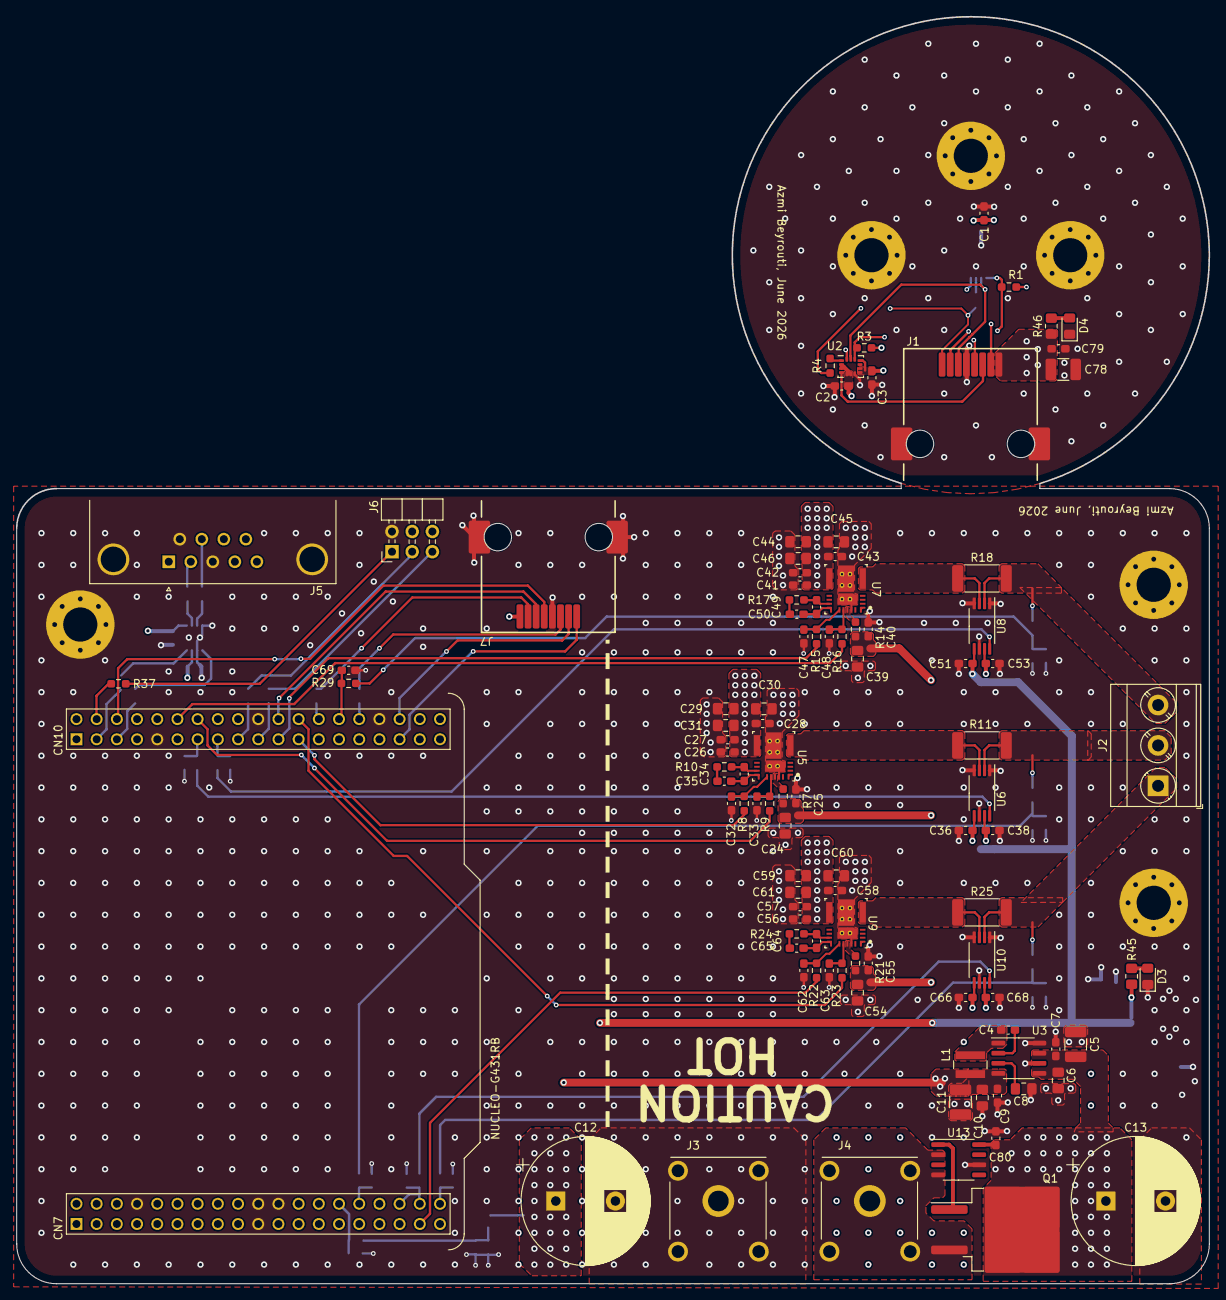
[picture p169: board Testplatine.kicad_pcb from above]

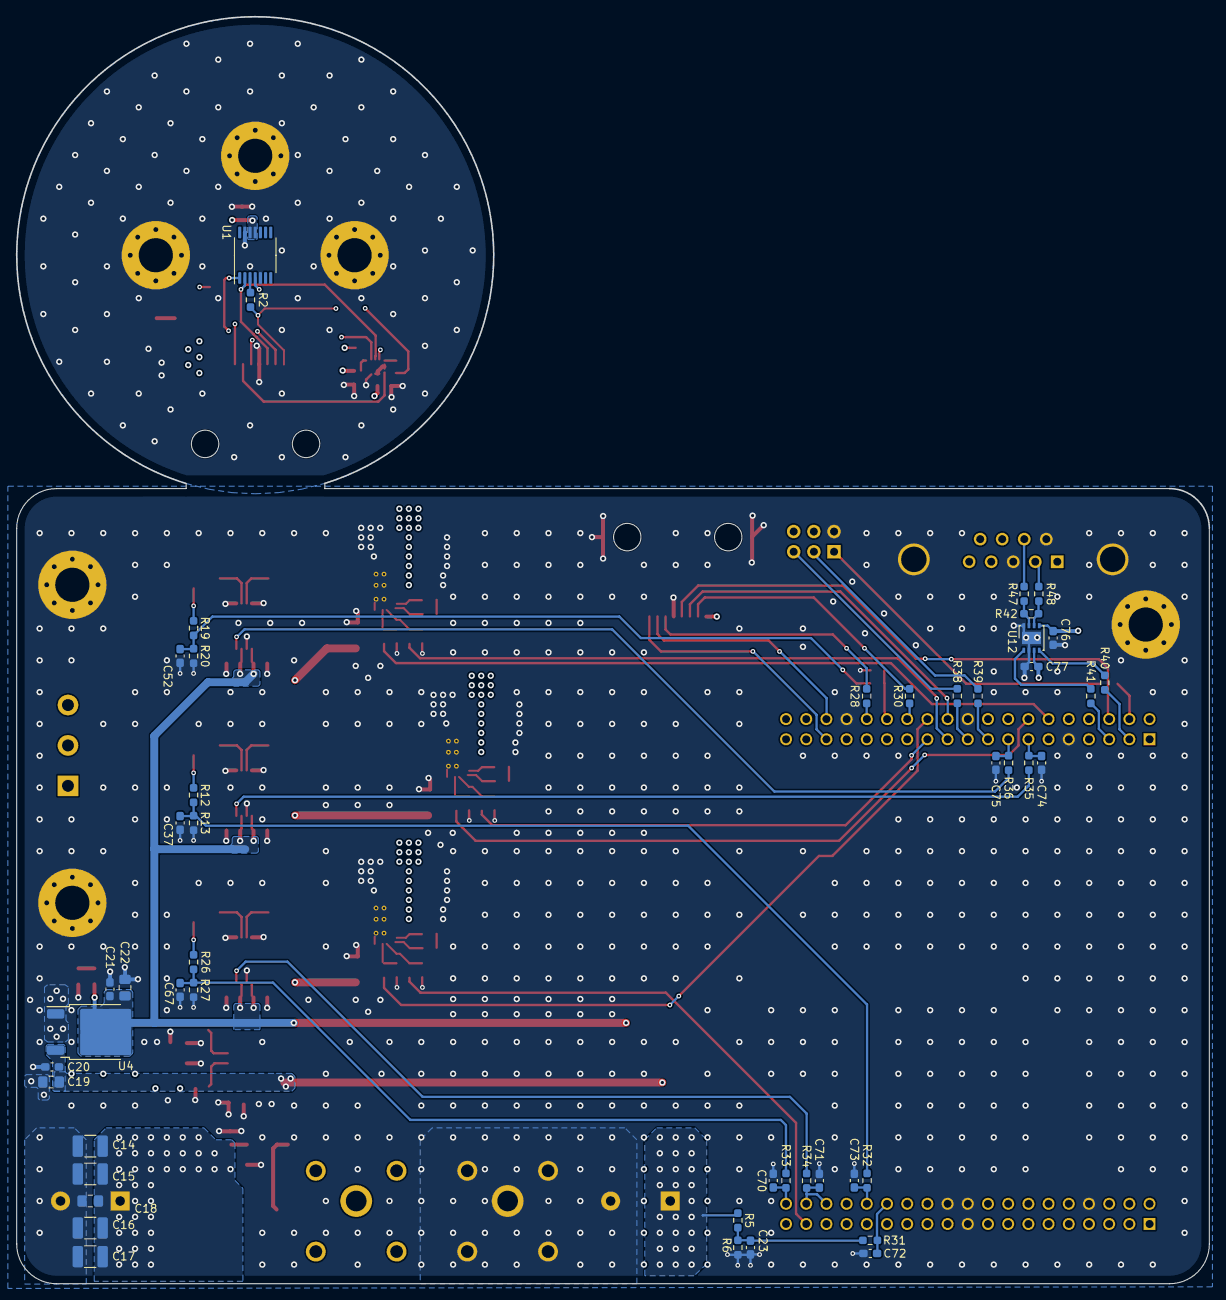
[picture p170: board Testplatine.kicad_pcb from below]

Board: 4 copper layers, 150.0 x 159.3 mm, 156 parts (48 on the bottom side), 87 nets.
