Azmi0205/Bachelorarbeit/05Software/STM_Workspace/Pilotix6SC_Measurement/Inc/drive_parameters.h

#define DRIVE_PARAMETERS_H
#define MAX_APPLICATION_SPEED_RPM          2130
#define MIN_APPLICATION_SPEED_RPM          (0 + (U_RPM / SPEED_UNIT))
#define M1_SS_MEAS_ERRORS_BEFORE_FAULTS    50
#define M1_BEMF_SAMPLING_TIME              LL_ADC_SAMPLING_CYCLE(47)
#define BEMF_AVERAGING_FIFO_DEPTH          8
#define VARIANCE_THRESHOLD                 0.1
#define BEMF_THRESHOLD_PWM_PERC            50
#define BEMF_THRESHOLD_HIGH_PERC           100
#define BEMF_THRESHOLD_LOW_PERC  	       1
#define BEMF_ADC_TRIG_TIME_DPP             ((uint16_t)921)
#define BEMF_ADC_TRIG_TIME_ON_DPP          ((uint16_t)256)
#define BEMF_PWM_ON_ENABLE_THRES_DPP       ((uint16_t)716)
#define BEMF_PWM_ON_ENABLE_HYSTERESIS_DPP  ((uint16_t)51)
#define ZCD_RISING_TO_COMM                 ((uint16_t)30)
#define ZCD_FALLING_TO_COMM                ((uint16_t)30)
#define MIN_DEMAG_TIME                     ((uint16_t)2)
#define SPEED_THRESHOLD_DEMAG              ((uint32_t)1800)
#define DEMAG_RUN_STEP_RATIO               ((uint16_t)20)
#define DEMAG_REVUP_STEP_RATIO             ((uint16_t)20)
#define M1_MAX_CONSECUTIVE_BEMF_ERRORS     10
#define ADC_AWD_FILTER_NUMBER              (uint8_t)0
#define COMPUTATION_DELAY                  -2
#define BEMF_DIVIDER_DIODE_V               1
#define PWM_FREQUENCY                      30000
#define PWM_FREQ_SCALING                   1
#define PWM_FREQUENCY_REF                  60000
#define LOW_SIDE_SIGNALS_ENABLING          ES_GPIO
#define REP_COUNTER                        0
#define SPEED_LOOP_FREQUENCY_HZ            (uint16_t)1000
#define PID_SPEED_KP_DEFAULT               3170/(SPEED_UNIT/10)
#define PID_SPEED_KI_DEFAULT               418/(SPEED_UNIT/10)
#define PID_SPEED_KD_DEFAULT               0/(SPEED_UNIT/10)
#define SP_KPDIV                           128
#define SP_KIDIV                           16384
#define SP_KDDIV                           16
#define SP_KPDIV_LOG                       LOG2((128))
#define SP_KIDIV_LOG                       LOG2((16384))
#define SP_KDDIV_LOG                       LOG2((16))
#define PID_SPEED_INTEGRAL_INIT_DIV 1
#define SPD_DIFFERENTIAL_TERM_ENABLING     DISABLE
#define PERIODMAX                          (uint16_t)((PWM_PERIOD_CYCLES * 100 / 100) + 1)
#define LF_TIMER_ARR                       65535
#define LF_TIMER_PSC                       100U
#define DEFAULT_CONTROL_MODE               MCM_SPEED_MODE
#define DEFAULT_DRIVE_MODE                 VM
#define DEFAULT_TARGET_SPEED_RPM           0
#define DEFAULT_TARGET_SPEED_UNIT          (DEFAULT_TARGET_SPEED_RPM*SPEED_UNIT/U_RPM)
#define OV_VOLTAGE_THRESHOLD_V             16.7
#define UD_VOLTAGE_THRESHOLD_V             7.0
#ifdef NOT_IMPLEMENTED
#define ON_OVER_VOLTAGE                    TURN_OFF_PWM
#endif
#define OV_TEMPERATURE_THRESHOLD_C         110
#define OV_TEMPERATURE_HYSTERESIS_C        10
#define PHASE1_DURATION                    500
#define PHASE1_FINAL_SPEED_UNIT            (0*SPEED_UNIT/U_RPM)
#define PHASE1_VOLTAGE_RMS                 2.24
#define PHASE2_DURATION                    1000
#define PHASE2_FINAL_SPEED_UNIT            (320*SPEED_UNIT/U_RPM)
#define PHASE2_VOLTAGE_RMS                 5.24
#define PHASE3_DURATION                    500
#define PHASE3_FINAL_SPEED_UNIT            (320*SPEED_UNIT/U_RPM)
#define PHASE3_VOLTAGE_RMS                 5.24
#define PHASE4_DURATION                    0
#define PHASE4_FINAL_SPEED_UNIT            (0*SPEED_UNIT/U_RPM)
#define PHASE4_VOLTAGE_RMS                 2.24
#define PHASE5_DURATION                    0
#define PHASE5_FINAL_SPEED_UNIT            (0*SPEED_UNIT/U_RPM)
#define PHASE5_VOLTAGE_RMS                 2.24
#define ALIGN_STEP                         1
#define OBS_MINIMUM_SPEED_RPM              320
#define NB_CONSECUTIVE_TESTS               5
#define M1_OTF_MAX_BEMF_ERRORS             3
#define M1_OTF_LS_DETECT_PERC              2
#define M1_OTF_LS_BRAKE_PERC               10
#define M1_OTF_BEMF_THRESHOLD_PERC         10
#define M1_OTF_SPEED_DUTY_CYCLE_RATIO      3
#define  M1_VBUS_SAMPLING_TIME             LL_ADC_SAMPLING_CYCLE(47)
#define  M1_TEMP_SAMPLING_TIME             LL_ADC_SAMPLING_CYCLE(47)
#define REGULAR_CONVERSION_RATE_MS         5U
#define POTENTIOMETER_ADC_SAMPLING_TIME_M1 LL_ADC_SAMPLING_CYCLE(47)
#define POTENTIOMETER_MAX_SPEED_M1         MAX_APPLICATION_SPEED_UNIT
#define POTENTIOMETER_MIN_SPEED_M1         ((MAX_APPLICATION_SPEED_UNIT)/10)
 #define POTENTIOMETER_SPEED_ADJUSTMENT_RANGE_M1 (655)
 #define POTENTIOMETER_RAMP_SLOPE_M1       1000
#define POTENTIOMETER_LPF_BANDWIDTH_POW2_M1 4
