Azmi0205/Bachelorarbeit/05Software/STM_Workspace/Pilotix6SC_Measurement/Src/main.c

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
/* Includes ------------------------------------------------------------------*/
#include "main.h"

ADC_HandleTypeDef hadc1;
ADC_HandleTypeDef hadc2;

TIM_HandleTypeDef htim1;
TIM_HandleTypeDef htim2;

UART_HandleTypeDef huart2;
DMA_HandleTypeDef hdma_usart2_rx;
DMA_HandleTypeDef hdma_usart2_tx;

/* USER CODE BEGIN PV */
static volatile float USER_CPU_Load = 0.0f;
static volatile float USER_SPEED_REF = 0.0f;
static volatile float USER_SPEED_MEAS = 0;
static volatile float USER_SPEED_AVR = 0;
/* USER CODE END PV */

void SystemClock_Config(void);
static void MX_GPIO_Init(void);
static void MX_DMA_Init(void);
static void MX_ADC1_Init(void);
static void MX_ADC2_Init(void);
static void MX_TIM1_Init(void);
static void MX_TIM2_Init(void);
static void MX_USART2_UART_Init(void);
static void MX_NVIC_Init(void);
/**
  * @brief  The application entry point.
  * @retval int
  */
int main(void)
{

  /* MCU Configuration--------------------------------------------------------*/

  /* Reset of all peripherals, Initializes the Flash interface and the Systick. */
  HAL_Init();

  /* Configure the system clock */
  SystemClock_Config();

  /* Initialize all configured peripherals */
  MX_GPIO_Init();
  MX_DMA_Init();
  MX_ADC1_Init();
  MX_ADC2_Init();
  MX_TIM1_Init();
  MX_TIM2_Init();
  MX_USART2_UART_Init();
  MX_MotorControl_Init();

  /* Initialize interrupts */
  MX_NVIC_Init();
  /* Infinite loop */
  /* USER CODE BEGIN WHILE */
	while (1) {
		uint8_t motorID = 0;
		MCI_Handle_t *pMCIN = &Mci[motorID];

		USER_CPU_Load = MC_Perf_GetCPU_Load(pMCIN->pPerfMeasure);
		USER_SPEED_REF = (((float) MCI_GetMecSpeedRefUnit(pMCIN) * U_RPM)
				/ SPEED_UNIT);

		USER_SPEED_MEAS = (float) (((float) Bemf_ADC_M1._Super.speedConvFactor)
				/ Bemf_ADC_M1.SpeedBufferDpp[Bemf_ADC_M1.SpeedFIFOIdx])
				/ SPEED_UNIT * U_RPM;

		USER_SPEED_AVR =
				(float) ((float) Bemf_ADC_M1._Super.speedConvFactor
						/ (Bemf_ADC_M1.ElPeriodSum
								/ (float) Bemf_ADC_M1.SpeedBufferSize))
						/ SPEED_UNIT * U_RPM;

    /* USER CODE END WHILE */

    /* USER CODE BEGIN 3 */
	}
  /* USER CODE END 3 */
}

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
