Azmi0205/Bachelorarbeit/05Software/STM_Workspace/Pilotix6SC_Measurement/Pilotix6SC_Measurement.ioc

Mcu.UserName=STM32G431RBTx
PA0.GPIO_Label=M1_BUS_VOLTAGE
PA0.Signal=ADC1_IN1
PA10.GPIO_Label=M1_PWM_WH
PA10.Signal=S_TIM1_CH3
PA2.GPIO_Label=UART_TX
PA2.Signal=USART2_TX
PA3.GPIO_Label=UART_RX
PA3.Signal=USART2_RX
PA8.GPIO_Label=M1_PWM_UH
PA8.Signal=S_TIM1_CH1
PA9.GPIO_Label=M1_PWM_VH
PA9.Signal=S_TIM1_CH2
PB13.GPIO_Label=M1_PWM_EN_U
PB13.Signal=GPIO_Output
PB14.GPIO_Label=M1_PWM_EN_V
PB14.Signal=GPIO_Output
PB15.GPIO_Label=M1_PWM_EN_W
PB15.Signal=GPIO_Output
PC0.GPIO_Label=M1_BEMF_U
PC0.Signal=ADC1_IN6
PC1.GPIO_Label=M1_BEMF_W
PC1.Signal=ADC2_IN7
PC13.GPIO_Label=Start/Stop [PushButton]
PC13.Signal=GPXTI13
PC2.GPIO_Label=M1_POTENTIOMETER
PC2.Signal=ADC1_IN8
PC3.GPIO_Label=M1_BEMF_V
PC3.Signal=ADC2_IN9
PC4.GPIO_Label=M1_TEMPERATURE
PC4.Signal=ADC2_IN5
PC9.GPIO_Label=M1_BEMF_DIVIDER
PC9.Signal=GPIO_Output
PF0-OSC_IN.Signal=RCC_OSC_IN
PF1-OSC_OUT.Signal=RCC_OSC_OUT
