Azmi0205/Bachelorarbeit/05Software/STM_Workspace/Pilotix6SC_Measurement/Inc/main.h

#define Start_Stop_Pin GPIO_PIN_13
#define Start_Stop_GPIO_Port GPIOC
#define Start_Stop_EXTI_IRQn EXTI15_10_IRQn
#define M1_BEMF_U_Pin GPIO_PIN_0
#define M1_BEMF_U_GPIO_Port GPIOC
#define M1_BEMF_W_Pin GPIO_PIN_1
#define M1_BEMF_W_GPIO_Port GPIOC
#define M1_POTENTIOMETER_Pin GPIO_PIN_2
#define M1_POTENTIOMETER_GPIO_Port GPIOC
#define M1_BEMF_V_Pin GPIO_PIN_3
#define M1_BEMF_V_GPIO_Port GPIOC
#define M1_BUS_VOLTAGE_Pin GPIO_PIN_0
#define M1_BUS_VOLTAGE_GPIO_Port GPIOA
#define UART_TX_Pin GPIO_PIN_2
#define UART_TX_GPIO_Port GPIOA
#define UART_RX_Pin GPIO_PIN_3
#define UART_RX_GPIO_Port GPIOA
#define M1_TEMPERATURE_Pin GPIO_PIN_4
#define M1_TEMPERATURE_GPIO_Port GPIOC
#define M1_PWM_EN_U_Pin GPIO_PIN_13
#define M1_PWM_EN_U_GPIO_Port GPIOB
#define M1_PWM_EN_V_Pin GPIO_PIN_14
#define M1_PWM_EN_V_GPIO_Port GPIOB
#define M1_PWM_EN_W_Pin GPIO_PIN_15
#define M1_PWM_EN_W_GPIO_Port GPIOB
#define M1_BEMF_DIVIDER_Pin GPIO_PIN_9
#define M1_BEMF_DIVIDER_GPIO_Port GPIOC
#define M1_PWM_UH_Pin GPIO_PIN_8
#define M1_PWM_UH_GPIO_Port GPIOA
#define M1_PWM_VH_Pin GPIO_PIN_9
#define M1_PWM_VH_GPIO_Port GPIOA
#define M1_PWM_WH_Pin GPIO_PIN_10
#define M1_PWM_WH_GPIO_Port GPIOA
