Azmi0205/Bachelorarbeit/05Software/STM_Workspace/Pilotix6SC_Measurement/MCSDK_v6.4.2-Full/MotorControl/MCSDK/MCLib/Any/Src/revup_ctrl.c

/**
  ******************************************************************************
  * @file    revup_ctrl.c
  * @author  Motor Control SDK Team, ST Microelectronics
  * @brief   This file provides firmware functions that implement the features
  *          of the Rev-Up Control component of the Motor Control SDK:
  *
  *          * Main Rev-Up procedure to execute programmed phases
  *          * On the Fly (OTF)
  *
  ******************************************************************************
  * @attention
  *
  * <h2><center>&copy; Copyright (c) 2026 STMicroelectronics International N.V.
  * All rights reserved.</center></h2>
  *
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
  ******************************************************************************
  * @ingroup RevUpCtrlFOC
  */

/* Includes ------------------------------------------------------------------*/
#include "revup_ctrl.h"

/** @addtogroup MCSDK
  * @{
  */

  
/** @addtogroup ConvFOC
  * @{
  */

/** @addtogroup MCLLAPI
  * @{
  */

/** @defgroup RevUpCtrl Rev-Up Control
  * @brief Rev-Up Control component of the Motor Control SDK
  *
  * Used to start up the motor with a set of pre-programmed phases.
  *
  * The number of phases of the Rev-Up procedure range is from 0 to 5.
  * The Rev-Up controller must be called at speed loop frequency.
  *
  * @{
  */
  
  
  

/** @defgroup RevUpCtrlFOC FOC Rev-Up Control component
  * @brief Rev-Up control component used to start motor driven with 
  *        the Field Oriented Control technique
  *
  * @{
  */

/* Private defines -----------------------------------------------------------*/

/**
  * @brief Timeout used to reset integral term of PLL.
  *  It is expressed in ms.
  *
  */
#define RUC_OTF_PLL_RESET_TIMEOUT 100u


/* Private functions ----------------------------------------------------------*/


/* Returns the  mechanical speed of a selected phase */
static inline int16_t RUC_GetPhaseFinalMecSpeed01Hz(RevUpCtrl_Handle_t *pHandle, uint8_t bPhase)
{
  return (pHandle->ParamsData[bPhase].hFinalMecSpeedUnit);
}


/**
  * @brief  Initialize and configure the FOC RevUpCtrl Component
  * @param  pHandle: Pointer on Handle structure of FOC RevUp controller.
  * @param  pSTC: Pointer on speed and torque controller structure.
  * @param  pVSS: Pointer on virtual speed sensor structure.
  * @param  pSNSL: Pointer on sensorless state observer structure.
  * @param  pPWM: Pointer on the PWM structure.
  */
__weak void RUC_Init(RevUpCtrl_Handle_t *pHandle,
                     SpeednTorqCtrl_Handle_t *pSTC,
                     VirtualSpeedSensor_Handle_t *pVSS,
                     STO_Handle_t *pSNSL,
                     PWMC_Handle_t *pPWM)
{
#ifdef NULL_PTR_CHECK_REV_UP_CTL
  if (MC_NULL == pHandle)
  {
    /* Nothing to do */
  }
  else
  {
#endif
    RevUpCtrl_PhaseParams_t *pRUCPhaseParams = &pHandle->ParamsData[0];
    uint8_t bPhase = 0U;

    pHandle->pSTC = pSTC;
    pHandle->pVSS = pVSS;
    pHandle->pSNSL = pSNSL;
    pHandle->pPWM = pPWM;
    pHandle->OTFSCLowside = false;
    pHandle->EnteredZone1 = false;

    while ((pRUCPhaseParams != MC_NULL) && (bPhase < RUC_MAX_PHASE_NUMBER))
    {
      /* Dump HF data for now HF data are forced to 16 bits */
      pRUCPhaseParams = (RevUpCtrl_PhaseParams_t *)pRUCPhaseParams->pNext;  //cstat !MISRAC2012-Rule-11.5
      bPhase++;
    }

    if (0U == bPhase)
    {
      /* nothing to do error */
    }
    else
    {
      pHandle->ParamsData[bPhase - 1u].pNext = MC_NULL;

      pHandle->bPhaseNbr = bPhase;

      pHandle->bResetPLLTh = (uint8_t)((RUC_OTF_PLL_RESET_TIMEOUT * pHandle->hRUCFrequencyHz) / 1000U);
    }
#ifdef NULL_PTR_CHECK_REV_UP_CTL
  }
#endif
}

/**
  * @brief  Initialize internal FOC RevUp controller state.
  * @param  pHandle: Pointer on Handle structure of RevUp controller.
  * @param  hMotorDirection: Rotor rotation direction.
  *         This parameter must be -1 or +1.
  */
__weak void RUC_Clear(RevUpCtrl_Handle_t *pHandle, int16_t hMotorDirection)
{
#ifdef NULL_PTR_CHECK_REV_UP_CTL
  if (MC_NULL == pHandle)
  {
    /* Nothing to do */
  }
  else
  {
#endif
    VirtualSpeedSensor_Handle_t *pVSS = pHandle->pVSS;
    SpeednTorqCtrl_Handle_t *pSTC = pHandle->pSTC;
    RevUpCtrl_PhaseParams_t *pPhaseParams = pHandle->ParamsData;

    pHandle->hDirection = hMotorDirection;
    pHandle->EnteredZone1 = false;

    /* Initializes the rev up stages counter */
    pHandle->bStageCnt = 0U;
    pHandle->bOTFRelCounter = 0U;
    pHandle->OTFSCLowside = false;

    /* Calls the clear method of VSS */
    VSS_Clear(pVSS);

    /* Sets the STC in torque mode */
    STC_SetControlMode(pSTC, MCM_TORQUE_MODE);

    /* Sets the mechanical starting angle of VSS */
    VSS_SetMecAngle(pVSS, pHandle->hStartingMecAngle * hMotorDirection);

    /* Sets to zero the starting torque of STC */
    (void)STC_ExecRamp(pSTC, 0, 0U);

    /* Gives the first command to STC and VSS */
    (void)STC_ExecRamp(pSTC, pPhaseParams->hFinalTorque * hMotorDirection, (uint32_t)(pPhaseParams->hDurationms));

    VSS_SetMecAcceleration(pVSS, pPhaseParams->hFinalMecSpeedUnit * hMotorDirection, pPhaseParams->hDurationms);

    /* Compute hPhaseRemainingTicks */
    pHandle->hPhaseRemainingTicks = (uint16_t)((((uint32_t)pPhaseParams->hDurationms)
                                              * ((uint32_t)pHandle->hRUCFrequencyHz))
                                              / 1000U );

    pHandle->hPhaseRemainingTicks++;

    /* Set the next phases parameter pointer */
    pHandle->pCurrentPhaseParams = (RevUpCtrl_PhaseParams_t *)pPhaseParams->pNext;  //cstat !MISRAC2012-Rule-11.5

    /* Timeout counter for PLL reset during OTF */
    pHandle->bResetPLLCnt = 0U;
#ifdef NULL_PTR_CHECK_REV_UP_CTL
  }
#endif
}

/**
  * @brief  FOC Main Rev-Up controller procedure executing overall programmed phases and
  *         on-the-fly startup handling.
  * @param  pHandle: Pointer on Handle structure of RevUp controller.
  *  @retval Boolean set to false when entire Rev-Up phases have been completed.
  */
__weak bool RUC_OTF_Exec(RevUpCtrl_Handle_t *pHandle)
{
  bool retVal = true;
#ifdef NULL_PTR_CHECK_REV_UP_CTL
  if (MC_NULL == pHandle)
  {
    /* Nothing to do */
  }
  else
  {
#endif
    bool IsSpeedReliable;
    bool condition = false;

    if (pHandle->hPhaseRemainingTicks > 0u)
    {
      /* Decrease the hPhaseRemainingTicks */
      pHandle->hPhaseRemainingTicks--;

      /* OTF start-up */
      if (0U == pHandle->bStageCnt)
      {
        if (false ==  pHandle->EnteredZone1)
        {
          if (pHandle->pSNSL->pFctStoOtfResetPLL != MC_NULL)
          {
            pHandle->bResetPLLCnt++;
            if (pHandle->bResetPLLCnt > pHandle->bResetPLLTh)
            {
              pHandle->pSNSL->pFctStoOtfResetPLL(pHandle->pSNSL);
              pHandle->bOTFRelCounter = 0U;
              pHandle->bResetPLLCnt = 0U;
            }
            else
            {
              /* Nothing to do */
            }
          }
          else
          {
            /* Nothing to do */
          }

          IsSpeedReliable = pHandle->pSNSL->pFctSTO_SpeedReliabilityCheck(pHandle->pSNSL);

          if (IsSpeedReliable)
          {
            if (pHandle->bOTFRelCounter < 127U)
            {
              pHandle->bOTFRelCounter++;
            }
            else
            {
              /* Nothing to do */
            }
          }
          else
          {
            pHandle->bOTFRelCounter = 0U;
          }

          if (pHandle->pSNSL->pFctStoOtfResetPLL != MC_NULL)
          {
            if (pHandle->bOTFRelCounter == (pHandle->bResetPLLTh >> 1))
            {
              condition = true;
            }
            else
            {
              /* Nothing to do */
            }
          }
          else
          {
            if (127U == pHandle->bOTFRelCounter)
            {
              condition = true;
            }
            else
            {
              /* Nothing to do */
            }
          }

          if (true == condition)
          {
            bool bCollinearSpeed = false;
            int16_t hObsSpeedUnit = SPD_GetAvrgMecSpeedUnit(pHandle->pSNSL->_Super);
            int16_t hObsSpeedUnitAbsValue =
                    ((hObsSpeedUnit < 0) ? (-hObsSpeedUnit) : (hObsSpeedUnit)); /* hObsSpeedUnit absolute value */

            if (pHandle->hDirection > 0)
            {
              if (hObsSpeedUnit > 0)
              {
                bCollinearSpeed = true; /* Actual and reference speed are collinear */
              }
              else
              {
                /* Nothing to do */
              }
            }
            else
            {
              if (hObsSpeedUnit < 0)
              {
                bCollinearSpeed = true; /* Actual and reference speed are collinear */
              }
              else
              {
                /* Nothing to do */
              }
            }

            if (false == bCollinearSpeed)
            {
              /*reverse speed management*/
              pHandle->bOTFRelCounter = 0U;
            }
            else /* Speeds are collinear */
            {
              if ((uint16_t)(hObsSpeedUnitAbsValue) > pHandle->hMinStartUpValidSpeed)
              {
                /* Startup end, go to run */
                pHandle->pSNSL->pFctForceConvergency1(pHandle->pSNSL);
                pHandle->EnteredZone1 = true;
              }
              else if ((uint16_t)(hObsSpeedUnitAbsValue) > pHandle->hMinStartUpFlySpeed)
              {
                /* Synch with startup */
                /* Nearest phase search */
                int16_t hOldFinalMecSpeedUnit = 0;
                int16_t hOldFinalTorque = 0;
                int32_t wDeltaSpeedRevUp;
                int32_t wDeltaTorqueRevUp;
                bool bError = false;
                VSS_SetCopyObserver(pHandle->pVSS);
                pHandle->pSNSL->pFctForceConvergency2(pHandle->pSNSL);

                if (MC_NULL == pHandle->pCurrentPhaseParams)
                {
                  bError = true;
                  pHandle->hPhaseRemainingTicks = 0U;
                }
                else
                {
                  while (pHandle->pCurrentPhaseParams->hFinalMecSpeedUnit < hObsSpeedUnitAbsValue)
                  {
                    if (pHandle->pCurrentPhaseParams->pNext == MC_NULL)
                    {
                      /* Sets for Revup fail error */
                      bError = true;
                      pHandle->hPhaseRemainingTicks = 0U;
                      break;
                    }
                    else
                    {
                      /* Skips this phase */
                      hOldFinalMecSpeedUnit = pHandle->pCurrentPhaseParams->hFinalMecSpeedUnit;
                      hOldFinalTorque = pHandle->pCurrentPhaseParams->hFinalTorque;
                      //cstat !MISRAC2012-Rule-11.5
                      pHandle->pCurrentPhaseParams = (RevUpCtrl_PhaseParams_t *)pHandle->pCurrentPhaseParams->pNext;
                      pHandle->bStageCnt++;
                    }
                  }
                }
                if (false == bError)
                {
                  /* Calculation of the transition phase from OTF to standard revup */
                  int16_t hTorqueReference;

                  wDeltaSpeedRevUp = ((int32_t)(pHandle->pCurrentPhaseParams->hFinalMecSpeedUnit))
                                   - ((int32_t)(hOldFinalMecSpeedUnit));
                  wDeltaTorqueRevUp = ((int32_t)(pHandle->pCurrentPhaseParams->hFinalTorque))
                                    - ((int32_t)(hOldFinalTorque));

                  if ((int32_t)0 == wDeltaSpeedRevUp)
                  {
                    /* Nothing to do */
                  }
                  else
                  {
                    hTorqueReference = (int16_t)((((int32_t)hObsSpeedUnit) * wDeltaTorqueRevUp) / wDeltaSpeedRevUp)
                                     + hOldFinalTorque;

                    (void)STC_ExecRamp(pHandle->pSTC, pHandle->hDirection * hTorqueReference, 0U);
                  }

                  pHandle->hPhaseRemainingTicks = 1U;

                  pHandle->pCurrentPhaseParams = &pHandle->OTFPhaseParams;

                  pHandle->bStageCnt = 6U;
                } /* No MC_NULL error */
              } /* Speed > MinStartupFly */
              else
              {
                /* Nothing to do */
              }
            } /* Speeds are collinear */
          } /* Speed is reliable */
        }/* EnteredZone1 1 is false */
        else
        {
          pHandle->pSNSL->pFctForceConvergency1(pHandle->pSNSL);
        }
      } /* Stage 0 */
    } /* hPhaseRemainingTicks > 0 */

    if (0U == pHandle->hPhaseRemainingTicks)
    {
      if (pHandle->pCurrentPhaseParams != MC_NULL)
      {
        if (0U == pHandle->bStageCnt)
        {
          /* End of OTF */
          PWMC_SwitchOffPWM(pHandle->pPWM);
          pHandle->OTFSCLowside = true;
          PWMC_TurnOnLowSides(pHandle->pPWM, 0u);
          pHandle->bOTFRelCounter = 0U;
        }
        else if (1U == pHandle->bStageCnt)
        {
          PWMC_SwitchOnPWM(pHandle->pPWM);
          pHandle->OTFSCLowside = false;
        }
        else
        {
          /* Nothing to do */
        }


        /* If it becomes zero the current phase has been completed */
        /* Gives the next command to STC and VSS */
        (void)STC_ExecRamp(pHandle->pSTC, pHandle->pCurrentPhaseParams->hFinalTorque * pHandle->hDirection,
                           (uint32_t)(pHandle->pCurrentPhaseParams->hDurationms));

        VSS_SetMecAcceleration(pHandle->pVSS,
                               pHandle->pCurrentPhaseParams->hFinalMecSpeedUnit * pHandle->hDirection,
                               pHandle->pCurrentPhaseParams->hDurationms);

        /* Compute hPhaseRemainingTicks */
        pHandle->hPhaseRemainingTicks = (uint16_t)((((uint32_t)pHandle->pCurrentPhaseParams->hDurationms)
                                                 * (uint32_t)pHandle->hRUCFrequencyHz) / 1000U);
        pHandle->hPhaseRemainingTicks++;

        /* Set the next phases parameter pointer */
        pHandle->pCurrentPhaseParams = pHandle->pCurrentPhaseParams->pNext; //cstat !MISRAC2012-Rule-11.5

        /* Increases the rev up stages counter */
        pHandle->bStageCnt++;
      }
      else
      {
        if (pHandle->bStageCnt == (pHandle->bPhaseNbr - (uint8_t)1)) /* End of user programmed revup */
        {
          retVal = false;
        }
        else if (7U == pHandle->bStageCnt) /* End of first OTF runs */
        {
          pHandle->bStageCnt = 0U; /* Breaking state */
          pHandle->hPhaseRemainingTicks = 0U;
        }
        else
        {
          /* Nothing to do */
        }
      }
    }
#ifdef NULL_PTR_CHECK_REV_UP_CTL
  }
#endif
  return (retVal);
}

/**
  * @brief  FOC Main Rev-Up controller procedure executing overall programmed phases.
  * @param  pHandle: Pointer on Handle structure of RevUp controller.
  *  @retval Boolean set to false when entire Rev-Up phases have been completed.
  */
__weak bool RUC_Exec(RevUpCtrl_Handle_t *pHandle)
{
  bool retVal = true;
#ifdef NULL_PTR_CHECK_REV_UP_CTL
  if (MC_NULL == pHandle)
  {
    retVal = false;
  }
  else
  {
#endif
    if (pHandle->hPhaseRemainingTicks > 0U)
    {
      /* Decrease the hPhaseRemainingTicks */
      pHandle->hPhaseRemainingTicks--;

    } /* hPhaseRemainingTicks > 0 */
    else
    {
      /* Nothing to do */
    }

    if (0U == pHandle->hPhaseRemainingTicks)
    {
      if (pHandle->pCurrentPhaseParams != MC_NULL)
      {
        /* If it becomes zero the current phase has been completed */
        /* Gives the next command to STC and VSS */
        (void)STC_ExecRamp(pHandle->pSTC, pHandle->pCurrentPhaseParams->hFinalTorque * pHandle->hDirection,
                           (uint32_t)(pHandle->pCurrentPhaseParams->hDurationms));

        VSS_SetMecAcceleration(pHandle->pVSS,
                               pHandle->pCurrentPhaseParams->hFinalMecSpeedUnit * pHandle->hDirection,
                               pHandle->pCurrentPhaseParams->hDurationms);

        /* Compute hPhaseRemainingTicks */
        pHandle->hPhaseRemainingTicks = (uint16_t)((((uint32_t)pHandle->pCurrentPhaseParams->hDurationms)
                                                  * ((uint32_t)pHandle->hRUCFrequencyHz)) / 1000U );
        pHandle->hPhaseRemainingTicks++;

        /* Set the next phases parameter pointer */
        pHandle->pCurrentPhaseParams = pHandle->pCurrentPhaseParams->pNext; //cstat !MISRAC2012-Rule-11.5

        /* Increases the rev up stages counter */
        pHandle->bStageCnt++;
      }
      else
      {
        retVal = false;
      }
    }
    else
    {
      /* Nothing to do */
    }
#ifdef NULL_PTR_CHECK_REV_UP_CTL
  }
#endif
  return (retVal);
}

/**
  * @brief  It checks if this stage is used for align motor.
  * @param  pHandle: Pointer on Handle structure of RevUp controller.
  * @retval Returns 1 if the alignment is correct otherwise it returns 0
  */
//cstat !MISRAC2012-Rule-8.13
uint8_t RUC_IsAlignStageNow(RevUpCtrl_Handle_t *pHandle)
{
  uint8_t align_flag = 0;
#ifdef NULL_PTR_CHECK_REV_UP_CTL
  if (MC_NULL == pHandle)
  {
    /* Nothing to do */
  }
  else
  {
#endif
    int16_t speed;
    speed = RUC_GetPhaseFinalMecSpeed01Hz(pHandle, pHandle->bStageCnt);
    if (0 == speed)
    {
      align_flag = 1;
    }
    else
    {
      /* Nothing to do */
    }
#ifdef NULL_PTR_CHECK_REV_UP_CTL
  }
#endif
  return (align_flag);
}

#if defined (CCMRAM)
#if defined (__ICCARM__)
#pragma location = ".ccmram"
#elif defined (__CC_ARM) || defined(__GNUC__)
__attribute__((section(".ccmram")))
#endif
#endif

/**
  * @brief  Check that alignment and first acceleration stage are completed.
  * @param  pHandle: Pointer on Handle structure of RevUp controller.
  *  @retval Boolean set to true when first acceleration stage has been reached.
  */
__weak bool RUC_FirstAccelerationStageReached(RevUpCtrl_Handle_t *pHandle)
{
  bool retVal = false;
#ifdef NULL_PTR_CHECK_REV_UP_CTL
  if (MC_NULL == pHandle)
  {
    /* Nothing to do */
  }
  else
  {
#endif
    if (pHandle->bStageCnt >= pHandle->bFirstAccelerationStage)
    {
      retVal = true;
    }
    else
    {
      /* Nothing to do */
    }
#ifdef NULL_PTR_CHECK_REV_UP_CTL
  }
#endif
  return (retVal);
}

/**
  * @brief  Allow to modify duration of a selected phase.
  * @param  pHandle: Pointer on Handle structure of RevUp controller.
  * @param  bPhase: RevUp phase where new duration shall be modified.
  *         This parameter must be a number between 0 and 6.
  * @param  hDurationms: new duration value required for associated phase.
  *         This parameter must be set in millisecond.
  */
__weak void RUC_SetPhaseDurationms(RevUpCtrl_Handle_t *pHandle, uint8_t bPhase, uint16_t hDurationms)
{
#ifdef NULL_PTR_CHECK_REV_UP_CTL
  if (MC_NULL == pHandle)
  {
    /* Nothing to do */
  }
  else
  {
#endif
    pHandle->ParamsData[bPhase].hDurationms = hDurationms;
#ifdef NULL_PTR_CHECK_REV_UP_CTL
  }
#endif
}

/**
  * @brief  Allow to modify targeted mechanical speed of a selected phase.
  * @param  pHandle: Pointer on Handle structure of RevUp controller.
  * @param  bPhase: RevUp phase where new mechanical speed shall be modified.
  *         This parameter must be a number between 0 and 6.
  * @param  hFinalMecSpeedUnit: new targeted mechanical speed.
  *         This parameter must be expressed in 0.1Hz.
  */
__weak void RUC_SetPhaseFinalMecSpeedUnit(RevUpCtrl_Handle_t *pHandle, uint8_t bPhase, int16_t hFinalMecSpeedUnit)
{
#ifdef NULL_PTR_CHECK_REV_UP_CTL
  if (MC_NULL == pHandle)
  {
    /* Nothing to do */
  }
  else
  {
#endif
    pHandle->ParamsData[bPhase].hFinalMecSpeedUnit = hFinalMecSpeedUnit;
#ifdef NULL_PTR_CHECK_REV_UP_CTL
  }
#endif
}

/**
  * @brief  Allow to modify targeted the motor torque of a selected phase.
  * @param  pHandle: Pointer on Handle structure of RevUp controller.
  * @param  bPhase: RevUp phase where new the motor torque shall be modified.
  *         This parameter must be a number between 0 and 6.
  * @param  hFinalTorque: new targeted motor torque.
  */
__weak void RUC_SetPhaseFinalTorque(RevUpCtrl_Handle_t *pHandle, uint8_t bPhase, int16_t hFinalTorque)
{
#ifdef NULL_PTR_CHECK_REV_UP_CTL
  if (MC_NULL == pHandle)
  {
    /* Nothing to do */
  }
  else
  {
#endif
    pHandle->ParamsData[bPhase].hFinalTorque = hFinalTorque;
#ifdef NULL_PTR_CHECK_REV_UP_CTL
  }
#endif
}

/**
  * @brief  Allow to read duration set in selected phase.
  * @param  pHandle: Pointer on Handle structure of RevUp controller.
  * @param  bPhase: RevUp phase from where duration is read.
  *         This parameter must be a number between 0 and 6.
  *  @retval Returns duration used in selected phase in ms unit.
  */
__weak uint16_t RUC_GetPhaseDurationms(RevUpCtrl_Handle_t *pHandle, uint8_t bPhase)
{
#ifdef NULL_PTR_CHECK_REV_UP_CTL
  return ((MC_NULL == pHandle) ? 0U : (uint16_t)pHandle->ParamsData[bPhase].hDurationms);
#else
  return ((uint16_t)pHandle->ParamsData[bPhase].hDurationms);
#endif
}

/**
  * @brief  Allow to read targeted rotor speed set in selected phase.
  * @param  pHandle: Pointer on Handle structure of RevUp controller.
  * @param  bPhase: RevUp phase from where targeted rotor speed is read.
  *         This parameter must be a number between 0 and 6.
  *  @retval Returns targeted rotor speed set for a selected phase.
  */
__weak int16_t RUC_GetPhaseFinalMecSpeedUnit(RevUpCtrl_Handle_t *pHandle, uint8_t bPhase)
{
#ifdef NULL_PTR_CHECK_REV_UP_CTL
  return ((MC_NULL == pHandle) ? 0 : (int16_t)pHandle->ParamsData[bPhase].hFinalMecSpeedUnit);
#else
  return ((int16_t)pHandle->ParamsData[bPhase].hFinalMecSpeedUnit);
#endif
}

/**
  * @brief  Allow to read targeted motor torque set in selected phase.
  * @param  pHandle: Pointer on Handle structure of RevUp controller.
  * @param  bPhase: RevUp phase from where targeted motor torque is read.
  *         This parameter must be a number between 0 and 6.
  *  @retval Returns targeted motor torque set for a selected phase.
  */
__weak int16_t RUC_GetPhaseFinalTorque(RevUpCtrl_Handle_t *pHandle, uint8_t bPhase)
{

#ifdef NULL_PTR_CHECK_REV_UP_CTL
  return ((MC_NULL == pHandle) ? 0 : (int16_t)pHandle->ParamsData[bPhase].hFinalTorque);
#else
  return ((int16_t)pHandle->ParamsData[bPhase].hFinalTorque);
#endif
}

/**
  * @}
  */

/**
  * @}
  */

/**
  * @}
  */
 
/************************ (C) COPYRIGHT 2026 STMicroelectronics *****END OF FILE****/
