Azmi0205/Bachelorarbeit/05Software/STM_Workspace/Pilotix6SC_Measurement/Inc/pmsm_motor_parameters.h

/**
  ******************************************************************************
  * @file    pmsm_motor_parameters.h
  * @author  Motor Control SDK Team, ST Microelectronics
  * @brief   This file contains the parameters needed for the Motor Control SDK
  *          in order to configure the motor to drive.
  *
  ******************************************************************************
  * @attention
  *
  * <h2><center>&copy; Copyright (c) 2026 STMicroelectronics.
  * All rights reserved.</center></h2>
  *
  * This software component is licensed by ST under Ultimate Liberty license
  * SLA0044, the "License"; You may not use this file except in compliance with
  * the License. You may obtain a copy of the License at:
  *                             www.st.com/SLA0044
  *
  ******************************************************************************
  */

/* Define to prevent recursive inclusion -------------------------------------*/
#ifndef PMSM_MOTOR_PARAMETERS_H
#define PMSM_MOTOR_PARAMETERS_H

/************************
 *** Motor Parameters ***
 ************************/

/***************** MOTOR ELECTRICAL PARAMETERS  ******************************/
#define POLE_PAIR_NUM           14 /* Number of motor pole pairs */
#define RS                      0.13 /* Stator resistance , ohm*/
#define LS                      0.00001 /* Stator inductance, H
                                                 For I-PMSM it is equal to Lq */

/* When using Id = 0, NOMINAL_CURRENT is utilized to saturate the output of the
   PID for speed regulation (i.e. reference torque).
   Transformation of real currents (A) into int16_t format must be done accordingly with
   formula:
   Phase current (int16_t 0-to-peak) = (Phase current (A 0-to-peak)* 32767 * Rshunt *
                                   *Amplifying network gain)/(MCU supply voltage/2)
*/

#define MOTOR_VOLTAGE_CONSTANT  4.0 /*!< Volts RMS ph-ph /kRPM */
#define MOTOR_MAX_SPEED_RPM     2130 /*!< Maximum rated speed  */
#define NOMINAL_CURRENT_A       2.160

/***************** MOTOR SENSORS PARAMETERS  ******************************/
/* Motor sensors parameters are always generated but really meaningful only
   if the corresponding sensor is actually present in the motor         */

/*** Hall sensors ***/
#define HALL_SENSORS_PLACEMENT  DEGREES_120 /*!<Define here the
                                                 mechanical position of the sensors
                                                 withreference to an electrical cycle.
                                                 It can be either DEGREES_120 or
                                                 DEGREES_60 */

#define HALL_PHASE_SHIFT        300 /*!< Define here in degrees
                                                 the electrical phase shift between
                                                 the low to high transition of
                                                 signal H1 and the maximum of
                                                 the Bemf induced on phase A */
#endif /* PMSM_MOTOR_PARAMETERS_H */
/******************* (C) COPYRIGHT 2026 STMicroelectronics *****END OF FILE****/
