Azmi0205/Bachelorarbeit/05Software/STM_Workspace/Pilotix6SC_Measurement/MCSDK_v6.4.2-Full/MotorControl/MCSDK/MCLib/Any/Src/feed_forward_ctrl.c

/**
  ******************************************************************************
  * @file    feed_forward_ctrl.c
  * @author  Motor Control SDK Team, ST Microelectronics
  * @brief   This file provides firmware functions that implement the Feed-forward
  *          Control component of the Motor Control SDK.
  *
  ******************************************************************************
  * @attention
  *
  * <h2><center>&copy; Copyright (c) 2026 STMicroelectronics International N.V.
  * All rights reserved.</center></h2>
  *
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
  ******************************************************************************
  * @ingroup FeedForwardCtrl
  */

/* Includes ------------------------------------------------------------------*/
#include "feed_forward_ctrl.h"
#include <stddef.h>

#include "mc_type.h"
#include "bus_voltage_sensor.h"
#include "speed_pos_fdbk.h"
#include "speed_torq_ctrl.h"
#include "r_divider_bus_voltage_sensor.h"

/** @addtogroup MCSDK
  * @{
  */


/** @addtogroup ConvFOC
  * @{
  */

/** @addtogroup MCLLAPI
  * @{
  */

/** @defgroup FeedForwardCtrl Feed-forward Control
  * @brief Feed-forward Control component of the Motor Control SDK
  *
  * See the [Feed-forward chapter of the User Manual](feed_forward_current_regulation.md) for more details on the theoretical
  * background of this regulator.
  * @{
  */

/* Private macros ------------------------------------------------------------*/
#define SEGMNUM (uint8_t)7 /* coeff no. -1 */
#define SATURATION_TO_S16(a)    if ((a) > 32767)                \
  {                               \
    (a) = 32767;                  \
  }                               \
  else if ((a) < -32767)          \
  {                               \
    (a) = -32767;                 \
  }                               \
  else                            \
  {}                              \




/**
  * @brief  Initializes all the component variables
  * @param  pHandle Feed-forward init structure.
  * @param  pBusSensor VBus Sensor.
  * @param  pPIDId Id PID structure.
  * @param  pPIDIq Iq PID structure.
  */
__weak void FF_Init(FF_Handle_t *pHandle, BusVoltageSensor_Handle_t *pBusSensor, PID_Handle_t *pPIDId,
                    PID_Handle_t *pPIDIq)
{
#ifdef NULL_PTR_CHECK_FEED_FWD_CTRL
  if (NULL == pHandle)
  {
    /* Nothing to do */
  }
  else
  {
#endif
    pHandle->wConstant_1D = pHandle->wDefConstant_1D;
    pHandle->wConstant_1Q = pHandle->wDefConstant_1Q;
    pHandle->wConstant_2  = pHandle->wDefConstant_2;

    pHandle->pBus_Sensor = pBusSensor;

    pHandle->pPID_d = pPIDId;

    pHandle->pPID_q = pPIDIq;
#ifdef NULL_PTR_CHECK_FEED_FWD_CTRL
  }
#endif
}

/**
  * @brief  It should be called before each motor start and clears the Feed-forward
  *         internal variables.
  * @param  pHandle Feed-forward structure.
  */
__weak void FF_Clear(FF_Handle_t *pHandle)
{
#ifdef NULL_PTR_CHECK_FEED_FWD_CTRL
  if (NULL == pHandle)
  {
    /* Nothing to do */
  }
  else
  {
#endif
    pHandle->Vqdff.q = (int16_t)0;
    pHandle->Vqdff.d = (int16_t)0;
#ifdef NULL_PTR_CHECK_FEED_FWD_CTRL
  }
#endif
}

/**
  * @brief  It implements Feed-forward controller by computing new Vqdff value.
  *         This will be then summed up to PI output in FF_VqdConditioning
  *         method.
  * @param  pHandle Feed-forward structure.
  * @param  Iqdref Iqd reference components used to calculate the Feed-forward
  *         action.
  * @param  pSTC Pointer on speed and torque controller structure.
  */
__weak void FF_VqdffComputation(FF_Handle_t *pHandle, qd_t Iqdref, SpeednTorqCtrl_Handle_t *pSTC)
{
#ifdef NULL_PTR_CHECK_FEED_FWD_CTRL
  if (NULL == pHandle)
  {
    /* Nothing to do */
  }
  else
  {
#endif
    int32_t wtemp1, wtemp2;
    int16_t hSpeed_dpp;
    uint16_t hAvBusVoltage_d;
    SpeednPosFdbk_Handle_t *SpeedSensor;

    SpeedSensor = STC_GetSpeedSensor(pSTC);
    hSpeed_dpp = SPD_GetElSpeedDpp(SpeedSensor);
    hAvBusVoltage_d = VBS_GetAvBusVoltage_d(pHandle->pBus_Sensor) / 2U;

    if (hAvBusVoltage_d != (uint16_t)0)
    {
      /*q-axes ff voltage calculation */
      wtemp1 = (((int32_t)(hSpeed_dpp) * Iqdref.d) / (int32_t)32768);
      wtemp2 = (wtemp1 * pHandle->wConstant_1D) / (int32_t)(hAvBusVoltage_d);
      wtemp2 *= (int32_t)2;

      wtemp1 = ((pHandle->wConstant_2 * hSpeed_dpp) / (int32_t)hAvBusVoltage_d) * (int32_t)16;

      wtemp2 = wtemp1 + wtemp2;

      SATURATION_TO_S16(wtemp2)

      pHandle->Vqdff.q = (int16_t)(wtemp2);

      /* d-axes ff voltage calculation */
      wtemp1 = (((int32_t)(hSpeed_dpp) * Iqdref.q) / (int32_t)32768);
      wtemp2 = (wtemp1 * pHandle->wConstant_1Q) / (int32_t)(hAvBusVoltage_d);
      wtemp2 *= (int32_t)(-2);

      SATURATION_TO_S16(wtemp2)

      pHandle->Vqdff.d = (int16_t)(wtemp2);
    }
    else
    {
      pHandle->Vqdff.q = (int16_t)0;
      pHandle->Vqdff.d = (int16_t)0;
    }
#ifdef NULL_PTR_CHECK_FEED_FWD_CTRL
  }
#endif
}

//cstat #MISRAC2012-Rule-2.2_b
/* False positive  */
#if defined (CCMRAM)
#if defined (__ICCARM__)
#pragma location = ".ccmram"
#elif defined (__CC_ARM) || defined(__GNUC__)
__attribute__((section(".ccmram")))
#endif
#endif
/**
  * @brief  It returns the Vqd components computed by input plus the Feed-forward
  *         action and store the last Vqd values in the internal variable.
  * @param  pHandle Feed-forward structure.
  * @param  Vqd Initial value of Vqd to be manipulated by Feed-forward action .
  * @retval qd_t Vqd conditioned values.
  */
__weak qd_t FF_VqdConditioning(FF_Handle_t *pHandle, qd_t Vqd)
{
  qd_t lVqd;
#ifdef NULL_PTR_CHECK_FEED_FWD_CTRL
  if (NULL == pHandle)
  {
    lVqd.q = 0;
    lVqd.d = 0;
  }
  else
  {
#endif
    int32_t wtemp;

    pHandle->VqdPIout = Vqd;

    wtemp = (int32_t)(Vqd.q) + pHandle->Vqdff.q;

    SATURATION_TO_S16(wtemp)

    lVqd.q = (int16_t)wtemp;

    wtemp = (int32_t)(Vqd.d) + pHandle->Vqdff.d;

    SATURATION_TO_S16(wtemp)

    lVqd.d = (int16_t)wtemp;
#ifdef NULL_PTR_CHECK_FEED_FWD_CTRL
  }
#endif
  return (lVqd);
}

#if defined (CCMRAM)
#if defined (__ICCARM__)
#pragma location = ".ccmram"
#elif defined (__CC_ARM) || defined(__GNUC__)
__attribute__((section(".ccmram")))
#endif
#endif
/**
  * @brief  It low-pass filters the Vqd voltage coming from the speed PI. Filter
  *         bandwidth depends on hVqdLowPassFilterBW parameter.
  * @param  pHandle Feed-forward structure.
  */
__weak void FF_DataProcess(FF_Handle_t *pHandle)
{
#ifdef NULL_PTR_CHECK_FEED_FWD_CTRL
  if (NULL == pHandle)
  {
    /* Nothing to do */
  }
  else
  {
#endif
    int32_t wAux;
    int32_t lowPassFilterBW = (int32_t) pHandle->hVqdLowPassFilterBW - (int32_t)1;

#ifndef FULL_MISRA_C_COMPLIANCY_FWD_FDB
    /* Computation of average Vqd as output by PI(D) current controllers, used by
       Feed-forward controller algorithm */
    wAux = (int32_t)(pHandle->VqdAvPIout.q) * lowPassFilterBW;
    wAux += pHandle->VqdPIout.q;
    //cstat !MISRAC2012-Rule-1.3_n !ATH-shift-neg !MISRAC2012-Rule-10.1_R6
    pHandle->VqdAvPIout.q = (int16_t)(wAux >> pHandle->hVqdLowPassFilterBWLOG);

    wAux = (int32_t)(pHandle->VqdAvPIout.d) * lowPassFilterBW;
    wAux += pHandle->VqdPIout.d;
    //cstat !MISRAC2012-Rule-1.3_n !ATH-shift-neg !MISRAC2012-Rule-10.1_R6
    pHandle->VqdAvPIout.d = (int16_t)(wAux >> pHandle->hVqdLowPassFilterBWLOG);

#else
    /* Computation of average Vqd as output by PI(D) current controllers, used by
       Feed-forward controller algorithm */
    wAux = (int32_t)(pHandle->VqdAvPIout.q) * lowPassFilterBW;
    wAux += pHandle->VqdPIout.q;

    pHandle->VqdAvPIout.q = (int16_t)(wAux / (int32_t)(pHandle->hVqdLowPassFilterBW));

    wAux = (int32_t)(pHandle->VqdAvPIout.d) * lowPassFilterBW;
    wAux += pHandle->VqdPIout.d;

    pHandle->VqdAvPIout.d = (int16_t)(wAux / (int32_t)(pHandle->hVqdLowPassFilterBW));
#endif
#ifdef NULL_PTR_CHECK_FEED_FWD_CTRL
  }
#endif
}

/**
  * @brief  Use this method to initialize FF variables in START_TO_RUN state.
  * @param  pHandle Feed-forward structure.
  */
__weak void FF_InitFOCAdditionalMethods(FF_Handle_t *pHandle)
{
#ifdef NULL_PTR_CHECK_FEED_FWD_CTRL
  if (NULL == pHandle)
  {
    /* Nothing to do */
  }
  else
  {
#endif
    pHandle->VqdAvPIout.q = 0;
    pHandle->VqdAvPIout.d = 0;
    PID_SetIntegralTerm(pHandle->pPID_q, 0);
    PID_SetIntegralTerm(pHandle->pPID_d, 0);
#ifdef NULL_PTR_CHECK_FEED_FWD_CTRL
  }
#endif
}

/**
  * @brief  Use this method to set new constants values used by
  *         Feed-forward algorithm.
  * @param  pHandle Feed-forward structure.
  * @param  sNewConstants The FF_TuningStruct_t containing constants used by
  *         Feed-forward algorithm.
  */
__weak void FF_SetFFConstants(FF_Handle_t *pHandle, FF_TuningStruct_t sNewConstants)
{
#ifdef NULL_PTR_CHECK_FEED_FWD_CTRL
  if (NULL == pHandle)
  {
    /* Nothing to do */
  }
  else
  {
#endif
    pHandle->wConstant_1D = sNewConstants.wConst_1D;
    pHandle->wConstant_1Q = sNewConstants.wConst_1Q;
    pHandle->wConstant_2  = sNewConstants.wConst_2;
#ifdef NULL_PTR_CHECK_FEED_FWD_CTRL
  }
#endif
}


//cstat #MISRAC2012-Rule-2.2_b
/* False positive  */
/**
  * @brief  Use this method to get current constants values used by
  *         Feed-forward algorithm.
  * @param  pHandle Feed-forward structure.
  * @retval FF_TuningStruct_t Values of the constants used by
  *         Feed-forward algorithm.
  */
//cstat !MISRAC2012-Rule-8.13
__weak FF_TuningStruct_t FF_GetFFConstants(FF_Handle_t *pHandle)
{
  FF_TuningStruct_t LocalConstants;
#ifdef NULL_PTR_CHECK_FEED_FWD_CTRL
  if (NULL == pHandle)
  {
    LocalConstants.wConst_1D = 0;
    LocalConstants.wConst_1Q = 0;
    LocalConstants.wConst_2 = 0;
  }
  else
  {
#endif
    LocalConstants.wConst_1D = pHandle->wConstant_1D;
    LocalConstants.wConst_1Q = pHandle->wConstant_1Q;
    LocalConstants.wConst_2 =  pHandle->wConstant_2;
#ifdef NULL_PTR_CHECK_FEED_FWD_CTRL
  }
#endif
  return (LocalConstants);
}


/**
  * @brief  Use this method to get present values for the Vqd Feed-forward
  *         components.
  * @param  pHandle Feed-forward structure.
  * @retval qd_t Vqd Feed-forward components.
  */
__weak qd_t FF_GetVqdff(const FF_Handle_t *pHandle)
{
#ifdef NULL_PTR_CHECK_FEED_FWD_CTRL
  qd_t retqt;
  if (NULL == pHandle)
  {
    retqt.q = 0;
    retqt.d = 0;
  }
  else
  {
    retqt = pHandle->Vqdff;
  }
  return (retqt);
#else
  return (pHandle->Vqdff);
#endif
}

/**
  * @brief  Use this method to get the averaged output values of qd axes
  *         currents PI regulators.
  * @param  pHandle Feed-forward structure.
  * @retval qd_t Averaged output of qd axes currents PI regulators.
  */
__weak qd_t FF_GetVqdAvPIout(const FF_Handle_t *pHandle)
{
#ifdef NULL_PTR_CHECK_FEED_FWD_CTRL
  qd_t retqt;
  if (NULL == pHandle)
  {
    retqt.q = 0;
    retqt.d = 0;
  }
  else
  {
    retqt = pHandle->VqdAvPIout;
  }
  return (retqt);
#else
  return (pHandle->VqdAvPIout);
#endif
}

/**
  * @}
  */

/**
  * @}
  */

/************************ (C) COPYRIGHT 2026 STMicroelectronics *****END OF FILE****/
