Azmi0205/Bachelorarbeit/05Software/STM_Workspace/Pilotix6SC_Measurement/MCSDK_v6.4.2-Full/MotorControl/MCSDK/MCLib/Any/Src/enc_align_ctrl.c

/**
  ******************************************************************************
  * @file    enc_align_ctrl.c
  * @author  Motor Control SDK Team, ST Microelectronics
  * @brief   This file provides firmware functions that implement the features
  *          of the Encoder Alignment Control component of the Motor Control SDK.
  ******************************************************************************
  * @attention
  *
  * <h2><center>&copy; Copyright (c) 2026 STMicroelectronics.
  * All rights reserved.</center></h2>
  *
  * This software component is licensed by ST under Ultimate Liberty license
  * SLA0044, the "License"; You may not use this file except in compliance with
  * the License. You may obtain a copy of the License at:
  *                             www.st.com/SLA0044
  *
  ******************************************************************************
  * @ingroup EncAlignCtrl
  */

/* Includes ------------------------------------------------------------------*/
#include "enc_align_ctrl.h"
#include "mc_type.h"

/** @addtogroup MCSDK
  * @{
  */


/** @addtogroup ConvFOC
  * @{
  */

/** @addtogroup MCLLAPI
  * @{
  */

/** @defgroup EncAlignCtrl Encoder Alignment Controller
  * @brief Encoder Alignment Controller component of the Motor Control SDK
  *
  * Initial encoder calibration which comprises a rotor alignment in a given position
  * necessary to make the information coming from a quadrature encoder absolute.
  * @{
  */

/**
  * @brief  It initializes the handle
  * @param  pHandle: handler of the current instance of the EncAlignCtrl component.
  * @param  pSTC: Pointer to Speed and Torque Controller structure used by the EAC.
  * @param  pVSS: Pointer to Virtual Speed Sensor structure used by the EAC.
  * @param  pENC: Pointer to ENCoder structure used by the EAC.
  */
__weak void EAC_Init(EncAlign_Handle_t *pHandle, SpeednTorqCtrl_Handle_t *pSTC, VirtualSpeedSensor_Handle_t *pVSS,
                     ENCODER_Handle_t *pENC)
{
#ifdef NULL_PTR_CHECK_ENC_ALI_CTRL
  if (NULL == pHandle)
  {
    /* Nothing to do */
  }
  else
  {
#endif
    pHandle->pSTC = pSTC;
    pHandle->pVSS = pVSS;
    pHandle->pENC = pENC;
    pHandle->EncAligned = false;
    pHandle->EncRestart = false;
#ifdef NULL_PTR_CHECK_ENC_ALI_CTRL
  }
#endif
}

/**
  * @brief  It starts the encoder alignment procedure.
  * It configures the VSS (Virtual Speed Sensor) with the required angle and sets the
  * STC (Speed and Torque Controller) to execute the required torque ramp.
  * @param  pHandle: handler of the current instance of the EncAlignCtrl component.
  */
__weak void EAC_StartAlignment(EncAlign_Handle_t *pHandle)
{
#ifdef NULL_PTR_CHECK_ENC_ALI_CTRL
  if (NULL == pHandle)
  {
    /* Nothing to do */
  }
  else
  {
#endif
    uint32_t wAux;

    /* Set pVSS mechanical speed to zero */
    VSS_SetMecAcceleration(pHandle->pVSS, 0, 0U);

    /* Set pVSS mechanical angle */
    VSS_SetMecAngle(pHandle->pVSS, pHandle->hElAngle);

    /* Set pSTC in MCM_TORQUE_MODE */
    STC_SetControlMode(pHandle->pSTC, MCM_TORQUE_MODE);

    /* Set starting torque to Zero */
    (void)STC_ExecRamp(pHandle->pSTC, 0, 0U);

    /* Execute the torque ramp */
    (void)STC_ExecRamp(pHandle->pSTC, pHandle->hFinalTorque, (uint32_t)pHandle->hDurationms);
    /* Compute hRemainingTicks, the number of thick of alignment phase */
    wAux = ((uint32_t)pHandle->hDurationms) * ((uint32_t)pHandle->hEACFrequencyHz);
    wAux /= 1000U;
    pHandle->hRemainingTicks = (uint16_t)wAux;
    pHandle->hRemainingTicks++;
#ifdef NULL_PTR_CHECK_ENC_ALI_CTRL
  }
#endif
}

/**
  * @brief  It executes the encoder alignment controller and must be called with a
  *         frequency equal to the one settled in the parameters
  *         hEACFrequencyHz. Calling this method the EAC is able to verify
  *         if the alignment duration has been finished. At the end of alignment
  *         the encoder is set to the defined mechanical angle.
  *         Note: STC and VSS are not called by EAC_Exec.
  * @param  pHandle: handler of the current instance of the EncAlignCtrl component.
  * @retval bool It returns true when the programmed alignment has been
  *         completed.
  */
__weak bool EAC_Exec(EncAlign_Handle_t *pHandle)
{
  bool retVal = true;
#ifdef NULL_PTR_CHECK_ENC_ALI_CTRL
  if (NULL == pHandle)
  {
    retVal = false;
  }
  else
  {
#endif
    if (pHandle->hRemainingTicks > 0U)
    {
      pHandle->hRemainingTicks--;

      if (0U == pHandle->hRemainingTicks)
      {
        /* At the end of Alignment procedure, we set the encoder mechanical angle to the alignement angle */
        ENC_SetMecAngle(pHandle->pENC, pHandle->hElAngle / ((int16_t)pHandle->bElToMecRatio));
        pHandle->EncAligned = true;
        retVal = true;
      }
      else
      {
        retVal = false;
      }
    }
    else
    {
      /* Nothing to do */
    }
#ifdef NULL_PTR_CHECK_ENC_ALI_CTRL
  }
#endif

  return (retVal);
}

/**
  * @brief  Returns true if a restart after an encoder alignment has been requested.
  * @param  pHandle: handler of the current instance of the EncAlignCtrl component.
  * @retval bool Encoder Alignment restart order flag
  */
__weak bool EAC_GetRestartState(EncAlign_Handle_t *pHandle) //cstat !MISRAC2012-Rule-8.13
{
#ifdef NULL_PTR_CHECK_ENC_ALI_CTRL
  return ((NULL == pHandle) ? false : pHandle->EncRestart);
#else
  return (pHandle->EncRestart);
#endif
}

/**
  * @}
  */

/**
  * @}
  */

/************************ (C) COPYRIGHT 2026 STMicroelectronics *****END OF FILE****/
