Azmi0205/Bachelorarbeit/(commit log)

2026-01-22 added CAN + minor changes
    [AS5047P-ATSM.step, BM06B-GHS-TBT.step, FCR7350R.step, HalfBridgePowerStage.kicad_sch, ICM-40609-D--3DModel-STEP-269445.STEP, ICM-40609-D.step, ISM330BXTR.step, MTSW-104-22-L-D-265-RA.stp]
2026-05-01 Added Footprints for Passive components
    [HalfBridgePowerStage.kicad_sch, InverterStage.kicad_sch, NucleoMorpho.kicad_sch, PhaseSense.kicad_sch, PowerGen.kicad_sch, SensorSheet.kicad_sch, Testplatine.kicad_pcb, Testplatine.kicad_sch]
2026-05-20 Layout progress
    [HalfBridgePowerStage.kicad_sch, NucleoMorpho.kicad_sch, PowerGen.kicad_sch, SensorSheet.kicad_sch, Testplatine.kicad_pcb, connector.kicad_sch, escSheet.kicad_sch]
2026-05-22 routed signals
    [Testplatine.kicad_pcb, connector.kicad_sch, escSheet.kicad_sch]
2026-05-25 Design 1.0 Finished
    [HalfBridgePowerStage.kicad_sch, NucleoMorpho.kicad_sch, PowerGen.kicad_sch, SensorSheet.kicad_sch, Testplatine.kicad_pcb, connector.kicad_sch, escSheet.kicad_sch]
2026-07-14 Changed Some Capacitor Sizes, Added Capacitors in Power Gen
    [HalfBridgePowerStage.kicad_sch, NucleoMorpho.kicad_sch, PowerGen.kicad_sch, SensorSheet.kicad_sch, Testplatine.kicad_pcb, Testplatine.kicad_sch, connector.kicad_sch, escSheet.kicad_sch]
2026-07-14 Reworked Half-Bridge and Power-Gen
    [PowerGen.kicad_sch, Testplatine.kicad_pcb]
2026-07-14 added plugins, copied layout
    [Testplatine.kicad_pcb, transformations.csv]
2026-07-15 sensor sheet & Power delivery
    [PowerGen.kicad_sch, RJ45-8N-B.step, SensorSheet.kicad_sch, Testplatine.kicad_pcb, transformations.csv]
2026-07-15 revised halfbridge 24V input
    [Testplatine.kicad_pcb]
2026-07-16 Added Filters + CAN
    [Testplatine.kicad_pcb]
2026-07-16 main 5V supply
    [Testplatine.kicad_pcb]
2026-07-16 Added Signal Lines
    [NucleoMorpho.kicad_sch, Testplatine.kicad_pcb]
2026-07-16 All Signals Connected, Ethernet Cable
    [SensorSheet.kicad_sch, Testplatine.kicad_pcb, connector.kicad_sch]
2026-07-16 Review 16.07 - See Notes
    [Testplatine.kicad_pcb]
2026-07-17 All tracks routed
    [Testplatine.kicad_pcb]
2026-07-20 edited footprints
    [1622309.stp, HalfBridgePowerStage.kicad_sch, LMG2100R044RARR.stp, NucleoMorpho.kicad_sch, PowerGen.kicad_sch, SensorSheet.kicad_sch, Testplatine.kicad_pcb, connector.kicad_sch]
2026-07-20 Via stitching and edited footprints
    [Testplatine.kicad_pcb, escSheet.kicad_sch]
2026-07-21 Edited some more footprints and vias
    [Testplatine.kicad_pcb]
2026-07-21 Edited some connectors
    [1873802.stp, PowerGen.kicad_sch, SensorSheet.kicad_sch, Testplatine.kicad_pcb, connector.kicad_sch, escSheet.kicad_sch]
2026-07-22 relayout in progress
    [HalfBridgePowerStage.kicad_sch, PowerGen.kicad_sch, SensorSheet.kicad_sch, Testplatine.kicad_pcb, connector.kicad_sch, escSheet.kicad_sch]
2026-07-22 Edited Power Network
    [Testplatine.kicad_pcb]
2026-07-27 added ideal diode in schematic
    [PowerGen.kicad_sch, Testplatine.kicad_pcb]
2026-07-27 reverse polarity protection & Stitching
    [Testplatine.kicad_pcb]
2026-07-27 Final V1
    [PowerGen.kicad_sch, Testplatine.kicad_pcb]
2026-07-28 Final v2 & Fertigung
    [BOM_Testplatine.xlsx, PowerGen.kicad_sch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]
2026-08-05 reorganized, added some literature projectplan & images
    [Projektplan.xlsx]
2026-08-06 added some figures, continued writing theory
    [BetaLayout_BOM.xlsx]
2026-08-18 Added Simulink Data Library
    [BetaLayout_BOM_Rückfrage.xlsx]
2026-08-19 motor parameterization
2026-08-19 Added FOC Voltage Vector Saturation; TODO: Windup Protection
2026-08-20 six step Data logging; Electrical Power; PMSM Model adjustments
2026-08-26 added some ignores
    [BOM_Testplatine.xlsx, BetaLayout_BOM.xlsx, BetaLayout_BOM_Rückfrage.xlsx, BoM_Großteile.xlsx, SensorSheet_I2C.kicad_sch, T300_BoM_Erweitert.xlsx, T300_BoM_Notwendig.xlsx, T300_BoM_Optimal.xlsx]
2026-09-04 finished experiments (No Sin)
    [6SC_High_Measurement.csv, 6SC_Low_Measurement.csv, 6SC_Ramp_Measurement.csv, FOC_High_Measurement.csv, FOC_Low_Measurement.csv, FOC_Ramp_Measurement.csv]
