Azmi0205/Bachelorarbeit/(notices)

Notices in the files:
05Software/STM_Workspace/Pilotix6SC_Measurement/Inc/main.h:
This software is licensed under terms that can be found in the LICENSE file
02PCB_Design/02KiCad_Lib/MTSW-104-22-L-D-265-RA/MTSW-104-22-L-D-265-RA.stp:
author */ ('License CC BY-ND 4.0'),
